wklaaks/azelctrl/docs/AZELCtrl_Product_Guide.md

# AZELCtrl — Complete Product Guide

**Version 1.5.1**  
**Author: ZS6TW**  
**Date: July 2026**

---

## 1. Introduction

### 1.1 What is AZELCtrl?

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

### 1.2 The Problem It Solves

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

### 1.3 Target Audience

This product is designed for amateur radio operators who:

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

---

## 2. Key Features & Benefits

### 2.1 Core Features

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

### 2.2 Benefits Over Traditional Controllers

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

---

## 3. How It Works (High-Level Overview)

### 3.1 System Architecture

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

**Option 1: USB Serial Connection (Simpler, Direct)**
```
                                                            ┌────────────────────────────────┐
                                                            │   PC, Mac, Pi with             │
                                                            │   Satellite Tracking Software  │
                                                            │   (Gpredict, Rotor,etc)        │
                                                            └─────────┬──────────────────────┘
                                                                      │        USB Serial
                                                            USB cable │ (virtual COM port, 5V power)
                                                                      │
                                            ┌─────────────────────────│─────────────────────────────────────────────┐
                                            │ AZELCtrl                │                                             │
                                            │                         ▼                                             │
                                            │                ┌──────────────────┐                                   │
                                            │                │ ESP8266 (NodeMCU)│                                   │
                                            │                └────────┬─────────┘                                   │
                                            │                         │ Power + GPIOs                               │
                                            │                         ▼                                             │
                                            │               ┌──────────────────┐    Motor VCC (12-14V)              │
                                            │               │   Motor Shield   │◄────────────────────────┐          │     
                                            │    ┌──────────┤    (L293DD)      │────────────────────────►│          │ 
                                            │    │          └──┬───────────────┘    L, R, U, D, GND      │          │
                                            │    │             │                                         │          │ 
                                            │    │             │ I2C bus                                 │          │
                                            │    │             │ (SDA/SCL)                               │          │
                                            │    │        ┌────┴────┐                                    │          │  
                                            │    │        │         │                                    │          │  
                                            │    │        ▼         ▼                                    │          │   
                                            │    │   ┌────────┐ ┌────────┐                               │          │
                                            │    │   │ OLED   │ │ ADS1115│       Az, El Voltages         │          │
                                            │    │   │Display │ │ ADC    │◄──────────────────────────────┤          │
                                            │    │   │(128×64)│ │        │                               │          │
                                            │    │   └────────┘ └────────┘                               │          │
                                            │    │       ▲          ▲                                    │          │
                                            │    └───────┴──────────┘                  Yaesu DIN-8 Cable │          │
                                            │       Power (3.3V) & GND                                   │          │
                                            └────────────────────────────────────────────────────────────│──────────┘
                                                                                                         │
                                                                                                         ▼
                                                        ┌─────────────────┐                    ┌───────────────────┐      
                                                        │   Rotator       │                    │ Yaesu Rotator     │
                                                        │  (antenna)      │   ◄──────────►     │ Controller        │      
                                                        │                 │                    │ (G-5600B etc.)    │      
                                                        └─────────────────┘                    └───────────────────┘          
```

**Option 2: WiFi/TCP Connection (Remote, Flexible)**
```
                                            ┌───────────────────────────────┐     WiFi      ┌────────────┐
                                            │   PC, Mac, Pi, Phone with     │ ◄───────────► │            │
                                            │   Satellite Tracking Software │    TCP/IP     │  WiFi AP   │
                                            │   (Gpredict, Rotor)           │               │            │
                                            └───────────────────────────────┘               └────────────┘
                                                                                                  ▲ 
                                                                                                  │ WiFi TCP/IP             
                                                            ┌──────────────────────┐              │
                                                            │   USB Power Supply   │              │
                                                            └─────────┬────────────┘              │
                                                                      │                           │
                                                            USB cable │ (5V power only)           │
                                                                      │                           │
                                            ┌─────────────────────────│───────────────────────────│─────────────────┐
                                            │ AZELCtrl                │                           │                 │
                                            │                         ▼                           │                 │
                                            │                ┌─────────────────────────┐          │                 │
                                            │                │ ESP8266 (NodeMCU)| Wifi │ ◄────────┘                 │
                                            │                └────────┬────────────────┘                            │
                                            │                         │ Power + GPIOs                               │
                                            │                         ▼                                             │
                                            │               ┌──────────────────┐    Motor VCC (12-14V)              │
                                            │               │   Motor Shield   │◄────────────────────────┐          │     
                                            │    ┌──────────┤    (L293DD)      │────────────────────────►│          │ 
                                            │    │          └──┬───────────────┘    L, R, U, D, GND      │          │
                                            │    │             │                                         │          │ 
                                            │    │             │ I2C bus                                 │          │
                                            │    │             │ (SDA/SCL)                               │          │
                                            │    │        ┌────┴────┐                                    │          │  
                                            │    │        │         │                                    │          │  
                                            │    │        ▼         ▼                                    │          │   
                                            │    │   ┌────────┐ ┌────────┐                               │          │
                                            │    │   │ OLED   │ │ ADS1115│       Az, El Voltages         │          │
                                            │    │   │Display │ │ ADC    │◄──────────────────────────────┤          │
                                            │    │   │(128×64)│ │        │                               │          │
                                            │    │   └────────┘ └────────┘                               │          │
                                            │    │       ▲          ▲                                    │          │
                                            │    └───────┴──────────┘                  Yaesu DIN-8 Cable │          │
                                            │       Power (3.3V) & GND                                   │          │
                                            └────────────────────────────────────────────────────────────│──────────┘
                                                                                                         │
                                                                                                         ▼
                                                        ┌─────────────────┐                    ┌───────────────────┐      
                                                        │   Rotator       │                    │ Yaesu Rotator     │
                                                        │  (antenna)      │   ◄──────────►     │ Controller        │      
                                                        │                 │                    │ (G-5600B etc.)    │      
                                                        └─────────────────┘                    └───────────────────┘     

```

**The single Yaesu DIN-8 cable carries all signals:**

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

**Which option should you use?**

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

### 3.2 Data Flow

AZELCtrl supports two communication interfaces:

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

### 3.3 Power Flow

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

---

## 4. Technical Details

### 4.1 Hardware Components

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

### 4.2 Pin Assignments

#### ESP8266 → Motor Shield (Hard-Wired)

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

#### ESP8266 → External Components

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

#### Motor Shield → Yaesu DIN-8

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

#### ADS1115 → Yaesu DIN-8 (Position Feedback)

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

### 4.3 Motor Control Theory

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

### 4.4 I2C Bus Architecture

Both the OLED display and ADS1115 share the I2C bus:

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

### 4.5 Communication Interfaces and Protocol Stack

AZELCtrl supports two communication interfaces:

#### USB Serial Interface

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

#### TCP/IP Network Interface

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

#### GS-232 Command Reference

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

#### rotctl Command Reference

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

### 4.6 Coordinate Transformations

#### Rotator Model Variants

AZELCtrl supports four rotator model configurations:

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

#### Auto-Stop Logic

AZELCtrl implements mechanical offset tracking for extended-range models:

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

#### Preventing Tracking Oscillations

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

### 4.7 EEPROM Layout

Configuration data is persisted in EEPROM across power cycles:

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

### 4.8 Safety Mechanisms

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

---

## 5. Over-the-Top (ELF) Tracking Mode

### 5.1 The Wrap-Around Problem

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

### 5.2 The Geometric Principle

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

This mechanical capability is the key to the over-the-top technique.

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

The transformation is:

```
Real Azimuth   = (Satellite Azimuth + 180°) mod 360°
Real Elevation = 180° − Satellite Elevation
```

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

### 5.3 How AZELCtrl Implements ELF Mode

AZELCtrl implements ELF mode as a transparent coordinate transformation layer. When enabled:

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

### 5.4 When to Use ELF Mode

The over-the-top transformation should be applied when:

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

The over-the-top transformation should **not** be applied when:

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

### 5.5 Practical Considerations

- **Elevation rotator capability**: Verify that your elevation rotator physically supports movement beyond 90°. The Yaesu G-5600B, for example, supports 0–180° of elevation travel.
- **Pre-positioning before AOS**: For over-the-top passes, the antenna must be pre-positioned to the starting position before the satellite rises. This typically means the elevation will be near 180° while waiting for AOS.
- **Polarisation effects**: Flipping the antenna over the top rotates the polarisation plane by 180°. For circular polarisation this is irrelevant. For linear polarisation, you may need to adjust the polarisation rotator or accept a polarisation mismatch.
- **Decision timing**: The decision to use over-the-top mode must be made **before** the pass begins, based on a pre-computed prediction of the complete azimuth track. Switching modes mid-pass would require a large, sudden azimuth slew that would lose the satellite.

---

## 6. Menu System Reference

### 6.1 Button Behavior Summary

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

**Button actions in rotator control mode**:

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

**Button actions in menus**:

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

**Understanding the menu footer**:

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

The separator between actions is a space and a period (` . `) or a pipe (` | `). For example:

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

The footer adapts to the current screen's available actions.

### 6.2 Startup Screens

#### Splash Screen

On power-up, AZELCtrl displays a splash screen for 3 seconds:

```
AZELCtrl

Ver: 1.5.1
Date: Jul 19 2026
By: ZS6TW
```

Shows product name, firmware version, build date, and author.

#### Missing Settings

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

```
Missing
Settings!
```

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

#### Boot Menu

If all mandatory settings are configured, the Boot menu appears:

```
Boot
----
Rotator Ctrl
Setup

· · · · · · · · · · · · · · · ·
1.Nav 1|Sel
```

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

#### WiFi Connecting

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

```
WiFi Connect

SSID: YourWifiSSID
Waiting: 3s
```

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

#### WiFi Connected

On successful connection:

```
Connected!

IP: 192.168.1.42
Signal: -65 dBm
SSID: YourWifiSSID
                    3
```

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

#### WiFi Failed

If the connection times out:

```
WiFi
Failed

SSID: YourWifiSSID

Status: WL_CONNECT_FAILED
```

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

### 6.3 Main Az/El Control Screen

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

**Normal idle state** (no movement, no protocol commands):

```
Az:  125.3d →
El:   45.2d ↑

Sel: LEFT    ELF

· · · · · · · · · · · · · · · ·
1.Cycle 2!Go
```

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

**When moving** (but no protocol commands showing):

```
Az:  125.3d
El:   45.2d

Moving: RIGHT

· · · · · · · · · · · · · · · ·
1.Cycle 2!Go
```

Line 3 shows `Moving: direction` instead of `Sel:` while motors are active.

**When receiving protocol commands** (if Show Commands is enabled):

```
Az:  125.3d
El:   45.2d

· · · · · · · · · · · · · · · ·
RX: C
TX: AZ=125 EL=045
```

Lines 3-4 show the last received command (RX) and response (TX). This overlay is suppressed for 5 seconds after any button press so the menu stays visible during interaction.

**SAFETY PAUSE screen** (shown when reversing direction):

```
SAFETY PAUSE
------------
AZ axis
125.3d El: 45.2d

· · · · · · · · · · · · · · · ·
1.Cycle 2!Go
```

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

**ELF Indicator**: When ELF mode is enabled, "ELF" is displayed right-aligned on the `Sel:` line.

### 6.4 SETUP Menu

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

```
SETUP
-----
Rot Variant (N360)
Rot Calibrate (Y)
Network
PC Interface
Wipe all settings

· · · · · · · · · · · · · · · ·
1.Nav  1|Sel  2.Back
```

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

#### Rotator Variant Selection Screen

Selecting "Rot Variant" opens a dedicated model selection screen:

```
Rotator Variant?
----------------
N360 (-180 to 180)
S360 (0 to 360)
N450 (-225 to 225)
S450 (-45 to 405)

· · · · · · · · · · · · · · · ·
1.Nav  1|Sel  2.Back
```

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

#### Voltage Calibration Menu

Selecting "Rot Calibrate" opens the calibration menu:

```
Voltage Calibration
-------------------
Azimuth
Elevation
Skip (Az=El=3.2V)

· · · · · · · · · · · · · · · ·
1.Nav  1|Sel  2.Back
```

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

See section 6.6 for details on the calibration screens.

#### Network Submenu

Selecting "Network" opens the network settings menu:

```
Network
-------
WiFi Mode(Station)
Hamlib Server (Y)

· · · · · · · · · · · · · · · ·
1.Nav  1|Sel  2.Back
```

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

##### WiFi Mode Submenu

Selecting the WiFi Mode line opens the WiFi Mode submenu:

```
WiFi Mode
---------
Station
Access Point
Disable

· · · · · · · · · · · · · · · ·
1.Nav  1|Sel  2.Back
```

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

##### Station Settings Screen

Selecting "Station" opens the Station Settings screen:

```
Wifi Station Settings
---------------------
Set via HTTP
Connect

SSID: YourNetworkName
Passwd: a*..*z

· · · · · · · · · · · · · · · ·
1.Nav  1|Sel  2.Back
```

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

##### AP Mode Menu

Selecting "Access Point" opens the AP Mode menu:

```
AP Mode
-------
AP Status
Regen AP Password

· · · · · · · · · · · · · · · ·
1.Nav  1|Sel  2.Back
```

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

**Note**: WPA2 requires a minimum of 8 characters for the password.

**AP Status screen** shows:
```
AP Status
---------
AP Mode Active
SSID: AZELCTRL_4D49A1
Pass: yaesu123
IP: 192.168.4.1

· · · · · · · · · · · · · · · ·
1.OK 2.Back
```

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

#### PC Interface Submenu

Selecting "PC Interface" opens the PC interface settings menu:

```
PC Interface
------------
Baud Rate: 115200
Show Commands: Yes
Reverse Delay: 1s
Protocol (GS-232B)

· · · · · · · · · · · · · · · ·
1.Nav  1|Sel  2.Back
```

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

##### Baud Rate Selection

Selecting "Baud Rate" opens:

```
Select Baud Rate
----------------
115200
57600
38400
19200
9600

· · · · · · · · · · · · · · · ·
1.Nav  1|Sel  2.Back
```

Selecting a baud rate applies it immediately and returns to the PC Interface menu.

##### Protocol Selection

Selecting "Protocol" opens:

```
Protocol
--------
GS-232A (Yaesu)
GS-232B (Hamlib)
Easycom

· · · · · · · · · · · · · · · ·
1.Nav  1|Sel  2.Back
```

Selecting a protocol applies it immediately and returns to the PC Interface menu.

#### Wipe All Settings

Selecting "Wipe all settings" shows a confirmation screen:

```
Wipe all settings
-----------------
This will erase ALL
saved settings.

Continue?

· · · · · · · · · · · · · · · ·
1.Wipe  2.Back
```

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

### 6.5 ELF Mode Toggle

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

### 6.6 Calibration Screens

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

#### Calibration Menu

```
Voltage Calibration
-------------------
Azimuth
Elevation
Skip (Az=El=3.2V)

· · · · · · · · · · · · · · · ·
1.Nav  1|Sel  2.Back
```

#### Azimuth/Elevation Calibration Screen

When calibration is running:

```
Cal-AZ: Sweep CCW
Moving CCW...
 AZ:  -180.0 ( 123mV)
 EL:    45.2 (2400mV)
· · · · · · · · · · · · · · · ·
1.Exit 2.Back
```

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

#### Skip Calibration

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

### 6.7 ELF Elevation Prompt

Appears when ELF mode is toggled (enabled or disabled).

```
Elevate To?
-----------
Horizon (0) [5]
45
90
Skip

· · · · · · · · · · · · · · · ·
1.Nav  1|Sel  2.Back
```

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

---

## 7. Construction Guide

### 7.1 Parts List

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

**Notes on optional items**:

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

### 7.2 Tools Required

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

### 7.3 Box Preparation

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

### 7.4 Mounting the OLED

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

### 7.5 Using the Ribbon Jumper Cable

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

**How to use the ribbon jumper cable**:

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

### 7.6 Wiring the Buttons

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

### 7.7 Wiring the I2C Bus

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

Solder the connections to the ADS1115 module for mechanical security rather than using jumper blocks.

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

### 7.8 Wiring the Yaesu DIN-8 Connector

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

**Practical tips**:

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

### 7.9 Power Connections

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

### 7.10 Potentiometer Calibration (Before First Power-Up)

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

Steps:

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

### 7.11 Firmware Installation

1. Install the Arduino IDE or arduino-cli on your computer.
2. Install the ESP8266 board package.
3. Install required libraries: SSD1306 OLED driver, ADS1115 driver, EEPROM library.
4. Open the AZELCtrl firmware sketch.
5. Select board: "NodeMCU 1.0 (ESP-12E Module)" or equivalent.
6. Select port: Your ESP8266's serial port.
7. Upload the firmware.
8. Power up the unit and verify the OLED displays the startup sequence.

**Note**: WiFi credentials are configured via the captive portal setup process (see section 7.12), not in the source code.

### 7.12 Configuring WiFi via Captive Portal

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

---

## 8. Operating the Device

### 8.1 Power-Up Sequence

1. Connect power via USB (or VIN terminal).
2. OLED displays the splash screen for 3 seconds:
   - Product name, firmware version, date, author
3. If mandatory settings are incomplete (rotator variant, calibration, WiFi mode), a "Missing Settings!" notice appears for 3 seconds, then the device goes directly to the SETUP menu.
4. Otherwise, the Boot menu appears:
   - "Rotator Ctrl" with a 3-second countdown (auto-selects if no button pressed)
   - "Setup" option
5. If "Rotator Ctrl" is selected and WiFi is configured:
   - WiFi connecting screen appears with SSID and elapsed time
   - On success: Connected screen with IP address, signal strength, 5-second countdown (press any button to skip)
   - On failure: "WiFi Failed!" screen for 2 seconds
6. OLED switches to the Az/El control screen.

### 8.2 Manual Control via Buttons

From the main Az/El control screen:

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

### 8.3 Remote Control via Web Interface

The web interface provides a touch-friendly control panel for operating the rotator from a phone, tablet, or computer.

**Accessing the web interface:**

- **AP Mode**: Connect to the AZELCTRL_XXXX network (password: yaesu123 or your custom password). The browser automatically opens to the Rotator Control page.
- **Station Mode**: Connect to the same WiFi network as AZELCtrl, then open a browser and navigate to the IP address shown on the OLED.

**Web interface features:**

- **Azimuth and Elevation** — Current position displayed with aligned decimal points
- **Moving status** — Shows current direction (IDLE, LEFT, RIGHT, UP, DOWN)
- **Directional buttons** — UP, LEFT, RIGHT, DOWN, and STOP arranged in a grid layout
- **Press and hold** — Tap and hold a direction button to move; release to stop
- **Real-time updates** — Position and status refresh every 300ms

### 8.4 Connecting Tracking Software

AZELCtrl can be controlled via USB serial or TCP/IP. Choose whichever interface suits your setup.

#### USB Serial Connection

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

#### TCP/IP Network Connection

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

#### Gpredict

Gpredict supports both USB serial and TCP/IP connections.

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

The connection path is: Gpredict → rotctld → AZELCtrl (USB serial).

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

#### Rotor

Rotor supports both USB serial and TCP/IP connections.

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

#### Other Tracking Software

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

### 8.5 Configuring via OLED Menus

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

## 9. Troubleshooting

### 9.1 OLED Shows Nothing

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

### 9.2 Motors Not Moving

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

### 9.3 ADS1115 Not Found

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

### 9.4 WiFi Connectivity Issues

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

### 9.5 Position Readings Incorrect

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

### 9.6 Tracking Software Connection Refused

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

---

## 10. Appendices

### 10.1 Yaesu DIN-8 Pinout Reference

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

### 10.2 ESP8266 Pin Mapping Table

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

### 10.3 Protocol Command Reference

#### GS-232B Commands

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

#### Easycom (EasyComm 2/3) Commands

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

#### rotctl Commands

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

### 10.4 EEPROM Layout

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

---

*End of Document*

*AZELCtrl — Built for amateur satellite operators, by amateur satellite operators.*

*73 ZS6TW*
