wklaaks/azelctrl/ycint/ycint.ino

/*********************************************************************
  Yaesu Rotator Controller - Menu System + WiFi Management
  
  Buttons:
    D8 (Btn1) - active HIGH
    D5 (Btn2) - active LOW
  
  I2C: SDA=D6 (GPIO12), SCL=D7 (GPIO13)
  ADS1115: Ch0 = Azimuth pot, Ch1 = Elevation pot
  
  MENU SYSTEM BUTTON BEHAVIOR:
    Btn1 short-press  = navigate cursor down (wraps to top)
    Btn1 long-press   = select current item
    Btn2              = go back to parent menu (or restart root menu)
    
  ROTATOR CONTROL BUTTON BEHAVIOR (preserved from original):
    Btn1 short-press  = cycle through directions
    Btn2 press        = START movement in selected direction
    Btn2 release      = STOP movement
    
  CALIBRATION BUTTON BEHAVIOR (preserved from original):
    Btn1              = exit calibration
    Btn2 press        = start scan / stop scan
    Btn2 long-press   = reverse direction during scanning
    
  WiFi modes:
    STA = connect to home WiFi (uses saved credentials)
    AP  = broadcast AZELCTRL for direct field access
*********************************************************************/

#include <Wire.h>
#include <Adafruit_SSD1306.h>
#include <Adafruit_ADS1X15.h>
#include <ESP8266WiFi.h>
#include <ESP8266WebServer.h>
#include <DNSServer.h>
#include <EEPROM.h>
#include <ESP8266HTTPClient.h>
#include <FS.h>
#include <cerrno>
#include <time.h>

// ==================== SPIFFS HTML ====================
// The ESP serves the HTML from SPIFFS (filesystem) if available,
// otherwise falls back to the compiled-in copy in PROGMEM.
// To upload: gzip -9 -c index.html > index.html.gz
//            curl -F "file=@index.html.gz" http://<ESP_IP>/upload
// World map coastline data is served separately from SPIFFS (/world_coastline.js)
// so the Map tab can show a warning if it's missing.
const char* spiffsHtmlFile = "/index.html.gz";
const char* spiffsCoastlineFile = "/world_coastline.js.gz";

// Compiled-in HTML fallback (gzip-compressed) — stored in flash via ICACHE_RODATA_ATTR
#include "index_gz.h"
// The xxd-generated array is named index_html_gz; wrap it for PROGMEM access
#define index_gz_size sizeof(index_html_gz)

// ==================== EEPROM LAYOUT ====================
// All settings in one contiguous block. Using 512 bytes = one full flash sector
// so ESP8266's EEPROM library loads everything into RAM on begin(). Every commit
// writes the complete sector atomically — no cross-contamination between saves.
#define EEPROM_SIZE        512

// Sector 0: WiFi credentials (bytes 0-66)
#define EEPROM_SSID_LEN    0
#define EEPROM_SSID_DATA   1
#define EEPROM_PASS_LEN    33
#define EEPROM_PASS_DATA   34
#define EEPROM_MAGIC_BYTE  66
#define EEPROM_MAGIC       0xAA

// Sector 1: Calibration data (bytes 67-83)
#define CAL_EEPROM_AZ_MIN  67
#define CAL_EEPROM_AZ_MAX  71
#define CAL_EEPROM_EL_MIN  75
#define CAL_EEPROM_EL_MAX  79
#define CAL_EEPROM_MAGIC   83
#define CAL_EEPROM_MAGIC_VAL 0xCA

// Sector 2: WiFi mode (bytes 84-85)
#define WIFI_MODE_EEPROM   84
#define WIFI_MODE_MAGIC    85
#define WIFI_MODE_MAGIC_VAL 0x4D

// Sector 3: Network settings (bytes 86-87)
#define EEPROM_NET_HAMLIB  86
#define EEPROM_NET_MAGIC   87
#define EEPROM_NET_MAGIC_VAL 0x4E

// Sector 4: Rotator model (bytes 88-89)
#define ROT_EEPROM_MODEL   88
#define ROT_EEPROM_MAGIC   89
#define ROT_EEPROM_MAGIC_VAL 0x5A

// ==================== FIRMWARE VERSION ====================
#define FIRMWARE_VERSION "1.5.11"
#define FIRMWARE_DATE __DATE__

// ==================== NETWORK PROTOCOL SERVER ====================
const int ROTCTL_PORT = 4533;  // Hamlib default port for rotctld
WiFiServer rotctlServer(ROTCTL_PORT);
WiFiClient rotctlClient;
bool rotctlConnected = false;
bool rotctlServerStarted = false;  // Guard against double init

// ==================== COMPILE-TIME DEBUG FLAGS ====================
// Set to 1 to enable debug output (prefixed with 'DBG:' for easy filtering)
// Set to 0 to disable all debug output (zero overhead)
#define DEBUG_ENABLED 0
#define DEBUG_PROTOCOL 1  // Debug protocol parsing details
#define DEBUG_MOVEMENT 1  // Debug movement commands

// Debug helper macros - output prefixed with 'DBG:' so Python tests can filter
#if DEBUG_ENABLED
  #define DBG_PRINT(msg) Serial.print("DBG:" msg)
  #define DBG_PRINTLN(msg) do { Serial.print("DBG:"); Serial.println(msg); } while(0)
  #define DBG_PRINT_VAL(val) Serial.print("DBG:" #val "="); Serial.print(val); Serial.println("")
#else
  #define DBG_PRINT(msg)
  #define DBG_PRINTLN(msg)
  #define DBG_PRINT_VAL(val)
#endif

// ==================== PROTOCOL CONFIGURATION ====================
// Enable GS-232A/B and Easycom protocol support
#define PROTOCOL_GS232A 1
#define PROTOCOL_GS232B 1
#define PROTOCOL_EASYCOM 1

// Baud rate for protocol serial communication (USB)
#define PROTOCOL_BAUD 115200

// Protocol command buffer size
#define PROTOCOL_BUF_SIZE 64

// ==================== PIN DEFINITIONS ====================
const int AZ_ENABLE  = 4;   // GPIO4
const int AZ_DIR_CW  = 0;   // GPIO0
const int EL_ENABLE  = 5;   // GPIO5
const int EL_DIR_UP  = 2;   // GPIO2

const int SDA_PIN = 12;     // GPIO12

const int SCL_PIN = 13;     // GPIO13

const int BTN1 = 15;         // GPIO15 - active HIGH
const int BTN2 = 14;         // GPIO14 - active LOW
// ==================== BUTTON TIMING ====================
const unsigned long BTN_DEBOUNCE_MS = 200;   // Debounce between presses
const unsigned long BTN_LONG_MS = 800;       // Long press threshold for menu select
const unsigned long BTN2_LONG_MS = 500;      // Btn2 long press for calibration reverse

// ==================== WiFi AP SETTINGS ====================
char apSsid[17];  // "AZELCTRL_" (9) + 4 hex digits + null = 14 max
const char* AP_IP   = "192.168.4.1";
char apPassword[9] = "yaesu123";  // 8 chars minimum for WPA2 + null terminator

// AP Password EEPROM storage (bytes 91-99: 8 chars + magic)
#define AP_PASS_EEPROM_START 91
#define AP_PASS_EEPROM_MAGIC 99
#define AP_PASS_EEPROM_MAGIC_VAL 0x41  // 'A'

void initApSsid() {
  uint8_t mac[6];
  WiFi.macAddress(mac);
  snprintf(apSsid, sizeof(apSsid), "AZELCTRL_%04X", (uint16_t)((mac[4] << 8) | mac[5]));
  Serial.println("AP SSID: " + String(apSsid));
}

// ==================== OBJECTS ====================
Adafruit_SSD1306 display(128, 64, &Wire, -1);
Adafruit_ADS1115 ads;
ESP8266WebServer server(80);
DNSServer dnsServer;

// ==================== STATE ====================
float currentAz = 0.0, currentEl = 0.0;
float azVoltage = 0.0, elVoltage = 0.0;  // Raw voltages from readPositions()
String currentMove = "IDLE";
bool adsPresent = false;
bool moving = false;

// WiFi mode: STA (connect to home), AP (field mode), or DISABLED
enum DeviceWifiMode { MODE_STA, MODE_AP, MODE_DISABLED };
DeviceWifiMode deviceWifiMode = MODE_DISABLED;

// ==================== GS-232A/B & EASYCOM PROTOCOL ====================
// Protocol command buffer
char protocolBuf[PROTOCOL_BUF_SIZE];
int protocolBufIdx = 0;

// Protocol state
bool protocolActive = false;
unsigned long protocolLastCmd = 0;
const unsigned long PROTOCOL_TIMEOUT_MS = 5000;

// Configurable protocol baud rate (stored in EEPROM)
// Supported: 9600, 19200, 38400, 57600, 115200
const long PROTOCOL_BAUD_RATES[] = {9600, 19200, 38400, 57600, 115200};
const int PROTOCOL_BAUD_COUNT = 5;
int protocolBaudIndex = 4;  // Default: 115200 (index 4)

// Show received commands on OLED (default: true)
bool protocolShowCommands = true;
char protocolLastCommand[PROTOCOL_BUF_SIZE];  // Last received command for display
char protocolLastResponse[PROTOCOL_BUF_SIZE];  // Last sent response for display

// Time of last received protocol char — used to detect stalled partial commands
unsigned long protocolLastRxTime = 0;
const unsigned long PROTOCOL_PARTIAL_TIMEOUT_MS = 500;  // Stalled partial command flush

// Transient OLED warning for protocol errors (auto-clears after 5s)
char oledWarnText[21] = "";
unsigned long oledWarnUntil = 0;
void showOledWarning(const char* msg) {
  strncpy(oledWarnText, msg, sizeof(oledWarnText) - 1);
  oledWarnText[sizeof(oledWarnText) - 1] = '\0';
  oledWarnUntil = millis() + 5000;
}

// Suppress RX/TX overlay on OLED for 5s after any button press
// This prevents continuous client polling from hiding the menu
unsigned long oledCmdSuppressUntil = 0;
const unsigned long OLED_CMD_SUPPRESS_MS = 5000;

void resetOledCmdSuppress() {
  oledCmdSuppressUntil = millis() + OLED_CMD_SUPPRESS_MS;
}

// TCP input buffer (Default Protocol over TCP)
char tcpProtocolBuf[PROTOCOL_BUF_SIZE];
int tcpProtocolBufIdx = 0;

// ==================== PROTOCOL DEBUG LOG ====================
// RAM-only ring buffer capturing raw protocol traffic (RX + TX) on both the
// USB serial and TCP interfaces, for diagnosing external tracking software.
// Zero flash wear: nothing is written to the filesystem. Capture is armed
// only while a debug client polls /debug-log (auto-disarms 5 s after the
// last poll) — opening the debug tab starts logging, closing it stops it.
#define DBGLOG_MAX_ENTRIES 96
#define DBGLOG_MSG_MAX     56
struct DbgLogEntry {
  uint32_t t;      // millis() at capture
  uint8_t dir;     // 'R' = received, 'T' = transmitted
  uint8_t src;     // 'S' = USB serial, 'T' = TCP, 'C' = console
  uint8_t len;     // escaped message length
  char msg[DBGLOG_MSG_MAX];
};  // 64 bytes
static DbgLogEntry dbgLogBuf[DBGLOG_MAX_ENTRIES];  // ~6 KB static RAM
static uint32_t dbgLogSeq = 0;        // entries captured this session
static bool dbgLogArmed = false;
static unsigned long dbgLogLastPollMs = 0;
const unsigned long DBGLOG_IDLE_DISARM_MS = 5000;

void dbgLogArm(bool fresh) {
  if (fresh || !dbgLogArmed) {
    dbgLogArmed = true;
    dbgLogSeq = 0;
    memset(dbgLogBuf, 0, sizeof(dbgLogBuf));  // clear stale slots from previous sessions
  }
  dbgLogLastPollMs = millis();
}

// ==================== TIME REFERENCE (wall-clock timestamps) ====================
// The ESP8266 has no RTC. Debug-log entries store millis() since boot; wall-clock
// time is derived at render time:  epoch_ms = refEpoch*1000 + (t - refMillis).
// The reference is set by NTP (STA mode with internet) or by the one-click
// browser sync on the /debug-usb page (works in AP mode too). The display
// offset (user's UTC offset) persists across reboots (EEPROM bytes 106-110).
#define TIME_OFFSET_EEPROM   106   // int32 UTC offset seconds (bytes 106-109)
#define TIME_MAGIC_EEPROM    110   // 0x74 't' when the offset is valid

uint32_t timeRefEpoch = 0;      // epoch seconds captured at timeRefMillis (0 = unset)
uint32_t timeRefMillis = 0;     // millis() when the reference was captured
int32_t  timeOffsetSec = 0;     // display offset (persisted)
char     timeSource[5] = "none";  // "NTP" | "SYNC" | "none"
static uint32_t lastTimeCheckMs = 0;

// ====================== ROTOR POWER PRESENCE (v1.5.11) =====================
// DIN-8 pin 7 carries the Yaesu controller's +12 V supply to the motor-shield
// VM rail. A 1.3 MOhm / 200 kOhm divider brings that down to ~1.6 V on
// ADS1115 A2 at 12 V - and only ~2.7 V even during the Yaesu's poorly
// regulated 20 V spikes, comfortably inside the ADS1115's absolute-max
// input rating. Unplugged or unpowered controller => A2 sits at ~0 V.
// Config flag: EEPROM byte 111 (0x00 = disabled; anything else, including
// blank 0xFF, = enabled). Default is ENABLED.
#define ROTOR_DETECT_EEPROM 111
bool  rotorPowerDetectEnabled = true;  // loaded from EEPROM in setup()
bool  rotorOnline = true;              // live presence state (debounced)
float rotorVmV = 0.0f;                 // latest divided A2 reading (V), for /diag
uint8_t rotorLowCount = 0;             // debounce counters (file scope so the
uint8_t rotorHighCount = 0;            // settings handler can reset them)

bool timeRefValid() { return timeRefEpoch > 1000000000u; }  // after year 2001

void setTimeRef(uint32_t epochSec, const char* src) {
  timeRefEpoch = epochSec;
  timeRefMillis = millis();
  strncpy(timeSource, src, sizeof(timeSource) - 1);
  timeSource[sizeof(timeSource) - 1] = '\0';
}

void loadTimeOffset() {
  if (EEPROM.read(TIME_MAGIC_EEPROM) != 0x74) return;
  uint32_t v = ((uint32_t)EEPROM.read(TIME_OFFSET_EEPROM) << 24) |
               ((uint32_t)EEPROM.read(TIME_OFFSET_EEPROM + 1) << 16) |
               ((uint32_t)EEPROM.read(TIME_OFFSET_EEPROM + 2) << 8) |
               (uint32_t)EEPROM.read(TIME_OFFSET_EEPROM + 3);
  timeOffsetSec = (int32_t)v;
}

void saveTimeOffset() {
  uint32_t v = (uint32_t)timeOffsetSec;
  EEPROM.write(TIME_OFFSET_EEPROM, (v >> 24) & 0xFF);
  EEPROM.write(TIME_OFFSET_EEPROM + 1, (v >> 16) & 0xFF);
  EEPROM.write(TIME_OFFSET_EEPROM + 2, (v >> 8) & 0xFF);
  EEPROM.write(TIME_OFFSET_EEPROM + 3, v & 0xFF);
  EEPROM.write(TIME_MAGIC_EEPROM, 0x74);
  EEPROM.commit();
}

// Start NTP (best effort). In AP mode there is no uplink and this never
// succeeds - the browser sync button on /debug-usb covers that case.
void initTimeNtp() {
  configTime(0, 0, "pool.ntp.org", "time.cloudflare.com");
  Serial.println("TIME: NTP configured");
}

// ====================== ROTOR POWER PRESENCE =====================
// Thresholds with hysteresis at the divided A2 node (k = 200/1500 = 1/7.5):
//   ONLINE  >= 1.0 V  (VM >= ~7.5 V)
//   OFFLINE <  0.6 V  (VM <  ~4.5 V)
// The 0.6-1.0 V deadband holds both counters, so motor-load sags and plug
// transients cannot flap the state, but a sustained low still transitions.
const float ROTOR_ONLINE_V  = 1.0f;
const float ROTOR_OFFLINE_V = 0.6f;
const uint8_t ROTOR_DEBOUNCE = 5;      // 5 x 500 ms = 2.5 s to confirm

void setRotorOnline(bool on) {
  if (on == rotorOnline) return;
  rotorOnline = on;
  const char* msg = on ? "ROTOR: online" : "ROTOR: offline";
  Serial.println(msg);
  dbgLogCapture("TX", "CON", msg);
}

void checkRotorPower() {
  if (!rotorPowerDetectEnabled || !adsPresent) return;
  static unsigned long lastCheck = 0;
  unsigned long now = millis();
  if (now - lastCheck < 500) return;
  lastCheck = now;
  // Same PGA as the position pots (+-4.096 V range): 1 mV per LSB.
  rotorVmV = ads.readADC_SingleEnded(2) / 32768.0 * 4.096F;
  if (rotorVmV < ROTOR_OFFLINE_V) {
    if (rotorLowCount < 250) rotorLowCount++;
    rotorHighCount = 0;
  } else if (rotorVmV >= ROTOR_ONLINE_V) {
    if (rotorHighCount < 250) rotorHighCount++;
    rotorLowCount = 0;
  }
  // Deadband (0.6-1.0 V): neither counter moves.
  if (!rotorOnline && rotorHighCount >= ROTOR_DEBOUNCE) setRotorOnline(true);
  else if (rotorOnline && rotorLowCount >= ROTOR_DEBOUNCE) setRotorOnline(false);
}

void loadRotorDetectSetting() {
  // 0x00 = explicitly disabled; blank (0xFF) or 0xFF = enabled (default ON)
  rotorPowerDetectEnabled = (EEPROM.read(ROTOR_DETECT_EEPROM) != 0x00);
}

void saveRotorDetectSetting() {
  EEPROM.write(ROTOR_DETECT_EEPROM, rotorPowerDetectEnabled ? 0xFF : 0x00);
  EEPROM.commit();
}

// Pick up NTP results once every 30 s while WiFi is connected.
// The reference is re-baselined SILENTLY each cycle so SNTP step
// corrections are absorbed, but only GENUINE transitions are logged:
// first acquisition (none->NTP) or NTP taking over from a manual browser
// sync (SYNC->NTP). Logging every 30 s would fill the ring with duplicate
// "NTP synced" entries and push real protocol traffic out of the buffer.
void checkTimeSync() {
  unsigned long now = millis();
  if (now - lastTimeCheckMs < 30000) return;
  lastTimeCheckMs = now;
  if (WiFi.status() != WL_CONNECTED) return;
  time_t t = time(nullptr);
  if (t <= 1000000000) return;
  bool fresh = !timeRefValid();
  bool upgrade = (strcmp(timeSource, "SYNC") == 0);
  setTimeRef((uint32_t)t, "NTP");
  if (fresh) {
    Serial.print("TIME: NTP synced, epoch=");
    Serial.println(t);
    dbgLogCapture("TX", "CON", "TIME: NTP synced");
  } else if (upgrade) {
    Serial.println("TIME: NTP active (supersedes manual sync)");
    dbgLogCapture("TX", "CON", "TIME: NTP active (supersedes manual sync)");
  }
}

// Howard Hinnant's civil-from-days (proleptic Gregorian, all dates).
static void civilFromDays(int64_t z, int& y, int& m, int& d) {
  z += 719468;
  int64_t era = (z >= 0 ? z : z - 146096) / 146097;
  int32_t doe = (int32_t)(z - era * 146097);                     // [0, 146096]
  int32_t yoe = (doe - doe / 1460 + doe / 36524 - doe / 146096) / 365;  // [0, 399]
  int32_t yy  = (int32_t)era * 400 + yoe;
  int32_t doy = doe - (365 * yoe + yoe / 4 - yoe / 100);         // [0, 365]
  int32_t mp  = (5 * doy + 2) / 153;                             // [0, 11]
  d = doy - (153 * mp + 2) / 5 + 1;                              // [1, 31]
  m = mp + (mp < 10 ? 3 : -9);                                   // [1, 12]
  y = yy + (m <= 2);  // Jan/Feb fall in the previous year (March-based calendar)
}

// Line prefix for a captured entry: "[<boot-ms>] YYYY-MM-DD HH:MM:SS.mmm "
// when a time reference is set, else just "[<boot-ms>] ". out >= 40 bytes.
// Entries captured more than an hour BEFORE the reference (i.e. it landed
// mid-session) fall back to the bare form - their wall time would be bogus.
static void formatLogPrefix(uint32_t tBootMs, char* out, size_t n) {
  if (!timeRefValid()) {
    snprintf(out, n, "[%lu] ", (unsigned long)tBootMs);
    return;
  }
  uint32_t delta = tBootMs - timeRefMillis;  // uint32 wrap = correct ms delta
  if (delta > 3600000u) {
    snprintf(out, n, "[%lu] ", (unsigned long)tBootMs);
    return;
  }
  uint64_t totalMs = (uint64_t)timeRefEpoch * 1000ULL + (uint64_t)delta;
  int64_t localSec = (int64_t)(totalMs / 1000ULL) + timeOffsetSec;
  uint32_t ms = (uint32_t)(totalMs % 1000ULL);
  int64_t days = localSec / 86400;
  int32_t secOfDay = (int32_t)(localSec - days * 86400);
  int y, m, d;
  civilFromDays(days, y, m, d);
  snprintf(out, n, "[%lu] %04d-%02d-%02d %02d:%02d:%02d.%03lu ",
           (unsigned long)tBootMs, y, m, d,
           secOfDay / 3600, (secOfDay / 60) % 60, secOfDay % 60, (unsigned long)ms);
}

// Current device time as "YYYY-MM-DD HH:MM:SS" (JSON status + file header).
// Returns false when no reference is set.
static bool formatDeviceTime(char* out, size_t n) {
  if (!timeRefValid()) return false;
  uint64_t totalMs = (uint64_t)timeRefEpoch * 1000ULL +
                     (uint64_t)(uint32_t)(millis() - timeRefMillis);
  int64_t localSec = (int64_t)(totalMs / 1000ULL) + timeOffsetSec;
  int64_t days = localSec / 86400;
  int32_t secOfDay = (int32_t)(localSec - days * 86400);
  int y, m, d;
  civilFromDays(days, y, m, d);
  snprintf(out, n, "%04d-%02d-%02d %02d:%02d:%02d", y, m, d,
           secOfDay / 3600, (secOfDay / 60) % 60, secOfDay % 60);
  return true;
}

// Escape control chars so the log reads as plain text (\r \n \t \\ \" \xNN).
// The output is also safe to embed in JSON strings.
static void dbgLogEscape(const char* in, int inLen, char* out, int maxOut) {
  static const char hexd[] = "0123456789abcdef";
  int o = 0;
  for (int i = 0; i < inLen && o + 4 < maxOut; i++) {
    char c = in[i];
    if (c == '\r')                        { out[o++] = '\\'; out[o++] = 'r'; }
    else if (c == '\n')                   { out[o++] = '\\'; out[o++] = 'n'; }
    else if (c == '\t')                   { out[o++] = '\\'; out[o++] = 't'; }
    else if (c == '\\' || c == '"')       { out[o++] = '\\'; out[o++] = c; }
    else if (c >= 0x20 && c < 0x7f)       { out[o++] = c; }
    else {
      out[o++] = '\\'; out[o++] = 'x';
      out[o++] = hexd[(c >> 4) & 0xF]; out[o++] = hexd[c & 0xF];
    }
  }
  out[o] = '\0';
}

// Escape backslashes for JSON embedding. The message is already printable-safe
// (control chars rendered as \r \n \xNN two-char sequences); without this, JSON
// parsing would reinterpret those sequences and corrupt the line.
static void dbgLogJsonEscape(const char* in, char* out, int maxOut) {
  int o = 0;
  for (int i = 0; in[i] != '\0' && o + 3 < maxOut; i++) {
    if (in[i] == '\\') out[o++] = '\\';
    out[o++] = in[i];
  }
  out[o] = '\0';
}

// Capture one line while armed. dir: "RX"/"TX", src: "SER"/"TCP"/"CON".
void dbgLogCapture(const char* dir, const char* src, const char* text) {
  if (!dbgLogArmed) return;
  char esc[DBGLOG_MSG_MAX];
  dbgLogEscape(text, (int)strlen(text), esc, DBGLOG_MSG_MAX);
  DbgLogEntry& e = dbgLogBuf[dbgLogSeq % DBGLOG_MAX_ENTRIES];
  e.t = millis();
  e.dir = dir[0];
  e.src = src[0];
  e.len = (uint8_t)strlen(esc);
  memcpy(e.msg, esc, e.len + 1);
  dbgLogSeq++;
}

// Protocol target tracking — auto-stop when target is reached
bool protocolTargetAzSet = false;
bool protocolTargetElSet = false;
float protocolTargetAz = 0.0;
float protocolTargetEl = 0.0;
const float PROTOCOL_STOP_TOLERANCE = 3.0; // Degrees — don't start movement if within this range

// Protocol variant selection (stored in EEPROM)
enum ProtocolVariant {
  PROTO_GS232A,   // Yaesu original format (+nnnn+nnnn)
  PROTO_GS232B,   // Hamlib standard (AZ=nnn   EL=nnn)
  PROTO_EASYCOM   // Easycom protocol
};
ProtocolVariant currentProtocol = PROTO_GS232A;  // Default: GS-232A


// Direction reversal safeguard — configurable delay before reversing direction
int protocolReverseDelay = 1;  // Default: 1 second
bool protocolAzReversing = false;
bool protocolElReversing = false;
unsigned long protocolAzReverseStart = 0;
unsigned long protocolElReverseStart = 0;
String protocolAzPendingDir = "";
String protocolElPendingDir = "";

// ELF (Elevation Flip / Over-the-top) mode
// When enabled, transforms satellite coordinates to physical rotator coordinates
// Real Az = (Sat Az + 180) % 360, Real El = 180 - Sat El
bool elfMode = false;
#define ELF_EEPROM_BYTE 90

// ELF transformation functions (self-inverse)
float elfTransformAz(float satAz) {
  float realAz = fmod(satAz + 180.0f, 360.0f);
  if (realAz < 0) realAz += 360.0f;
  return realAz;
}
float elfTransformEl(float satEl) {
  return 180.0f - satEl;
}

// Conditional wrappers - only transform when elfMode is ON
float elfAz(float az) {
  return elfMode ? elfTransformAz(az) : az;
}
float elfEl(float el) {
  return elfMode ? elfTransformEl(el) : el;
}

// Motor engagement delay — suppress stale position readings while motors ramp up
// Must be short enough that Gpredict sees progress before giving up (~1.5s timeout)
// 200ms allows ADC sliding window (4x100ms) to stabilize without triggering Gpredict abort
const unsigned long MOTOR_ENGAGE_DELAY_MS = 200;
unsigned long azEngageStart = 0;
unsigned long elEngageStart = 0;
float azPositionAtEngage = 0.0;  // Last known good position when motors started
float elPositionAtEngage = 0.0;

long getProtocolBaud() {
  return PROTOCOL_BAUD_RATES[protocolBaudIndex];
}

// Protocol-specific response formatting helpers
void formatPositionResponse(char* buf, size_t bufsize, int azDeg, int elDeg, const char* suffix) {
  switch (currentProtocol) {
    case PROTO_GS232A:
      // Yaesu original format: +nnnn+nnnn [suffix]
      if (suffix && suffix[0]) {
        snprintf(buf, bufsize, "+%04d+%04d %s", azDeg, elDeg, suffix);
      } else {
        snprintf(buf, bufsize, "+%04d+%04d", azDeg, elDeg);
      }
      break;
      
    case PROTO_GS232B:
      // Hamlib standard: AZ=nnn EL=nnn [suffix]
      if (suffix && suffix[0]) {
        snprintf(buf, bufsize, "AZ=%03d EL=%03d %s", azDeg, elDeg, suffix);
      } else {
        snprintf(buf, bufsize, "AZ=%03d EL=%03d", azDeg, elDeg);
      }
      break;
      
    case PROTO_EASYCOM:
      // Easycom: AZnnn.0ELnnn.0 [suffix]
      if (suffix && suffix[0]) {
        snprintf(buf, bufsize, "AZ%d.0EL%d.0 %s", azDeg, elDeg, suffix);
      } else {
        snprintf(buf, bufsize, "AZ%d.0EL%d.0", azDeg, elDeg);
      }
      break;
  }
}

// Interface that delivered the current/most-recent protocol command.
// Replies are always returned over the SAME interface the command arrived on:
// RX_SRC_SER -> USB serial wire, RX_SRC_TCP -> rotctl TCP client. Never cross.
enum ProtocolRxSource { RX_SRC_NONE = 0, RX_SRC_SER, RX_SRC_TCP };
uint8_t protocolRxSource = RX_SRC_NONE;

// Get protocol-specific line ending
// Hamlib source: gs232a.c REPLY_EOM="\n", gs232b.c REPLY_EOM="\r\n"
const char* getProtocolLineEnding() {
  switch (currentProtocol) {
    case PROTO_GS232A:
      return "\n";     // GS-232A: hamlib reads until LF only
    case PROTO_GS232B:
      return "\r\n";   // GS-232B: hamlib reads until CRLF
    case PROTO_EASYCOM:
      return "\n";     // Easycom: hamlib reads until LF only
  }
  return "\r\n";
}

// Process command based on current protocol variant
void processProtocolCommand(const char* cmd, int len) {
  switch (currentProtocol) {
    case PROTO_GS232A:
    case PROTO_GS232B:
      processGs232Command(cmd, len);
      break;
    case PROTO_EASYCOM:
      processEasycomCommand(cmd, len);
      break;
  }
}


// EEPROM storage for protocol settings (bytes 100-104 — must not overlap with calibration at 67-83)
#define EEPROM_PROTO_BAUD_IDX 100
#define EEPROM_PROTO_SHOW_CMDS 101
#define EEPROM_PROTO_REVERSE_DELAY 103
#define EEPROM_PROTO_MAGIC    102
#define EEPROM_PROTO_MAGIC_VAL 0xB7
#define EEPROM_PROTO_VARIANT 104

// Load protocol settings from EEPROM
void loadProtocolSettings() {
  uint8_t magic = EEPROM.read(EEPROM_PROTO_MAGIC);
  if (magic == EEPROM_PROTO_MAGIC_VAL) {
    uint8_t idx = EEPROM.read(EEPROM_PROTO_BAUD_IDX);
    if (idx < PROTOCOL_BAUD_COUNT) {
      protocolBaudIndex = idx;
    }
    uint8_t show = EEPROM.read(EEPROM_PROTO_SHOW_CMDS);
    protocolShowCommands = (show == 1);
    uint8_t revDelay = EEPROM.read(EEPROM_PROTO_REVERSE_DELAY);
    if (revDelay <= 3) {
      protocolReverseDelay = revDelay;
    }
    uint8_t variant = EEPROM.read(EEPROM_PROTO_VARIANT);
    if (variant <= 2) {
      currentProtocol = (ProtocolVariant)variant;
    }
  }
}

// Save protocol settings to EEPROM
void saveProtocolSettings() {
  EEPROM.write(EEPROM_PROTO_BAUD_IDX, (uint8_t)protocolBaudIndex);
  EEPROM.write(EEPROM_PROTO_SHOW_CMDS, (uint8_t)(protocolShowCommands ? 1 : 0));
  EEPROM.write(EEPROM_PROTO_REVERSE_DELAY, (uint8_t)protocolReverseDelay);
  EEPROM.write(EEPROM_PROTO_VARIANT, (uint8_t)currentProtocol);
  EEPROM.write(EEPROM_PROTO_MAGIC, EEPROM_PROTO_MAGIC_VAL);
  EEPROM.commit();
}

// ==================== DISPLAY SETTINGS (EEPROM byte 105) ====================
// 1 = show decimal degrees (one decimal digit) for Az/El; any other value
// (0 or erased 0xFF) = whole degrees. Default OFF.
#define EEPROM_DISP_AZEL_DECIMALS 105
bool azElDisplayDecimals = false;

void loadDisplaySettings() {
  azElDisplayDecimals = (EEPROM.read(EEPROM_DISP_AZEL_DECIMALS) == 1);
}

void saveDisplaySettings() {
  EEPROM.write(EEPROM_DISP_AZEL_DECIMALS, azElDisplayDecimals ? 1 : 0);
  EEPROM.commit();
}

// Restart serial with new baud rate
void applyProtocolBaud() {
  Serial.end();
  delay(100);
  Serial.begin(getProtocolBaud());
  DBG_PRINT("Protocol baud set to: "); DBG_PRINTLN(getProtocolBaud());
}

// Helper: parse integer from buffer starting at index, returns length consumed (0 if none)
int parseNumber(const char* buf, int start, int* num, int* consumed) {
  int i = start;
  int len = strlen(buf);
  bool negative = false;
  int value = 0;
  
  if (i < len && buf[i] == '-') {
    negative = true;
    i++;
  }
  
  while (i < len && buf[i] >= '0' && buf[i] <= '9') {
    value = value * 10 + (buf[i] - '0');
    i++;
  }
  
  if (i == start) {
    *consumed = 0;
    return -1;  // No number found
  }
  
  *num = negative ? -value : value;
  *consumed = i - start;
  return 0;
}



// ==================== MENU SYSTEM ====================
typedef void (*MenuAction)();

struct MenuItem {
  const char* label;
  MenuAction action;
  int timerSeconds;     // 0 = no timer, >0 = countdown
  bool visible;         // Dynamic visibility
  bool (*isSelectable)();  // nullptr = always selectable; returns false = selection blocked
  // When blocked, this returns which item indices (0-based) are the blockers, for footer display
  int (*blockerIndices)(int* indices, int maxCount);  // Returns count of blockers written to indices[]
};

class Menu {
public:
  Menu(const char* title, MenuItem* items, int itemCount, Menu* parent = nullptr)
    : title(title), items(items), itemCount(itemCount), parent(parent),
      cursor(0), scrollOffset(0), timerStart(0), timerActive(false), userInteracted(false), footerText(nullptr) {}

  void setParent(Menu* p) {
    parent = p;
  }

  void init() {
    cursor = 0;
    scrollOffset = 0;
    timerActive = false;
    timerStart = 0;
    userInteracted = false;  // Reset: timer can auto-start again
    moveToFirstVisible();
    // Auto-start timer on the first visible item that has one
    for (int i = 0; i < itemCount; i++) {
      if (items[i].visible && items[i].timerSeconds > 0) {
        cursor = i;
        startTimer();
        return;
      }
    }
  }

  void setFooter(const char* text) {
    footerText = text;
  }

  void navigate() {
    userInteracted = true;  // Cancel auto-timer on any button press
    timerActive = false;
    int next = cursor + 1;
    if (next >= itemCount) next = 0;
    moveToVisibleFrom(next);
    updateScroll();
  }

  // Update scroll offset so the cursor is always visible
  // When cursor moves to row VISIBLE_ROWS, scroll up by 1
  // When wrapping (cursor < scrollOffset), reset scroll
  void updateScroll() {
    // Count visible items to find the actual visible range
    int visibleCount = 0;
    for (int i = scrollOffset; i < itemCount && visibleCount < VISIBLE_ROWS; i++) {
      if (items[i].visible) visibleCount++;
    }
    
    // If cursor is below the visible area, scroll down
    while (cursor >= scrollOffset + visibleCount) {
      scrollOffset++;
    }
    
    // If cursor wrapped to top (above scroll area), reset scroll
    if (cursor < scrollOffset) {
      scrollOffset = 0;
    }
  }

  void select() {
    userInteracted = true;  // Cancel auto-timer on any button press
    timerActive = false;
    if (cursor >= 0 && cursor < itemCount && items[cursor].visible && items[cursor].action) {
      // Check if selection is allowed
      if (items[cursor].isSelectable == nullptr || items[cursor].isSelectable()) {
        items[cursor].action();
      }
    }
  }

  // Check if current item is selectable (for footer display)
  bool isCurrentSelectable() {
    if (cursor < 0 || cursor >= itemCount) return true;
    if (items[cursor].isSelectable == nullptr) return true;
    return items[cursor].isSelectable();
  }

  // Get blocker indices for current item (1-based for display)
  // Returns count of blockers written to indices[] (as 1-based values)
  int getBlockerIndices(int* indices, int maxCount) {
    if (cursor < 0 || cursor >= itemCount) return 0;
    if (items[cursor].blockerIndices == nullptr) return 0;
    int raw[4];
    int count = items[cursor].blockerIndices(raw, 4);
    int out = 0;
    for (int i = 0; i < count && out < maxCount && out < 4; i++) {
      indices[out++] = raw[i] + 1;  // Convert to 1-based
    }
    return out;
  }

  void back() {
    userInteracted = true;
    timerActive = false;
    if (parent) {
      parent->cursor = cursor;
      parent->draw();
      extern Menu* currentMenu;
      currentMenu = parent;
    } else {
      init();
    }
  }
  
  Menu* getParent() {
    return parent;
  }

  void tick() {
    // Don't auto-fire if user has interacted or item is not selectable
    if (timerActive && !userInteracted && cursor >= 0 && cursor < itemCount) {
      int remaining = items[cursor].timerSeconds - (int)((millis() - timerStart) / 1000);
      if (remaining <= 0) {
        timerActive = false;
        if (items[cursor].visible && items[cursor].action) {
          // Check if selection is allowed
          if (items[cursor].isSelectable == nullptr || items[cursor].isSelectable()) {
            items[cursor].action();
          }
        }
      }
    }
  }

  int timerRemaining() {
    if (!timerActive) return 0;
    if (cursor < 0 || cursor >= itemCount) return 0;
    int remaining = items[cursor].timerSeconds - (int)((millis() - timerStart) / 1000);
    return max(0, remaining);
  }

  void startTimer() {
    if (cursor >= 0 && cursor < itemCount && items[cursor].timerSeconds > 0) {
      timerActive = true;
      timerStart = millis();
    }
  }

  void draw() {
    display.clearDisplay();
    display.setTextSize(1);
    
    // Title bar (white on black)
    display.fillRect(0, 0, 128, 8, SSD1306_BLACK);
    display.setTextColor(SSD1306_WHITE, SSD1306_BLACK);
    display.setCursor(0, 0);
    String titleLine = String(title) + " ";
    while (titleLine.length() < 16) titleLine += " ";
    display.print(titleLine);
    
    // Solid white line below title
    display.drawLine(0, 8, 127, 8, SSD1306_WHITE);
    
    // Menu items - start 1 row below separator, with scrolling
    int y = 10;
    int visibleDrawn = 0;
    for (int i = scrollOffset; i < itemCount && visibleDrawn < VISIBLE_ROWS; i++) {
      if (!items[i].visible) continue;
      
      if (i == cursor) {
        // Selected - inverted background
        display.fillRect(0, y, 128, 8, SSD1306_WHITE);
        display.setTextColor(SSD1306_BLACK, SSD1306_WHITE);
      } else {
        display.setTextColor(SSD1306_WHITE);
      }
      
      display.setCursor(2, y);
      String line = String(items[i].label);
      
      // Append timer if active on this item
      if (i == cursor && timerActive && items[i].timerSeconds > 0) {
        line += "[" + String(timerRemaining()) + "]";
      }
      
      display.print(line);
      y += 11;
      visibleDrawn++;
    }
    
    // Dotted separator above footer
    for (int x = 0; x < 128; x += 3) {
      display.drawPixel(x, 53, SSD1306_WHITE);
    }
    
    // Footer
    display.setTextColor(SSD1306_WHITE);
    display.setCursor(0, 56);
    if (!isCurrentSelectable()) {
      // Inhibited footer takes priority — show blocker indices
      int blockers[4];
      int count = getBlockerIndices(blockers, 4);
      char footerBuf[24] = "1.Nav  Sel[";
      int pos = 11;
      for (int i = 0; i < count && pos < 22; i++) {
        if (i > 0) {
          if (pos < 21) footerBuf[pos++] = ',';
        }
        int tens = blockers[i] / 10;
        int ones = blockers[i] % 10;
        if (tens > 0 && pos < 20) footerBuf[pos++] = '0' + tens;
        if (pos < 21) footerBuf[pos++] = '0' + ones;
      }
      if (pos < 23) footerBuf[pos++] = ']';
      footerBuf[pos] = '\0';
      display.println(footerBuf);
    } else if (footerText) {
      display.println(footerText);
    } else {
      display.println("1.Nav 1|Sel 2.Back");
    }
    
    display.display();
  }

  // Static helper for quick 3-line notices (no header/footer, big text)
  // center: true = center align, false = left align (default)
  static void drawQuickNotice(const char* line1, const char* line2, const char* line3, bool center = false) {
    display.clearDisplay();
    display.setTextSize(2);
    display.setTextColor(SSD1306_WHITE);
    
    if (center) {
      int x1 = (int)max((int)0, (int)((128 - strlen(line1) * 12) / 2));
      display.setCursor(x1, 0);
      display.println(line1);
      
      int x2 = (int)max((int)0, (int)((128 - strlen(line2) * 12) / 2));
      display.setCursor(x2, 16);
      display.println(line2);
      
      int x3 = (int)max((int)0, (int)((128 - strlen(line3) * 12) / 2));
      display.setCursor(x3, 32);
      display.println(line3);
    } else {
      display.setCursor(0, 0);
      display.println(line1);
      display.setCursor(0, 16);
      display.println(line2);
      display.setCursor(0, 32);
      display.println(line3);
    }
    
    display.display();
  }
  
  // Static helper for notice screens with consistent styling
  static void drawNotice(const char* title, const char** lines, int lineCount,
                          const char* footer, bool customFooter) {
    display.clearDisplay();
    display.setTextSize(1);
    
    // Title bar (white on black)
    display.fillRect(0, 0, 128, 8, SSD1306_BLACK);
    display.setTextColor(SSD1306_WHITE, SSD1306_BLACK);
    display.setCursor(0, 0);
    String titleLine = String(title) + " ";
    while (titleLine.length() < 16) titleLine += " ";
    display.print(titleLine);
    
    // Solid white line below title
    display.drawLine(0, 8, 127, 8, SSD1306_WHITE);
    
    // Content area
    int y = 10;
    for (int i = 0; i < lineCount && y < 54; i++) {
      display.setTextColor(SSD1306_WHITE);
      display.setCursor(2, y);
      display.print(lines[i]);
      y += 11;
    }
    
    // Dotted separator above footer
    for (int x = 0; x < 128; x += 3) {
      display.drawPixel(x, 53, SSD1306_WHITE);
    }
    
    // Footer
    if (customFooter && strlen(footer) > 0) {
      display.setTextColor(SSD1306_WHITE);
      display.setCursor(0, 56);
      display.println(footer);
    }
    
    display.display();
  }

private:
  const char* title;
  MenuItem* items;
  int itemCount;
  Menu* parent;
  int cursor;
  int scrollOffset;  // Top visible item index (for scrolling menus)
  unsigned long timerStart;
  bool timerActive;
  bool userInteracted;  // True when user presses a button — disables auto-timer
  const char* footerText;  // Custom footer text (nullptr = default "1.Nav 1|Sel 2.Back")
  
  // Number of visible menu rows (4 on 64px OLED: title 10px + 4*11px = 54px, footer at 56px)
  static const int VISIBLE_ROWS = 4;

  void moveToFirstVisible() {
    for (int i = 0; i < itemCount; i++) {
      if (items[i].visible) {
        cursor = i;
        return;
      }
    }
    cursor = 0;
  }

  void moveToVisibleFrom(int start) {
    for (int i = 0; i < itemCount; i++) {
      int idx = (start + i) % itemCount;
      if (items[idx].visible) {
        cursor = idx;
        return;
      }
    }
    cursor = start;
  }
};

// Forward declaration
extern Menu* currentMenu;
extern bool skipBtnProcessing;
extern bool hamlibServerEnabled;
extern char setupWifiLabel[];
extern MenuItem networkItems[];
extern Menu setupMenu;
extern Menu pcInterfaceMenu;
extern Menu baudMenu;
extern Menu networkMenu;

// ==================== WIFI CREDENTIAL MANAGEMENT ====================
// See unified EEPROM layout below for address definitions

String savedSsid = "";
String savedPass = "";

void loadWifiCredentials() {
  uint8_t magic = EEPROM.read(EEPROM_MAGIC_BYTE);
  if (magic != EEPROM_MAGIC) {
    savedSsid = "";
    savedPass = "";
    return;
  }
  uint8_t ssidLen = EEPROM.read(EEPROM_SSID_LEN);
  if (ssidLen > 32) ssidLen = 32;
  char ssidBuf[33];
  for (uint8_t i = 0; i < ssidLen; i++) ssidBuf[i] = EEPROM.read(EEPROM_SSID_DATA + i);
  ssidBuf[ssidLen] = '\0';
  savedSsid = ssidBuf;
  
  uint8_t passLen = EEPROM.read(EEPROM_PASS_LEN);
  if (passLen > 32) passLen = 32;
  char passBuf[33];
  for (uint8_t i = 0; i < passLen; i++) passBuf[i] = EEPROM.read(EEPROM_PASS_DATA + i);
  passBuf[passLen] = '\0';
  savedPass = passBuf;
}

void saveWifiCredentials(const char* ssid, const char* pass) {
  // Zero out only the credential area (bytes 0-66), not the entire EEPROM
  // Bytes 67+ contain calibration data and must not be touched
  for (int i = 0; i <= 66; i++) EEPROM.write(i, 0);
  
  uint8_t ssidLen = (uint8_t)min(strlen(ssid), (size_t)32);
  EEPROM.write(EEPROM_SSID_LEN, ssidLen);
  for (uint8_t i = 0; i < ssidLen; i++) EEPROM.write(EEPROM_SSID_DATA + i, ssid[i]);
  
  uint8_t passLen = (uint8_t)min(strlen(pass), (size_t)32);
  EEPROM.write(EEPROM_PASS_LEN, passLen);
  for (uint8_t i = 0; i < passLen; i++) EEPROM.write(EEPROM_PASS_DATA + i, pass[i]);
  
  EEPROM.write(EEPROM_MAGIC_BYTE, EEPROM_MAGIC);
  EEPROM.commit();
  savedSsid = ssid;
  savedPass = pass;
  Serial.println("WiFi credentials saved to EEPROM");
}

bool hasWifiCredentials() {
  return savedSsid.length() > 0;
}

String maskPassword(const String& pass) {
  if (pass.length() == 0) return "";
  if (pass.length() == 1) return "*";
  String masked = String(pass[0]);
  for (size_t i = 1; i < pass.length() - 1; i++) {
    masked += "*";
  }
  if (pass.length() > 1) {
    masked += String(pass[pass.length() - 1]);
  }
  return masked;
}

// ==================== WIFI CONNECTION STATE ====================
enum WifiState {
  WIFI_IDLE,
  WIFI_CONNECTING,
  WIFI_CONNECTED,
  WIFI_FAILED,
  WIFI_AP_MODE
};
WifiState wifiState = WIFI_IDLE;
unsigned long wifiStart = 0;
const unsigned long WIFI_TIMEOUT = 15000;

void connectWifiSta() {
  deviceWifiMode = MODE_STA;
  wifiState = WIFI_CONNECTING;
  wifiStart = millis();
  
  WiFi.mode(WIFI_STA);
  WiFi.disconnect();
  delay(100);
  WiFi.begin(savedSsid.c_str(), savedPass.c_str());
  
  Serial.print("Connecting to ");
  Serial.println(savedSsid);
}

void startApMode() {
  // Stop captive portal if running (it uses open AP)
  stopCaptivePortal();
  
  deviceWifiMode = MODE_AP;
  wifiState = WIFI_AP_MODE;
  
  WiFi.disconnect();
  delay(100);
  WiFi.mode(WIFI_AP);
  delay(100);  // Allow WiFi mode to settle
  
  IPAddress apIP(192, 168, 4, 1);
  WiFi.softAPConfig(apIP, apIP, IPAddress(255, 255, 255, 0));
  
  bool ok = WiFi.softAP(apSsid, apPassword);
  if (!ok) {
    Serial.println("AP: softAP failed, retrying...");
    delay(200);
    ok = WiFi.softAP(apSsid, apPassword);
  }
  if (!ok) {
    Serial.println("AP: softAP STILL failed!");
  }
  
  // Start DNS server for captive portal effect (opens browser automatically)
  dnsServer.start(53, "*", apIP);
  
  setupWebServer();
  startRotctlServer();  // Always listen on port 4533 — protocol depends on Hamlib Server setting
  
  Serial.println("AP Mode: " + String(apSsid));
  Serial.println("IP: " + String(AP_IP));
}

void stopApMode() {
  dnsServer.stop();
  WiFi.mode(WIFI_OFF);
  wifiState = WIFI_IDLE;
}

void tickWifi() {
  if (wifiState == WIFI_CONNECTING) {
    if (WiFi.status() == WL_CONNECTED) {
      wifiState = WIFI_CONNECTED;
      Serial.println("WiFi Connected!");
      Serial.print("IP: ");
      Serial.println(WiFi.localIP().toString());
      Serial.print("RSSI: ");
      Serial.print(WiFi.RSSI());
      Serial.println(" dBm");
      setupWebServer();
      startRotctlServer();  // Always listen on port 4533 — protocol depends on Hamlib Server setting
      initTimeNtp();        // Best-effort wall-clock sync (no-op without internet)
    } else if (millis() - wifiStart > WIFI_TIMEOUT) {
      wifiState = WIFI_FAILED;
      Serial.println("WiFi connection timed out");
    }
  }
}

// ==================== REUSABLE WIFI CONNECTION DISPLAY ====================
// Returns: 0=cancelled, 1=connected, 2=failed
int waitForWifiConnection(bool allowCancel) {
  Serial.println("Waiting for WiFi connection...");

  connectWifiSta();

  int dotCount = 0;
  while (wifiState == WIFI_CONNECTING) {
    tickWifi();
    ESP.wdtFeed();

    dotCount++;
    if (dotCount % 4 == 0) {
      String netLine = "Network: " + savedSsid;
      String waitLine = "Waiting: " + String(dotCount / 4) + "s";
      const char* lines[] = { netLine.c_str(), "", waitLine.c_str() };
      Menu::drawNotice("WiFi Connecting", lines, 3, "2:Cancel", true);
    }

    if (allowCancel && !digitalRead(BTN2)) {
      delay(300);
      WiFi.disconnect();
      wifiState = WIFI_IDLE;
      return 0;  // Cancelled
    }

    delay(250);
  }

  if (wifiState == WIFI_CONNECTED) {
    // Show connected screen with IP, signal strength, and countdown
    int rssi = WiFi.RSSI();
    String quality;
    if (rssi >= -50) quality = "Excellent";
    else if (rssi >= -60) quality = "Good";
    else if (rssi >= -70) quality = "Fair";
    else quality = "Poor";

    String ipStr = WiFi.localIP().toString();

    display.clearDisplay();
    display.setTextSize(2);
    display.setTextColor(SSD1306_WHITE);
    display.setCursor(0, 0);
    display.println("Connected!");
    display.setTextSize(1);
    display.setCursor(0, 24);
    display.print("IP: "); display.println(ipStr);
    display.setCursor(0, 36);
    display.print("Signal: "); display.print(rssi); display.println(" dBm");
    display.setCursor(0, 48);
    display.print("Quality: "); display.println(quality);

    // Countdown from 5 seconds — just a timer in bottom-right corner
    for (int sec = 5; sec > 0; sec--) {
      ESP.wdtFeed();
      display.fillRect(118, 56, 10, 8, SSD1306_BLACK);
      display.setCursor(120, 56);
      display.print(sec);
      display.display();

      // Check for button press to skip ahead
      for (int i = 0; i < 20; i++) {
        if (digitalRead(BTN1) || !digitalRead(BTN2)) {
          delay(300);
          return 1;  // Connected
        }
        delay(50);
      }
    }

    return 1;  // Connected
  }

  return 2;  // Failed
}


// ==================== CAPTIVE PORTAL ====================
bool captivePortalActive = false;

void startCaptivePortal() {
  captivePortalActive = true;
  deviceWifiMode = MODE_AP;
  
  WiFi.mode(WIFI_AP);
  WiFi.softAP(apSsid);  // Open for captive portal setup
  IPAddress apIP(192, 168, 4, 1);
  WiFi.softAPConfig(apIP, apIP, IPAddress(255, 255, 255, 0));
  
  dnsServer.start(53, "*", apIP);
  
  // Idempotent: registers all routes + begins the HTTP server exactly once
  // (covers first-boot AP flows where STA never connected yet). The portal
  // itself needs NO route changes - onNotFound dispatches on
  // captivePortalActive, and /save is always registered.
  setupWebServer();
  
  Serial.println("Captive portal started on " + String(apSsid));
}

void stopCaptivePortal() {
  captivePortalActive = false;
  dnsServer.stop();
  // No server.stop()/re-registration: the HTTP server keeps listening across
  // mode switches (keepAlive(false) means no clients linger), and re-running
  // setupWebServer() would leak duplicate handler nodes (it can't un-register).
}

// ==================== ROTCTL TCP SERVER ====================
// Hamlib rotctld-compatible TCP server on port 4533
// Accepts one client at a time; when disconnected, reverts to serial-only

void startRotctlServer() {
  if (rotctlServerStarted) return;  // Already running
  rotctlServerStarted = true;
  rotctlServer.begin();
  rotctlServer.setNoDelay(true);
  Serial.println("ROTCTL: TCP server started on port " + String(ROTCTL_PORT));
}

void stopRotctlServer() {
  rotctlServerStarted = false;
  if (rotctlConnected) {
    rotctlClient.stop();
    rotctlConnected = false;
  }
  rotctlServer.close();
  Serial.println("ROTCTL: TCP server stopped");
}

// Throttled console print for rotctl connect/disconnect events. A pathological
// accept/disconnect churn (zombie TCP connections) must never drown the USB
// serial wire - in Oct 2026 an unthrottled loop produced ~11k msgs/s and
// eroded heap until only the static-string prints survived.
static unsigned long lastRotctlConsoleMs = 0;
void rotctlConsole(const char* m) {
  unsigned long now = millis();
  if (now - lastRotctlConsoleMs < 1000) return;
  lastRotctlConsoleMs = now;
  Serial.println(m);
  dbgLogCapture("TX", "CON", m);
}

void checkRotctlClient() {
  // Accept new connection
  if (!rotctlConnected && rotctlServer.hasClient()) {
    if (rotctlClient) rotctlClient.stop();  // Close any lingering client
    WiFiClient nc = rotctlServer.available();
    if (!nc.connected()) {
      // Zombie/half-dead connection (e.g. peer vanished without a clean
      // close). Discard it instead of committing: re-accepting dead clients
      // in a tight loop is what caused the disconnect-spam incident.
      nc.stop();
      return;
    }
    rotctlClient = nc;
    rotctlConnected = true;
    tcpProtocolBufIdx = 0;  // Reset TCP buffer
    {
      String m = "ROTCTL: Client connected from " + nc.remoteIP().toString();
      rotctlConsole(m.c_str());
    }
    return;
  }

  // Check for disconnection
  if (rotctlConnected && !rotctlClient.connected()) {
    rotctlClient.stop();
    rotctlConnected = false;
    tcpProtocolBufIdx = 0;
    rotctlConsole("ROTCTL: Client disconnected");
    return;
  }
  
  // Read data from TCP client and route through Default Protocol handler
  if (rotctlConnected && rotctlClient.available()) {
    while (rotctlClient.available()) {
      char ch = rotctlClient.read();
      
      if (ch == '\n' || ch == '\r') {
        if (tcpProtocolBufIdx > 0) {
          tcpProtocolBuf[tcpProtocolBufIdx] = '\0';
          DBG_PRINTLN(tcpProtocolBuf);
          {
            // Debug log: exact line as received on TCP, terminator included
            char rawLine[PROTOCOL_BUF_SIZE + 1];
            memcpy(rawLine, tcpProtocolBuf, tcpProtocolBufIdx);
            rawLine[tcpProtocolBufIdx] = ch;
            rawLine[tcpProtocolBufIdx + 1] = '\0';
            dbgLogCapture("RX", "TCP", rawLine);
          }
          // This command arrived over TCP — replies must go back over TCP
          protocolRxSource = RX_SRC_TCP;
          // Track last command for the OLED RX/TX overlay
          strncpy(protocolLastCommand, tcpProtocolBuf, PROTOCOL_BUF_SIZE - 1);
          protocolLastCommand[PROTOCOL_BUF_SIZE - 1] = '\0';
          processDefaultProtocolCommand(tcpProtocolBuf, tcpProtocolBufIdx);
          tcpProtocolBufIdx = 0;
        }
      } else {
        if (tcpProtocolBufIdx < PROTOCOL_BUF_SIZE - 1) {
          tcpProtocolBuf[tcpProtocolBufIdx++] = ch;
        } else {
          // Buffer overflow — discard oversized command and recover so the
          // parser state can't wedge on a malformed stream.
          {
            char ov[PROTOCOL_BUF_SIZE + 16];
            snprintf(ov, sizeof(ov), "[OVERFLOW] %.*s", PROTOCOL_BUF_SIZE - 1, tcpProtocolBuf);
            dbgLogCapture("RX", "TCP", ov);
          }
          tcpProtocolBufIdx = 0;
          tcpProtocolBuf[0] = '\0';
          showOledWarning("ERR: OVERFLOW");
        }
      }
    }
  }
}

// Send a protocol reply back over the SAME interface the command arrived on.
// A command received on USB serial is answered on the serial wire; a command
// received over TCP is answered over TCP. Replies never cross interfaces —
// this keeps each stream clean for its own client (the old unconditional
// serial echo broke GS-232A/B clients; see commit d4614b5).
void protocolSend(const String& response) {
  const char* lineEnding = getProtocolLineEnding();
  String fullResponse = response + lineEnding;

  // Route the reply to the interface that delivered the command
  bool delivered = false;
  if (protocolRxSource == RX_SRC_SER) {
    Serial.print(fullResponse);
    delivered = true;
  } else if (rotctlConnected && rotctlClient.connected()) {
    rotctlClient.print(fullResponse);
    delivered = true;
  }

  // Debug log: record where the response went. "DROP" = generated but no
  // delivery target on the command's own interface.
  dbgLogCapture("TX", delivered ? (protocolRxSource == RX_SRC_SER ? "SER" : "TCP") : "DROP", fullResponse.c_str());

  strncpy(protocolLastResponse, response.c_str(), PROTOCOL_BUF_SIZE - 1);
  protocolLastResponse[PROTOCOL_BUF_SIZE - 1] = '\0';
}

// Feed a single character into the protocol parser (used by both Serial and TCP)
void processProtocolChar(char ch) {
  protocolLastRxTime = millis();
  if (ch == '\n' || ch == '\r') {
    if (protocolBufIdx > 0) {
      protocolBuf[protocolBufIdx] = '\0';
      strncpy(protocolLastCommand, protocolBuf, PROTOCOL_BUF_SIZE - 1);
      protocolLastCommand[PROTOCOL_BUF_SIZE - 1] = '\0';
      DBG_PRINT("PROTOCOL:RX:"); DBG_PRINTLN(protocolBuf);
      {
        // Debug log: exact line as received on USB serial, terminator included
        char rawLine[PROTOCOL_BUF_SIZE + 1];
        memcpy(rawLine, protocolBuf, protocolBufIdx);
        rawLine[protocolBufIdx] = ch;
        rawLine[protocolBufIdx + 1] = '\0';
        dbgLogCapture("RX", "SER", rawLine);
        }

        // This command arrived over USB serial — replies must go back over serial
        protocolRxSource = RX_SRC_SER;

        // Special command: MODE:ROTATOR (exact match — a prefix match would
      // trigger on any longer line merely starting with "MODE:ROTATOR")
      if (protocolBufIdx == 12 && strncmp(protocolBuf, "MODE:ROTATOR", 12) == 0) {
        stopAll();
        exitCalibrationMode();
        currentMenu = nullptr;
        protocolSend("MODE:ROTATOR");
        protocolBufIdx = 0;
        protocolLastCmd = millis();
        return;
      }
      
      // Route based on selected protocol variant
      switch (currentProtocol) {
        case PROTO_GS232A:
        case PROTO_GS232B:
          processGs232Command(protocolBuf, protocolBufIdx);
          break;
        case PROTO_EASYCOM:
          processEasycomCommand(protocolBuf, protocolBufIdx);
          break;
      }
      
      protocolBufIdx = 0;
      protocolLastCmd = millis();
    }
  } else {
    if (protocolBufIdx < PROTOCOL_BUF_SIZE - 1) {
      protocolBuf[protocolBufIdx++] = ch;
    } else {
      // Buffer overflow — discard the oversized command and recover.
      // Without this, every subsequent char is dropped silently until the
      // next newline, wedging the protocol state machine.
      {
        char ov[PROTOCOL_BUF_SIZE + 16];
        snprintf(ov, sizeof(ov), "[OVERFLOW] %.*s", PROTOCOL_BUF_SIZE - 1, protocolBuf);
        dbgLogCapture("RX", "SER", ov);
      }
      protocolBufIdx = 0;
      protocolBuf[0] = '\0';
      showOledWarning("ERR: OVERFLOW");
    }
  }
}

// Detect a stalled partial command in the protocol buffer (chars received
// but no terminator within PROTOCOL_PARTIAL_TIMEOUT_MS). Flush it so the
// parser state can't wedge on an unterminated or malformed command stream.
// Called from loop() — never blocks.
void checkProtocolStall() {
  if (protocolBufIdx == 0) return;
  if (millis() - protocolLastRxTime < PROTOCOL_PARTIAL_TIMEOUT_MS) return;
  DBG_PRINTLN("PROTOCOL:STALL: flushing partial command");
  {
    char st[PROTOCOL_BUF_SIZE + 32];
    snprintf(st, sizeof(st), "[STALL: no terminator within 500ms] %.*s", PROTOCOL_BUF_SIZE - 1, protocolBuf);
    dbgLogCapture("RX", "SER", st);
  }
  protocolBufIdx = 0;
  protocolBuf[0] = '\0';
  showOledWarning("ERR: NO EOL");
}

// ==================== PROGMEM HTML PAGES ====================
// All HTML lives in flash, zero RAM overhead at runtime

const char html_portal[] PROGMEM = R"RAWHTML(
<!DOCTYPE html><html><head>
<meta name='viewport' content='width=device-width,initial-scale=1'>
<style>
body{font-family:Arial,sans-serif;background:#1a1a2e;color:#eee;text-align:center;padding:40px 20px}
h1{color:#00d4ff}
form{background:#16213e;padding:20px;border-radius:8px;max-width:300px;margin:20px auto}
label{display:block;text-align:left;margin:10px 0 5px;color:#00d4ff}
input{width:100%;padding:10px;border:none;border-radius:4px;background:#0f3460;color:#fff;font-size:16px;box-sizing:border-box}
button{margin-top:20px;padding:12px 30px;background:#00d4ff;color:#1a1a2e;border:none;border-radius:4px;font-size:16px;font-weight:bold;cursor:pointer}
</style></head><body>
<h1>AZELCTRL Setup</h1>
<p>Enter your home WiFi credentials</p>
<form method='POST' action='/save'>
<label>WiFi Name (SSID)</label>
<input name='ssid' required placeholder='Your WiFi name'>
<label>Password</label>
<input name='pass' type='password' placeholder='Your WiFi password'>
<button type='submit'>Save & Connect</button>
</form></body></html>
)RAWHTML";

const char html_portal_saved[] PROGMEM = R"RAWHTML(
<!DOCTYPE html><html><head>
<meta name='viewport' content='width=device-width,initial-scale=1'>
<style>
body{font-family:Arial,sans-serif;background:#1a1a2e;color:#eee;text-align:center;padding:60px 20px}
h1{color:#00d4ff}
p{font-size:18px}
</style></head><body>
<h1>Saved!</h1>
<p>WiFi credentials saved to device.</p>
<p>You can now disconnect and use the Connect option on the device.</p>
</body></html>
)RAWHTML";

// Protocol debug log viewer — served at /debug-usb (opens in its own tab).
// Polls /debug-log while open; firmware capture stops ~5 s after close.
const char html_debug_usb[] PROGMEM = R"RAWHTML(
<!DOCTYPE html><html><head>
<meta name='viewport' content='width=device-width,initial-scale=1'>
<title>AZELCtrl Debug USB</title>
<style>
body{font-family:Consolas,Menlo,monospace;background:#1a1a2e;color:#eee;margin:0;padding:14px}
h1{color:#00d4ff;font-size:15px;margin:0 0 3px}
.sub{color:#888;font-size:11px;margin-bottom:8px;line-height:1.4}
.bar{margin-bottom:8px}
button{padding:6px 14px;background:#00d4ff;color:#1a1a2e;border:none;border-radius:4px;font-weight:bold;cursor:pointer;font-size:12px}
#status{font-size:11px;color:#aaa;margin-left:10px}
pre{background:#0f0f1e;border:1px solid #333;border-radius:6px;padding:10px;height:calc(100vh - 140px);overflow-y:auto;white-space:pre-wrap;word-break:break-all;font-size:12px;line-height:1.5;margin:0}
.rx{color:#7ec8ff}.tx{color:#7dff9e}.ev{color:#ffb347}
</style></head><body>
<h1>AZELCtrl - Protocol Debug Log</h1>
<div class='sub'>USB serial + TCP protocol traffic, exactly as seen by the device.<br>
Logging is active while this tab is open and stops when you close it. Nothing is written to the device's flash.</div>
<div class='bar'><button id='dl'>Download log</button><button id='sync'>Sync time</button><span id='status'>connecting...</span></div>
<pre id='log'></pre>
<script>
// NB: must not be named 'status' - top-level `var status` cannot shadow the
// legacy-unforgeable window.status property, so the element ref was silently
// discarded and the page stuck on "connecting..." forever.
var seq=-1,pre=document.getElementById('log'),statusEl=document.getElementById('status'),syncBtnEl=document.getElementById('sync');
function cls(l){return l.indexOf('] RX')>-1?'rx':(l.indexOf('] TX')>-1?'tx':'ev');}
function poll(){
  fetch('/debug-log?since='+seq).then(function(r){return r.json();}).then(function(j){
    // j.seq is the session TOTAL (next slot index), not the last delivered
    // entry's seq: the handler's scan covers slots start..j.seq-1. Track the
    // highest slot actually scanned so the next poll picks up exactly where
    // this one left off - no skips, no duplicates.
    seq = j.seq > 0 ? j.seq - 1 : -1;
    var atBottom=pre.scrollTop+pre.clientHeight>=pre.scrollHeight-30;
    for(var i=0;i<j.lines.length;i++){
      var d=document.createElement('span');d.className=cls(j.lines[i]);d.textContent=j.lines[i]+'\n';pre.appendChild(d);
    }
    while(pre.childNodes.length>2000)pre.removeChild(pre.firstChild);
    if(atBottom)pre.scrollTop=pre.scrollHeight;
    statusEl.textContent='armed - '+j.seq+' entries captured'+(j.time?' - '+j.time:' (no time - click Sync)');
    statusEl.style.color='#7dff9e';
  }).catch(function(){
    statusEl.textContent='connection lost - retrying';statusEl.style.color='#ff6b6b';
  });
}
document.getElementById('dl').onclick=function(){window.location='/debug-log-download';};
// One-click wall-clock sync: sends this browser's epoch time + UTC offset so
// the device can stamp log lines with real local time (works in AP mode too).
syncBtnEl.onclick=function(){
  syncBtnEl.textContent='syncing...';
  fetch('/set-time?ts='+Date.now()+'&off='+(-new Date().getTimezoneOffset()*60))
    .then(function(r){return r.json();})
    .then(function(j){syncBtnEl.textContent=j.ok?'time synced':'sync failed';})
    .catch(function(){syncBtnEl.textContent='sync failed';});
};
poll();setInterval(poll,600);
</script></body></html>
)RAWHTML";

// Satellite tracker HTML — served from SPIFFS (index.html.gz) with PROGMEM fallback

// Helper: send PROGMEM content via web server
void sendProgmemHTML(const char* pgmHtml) {
  server.setContentLength(strlen_P(pgmHtml));
  server.send(200, "text/html; charset=utf-8");
  server.sendContent(pgmHtml);
}

// Serve gzip-compressed HTML from SPIFFS, fallback to PROGMEM
void sendHtml() {
  server.sendHeader("Access-Control-Allow-Origin", "*");
  server.keepAlive(false);
  if (SPIFFS.begin() && SPIFFS.exists(spiffsHtmlFile)) {
    File f = SPIFFS.open(spiffsHtmlFile, "r");
    if (f.size() > 0) {
      server.setContentLength(f.size());
      server.sendHeader("Content-Encoding", "gzip");
      server.send(200, "text/html");
      const size_t chunkSize = 1024;
      uint8_t buf[chunkSize];
      while (f.available()) {
        size_t toRead = f.available() < chunkSize ? f.available() : chunkSize;
        f.read(buf, toRead);
        server.sendContent((const char*)buf, toRead);
        yield();
        ESP.wdtFeed();
      }
      f.close();
      return;
    }
    f.close();
  }
  // Fallback: serve from PROGMEM
  server.setContentLength(sizeof(index_html_gz));
  server.sendHeader("Content-Encoding", "gzip");
  server.send(200, "text/html");
  // Send in chunks, reading from PROGMEM properly with memcpy_P
  // Abort early if client disconnects
  const size_t progmemChunk = 256;
  uint8_t sendBuf[progmemChunk];
  size_t sent = 0;
  while (sent < sizeof(index_html_gz)) {
    if (!server.client().connected()) break;
    size_t toSend = min(progmemChunk, sizeof(index_html_gz) - sent);
    memcpy_P(sendBuf, index_html_gz + sent, toSend);
    server.sendContent((const char*)sendBuf, toSend);
    sent += toSend;
    yield();
    ESP.wdtFeed();
  }
}

// Serve world coastline data from SPIFFS (gzip-compressed, returns 404 if not found)
void sendCoastlineData() {
  server.sendHeader("Access-Control-Allow-Origin", "*");
  server.keepAlive(false);
  if (SPIFFS.exists(spiffsCoastlineFile)) {
    File f = SPIFFS.open(spiffsCoastlineFile, "r");
    if (f.size() > 0) {
      server.setContentLength(f.size());
      server.sendHeader("Content-Encoding", "gzip");
      server.send(200, "application/javascript");
      const size_t chunkSize = 1024;
      uint8_t buf[chunkSize];
      while (f.available()) {
        size_t toRead = f.available() < chunkSize ? f.available() : chunkSize;
        f.read(buf, toRead);
        server.sendContent((const char*)buf, toRead);
        yield();
        ESP.wdtFeed();
      }
      f.close();
      return;
    }
    f.close();
  }
  server.send(404, "text/plain", "world_coastline.js.gz not found. Upload via Manage tab.");
}

// Upload a file to SPIFFS
void handleUpload() {
  HTTPUpload& upload = server.upload();
  static File spiffsFile;
  static String uploadPath;
  static bool uploadWriteError = false;
  static size_t uploadBytesWritten = 0;

  if (upload.status == UPLOAD_FILE_START) {
    // Sanitize filename — strip path, allow alphanumeric + ._-
    String filename = upload.filename;
    int lastSlash = filename.lastIndexOf('/');
    if (lastSlash >= 0) filename = filename.substring(lastSlash + 1);
    uploadPath = "/" + filename;

    // Remove old file if exists
    if (SPIFFS.exists(uploadPath)) {
      SPIFFS.remove(uploadPath);
    }
    spiffsFile = SPIFFS.open(uploadPath, "w");
    uploadWriteError = !spiffsFile;
    uploadBytesWritten = 0;
    Serial.print("Upload: start ");
    Serial.println(uploadPath);
  } else if (upload.status == UPLOAD_FILE_WRITE) {
    if (spiffsFile) {
      // Verify the write — SPIFFS can fail mid-file under RAM pressure;
      // without this a truncated file would be served silently.
      size_t n = spiffsFile.write(upload.buf, upload.currentSize);
      if (n != upload.currentSize) {
        uploadWriteError = true;
      } else {
        uploadBytesWritten += n;
      }
    } else {
      uploadWriteError = true;
    }
  } else if (upload.status == UPLOAD_FILE_END) {
    if (spiffsFile) {
      spiffsFile.close();
    }
    if (uploadWriteError || (size_t)upload.totalSize != uploadBytesWritten) {
      // Incomplete write — remove the partial file so the portal falls back
      // to the built-in copy instead of serving a corrupted page.
      if (SPIFFS.exists(uploadPath)) {
        SPIFFS.remove(uploadPath);
      }
      Serial.println("Upload: FAILED (write error or size mismatch) — partial file removed, retry the upload");
      server.send(500, "text/plain", "Upload failed: incomplete write. Please retry.");
    } else {
      Serial.print("Upload: done ");
      Serial.print(uploadPath);
      Serial.print(" (");
      Serial.print(upload.totalSize);
      Serial.println(" bytes)");
      server.send(200, "text/plain", "Upload complete");
    }
  } else if (upload.status == UPLOAD_FILE_ABORTED) {
    if (spiffsFile) {
      spiffsFile.close();
    }
    if (SPIFFS.exists(uploadPath)) {
      SPIFFS.remove(uploadPath);
    }
    server.send(500, "text/plain", "Upload failed");
  }
}

// Get Content-Type based on file extension
const char* getContentType(const String& path) {
  if (path.endsWith(".html")) return "text/html";
  if (path.endsWith(".css"))  return "text/css";
  if (path.endsWith(".js"))   return "application/javascript";
  if (path.endsWith(".json")) return "application/json";
  if (path.endsWith(".svg"))  return "image/svg+xml";
  if (path.endsWith(".png"))  return "image/png";
  if (path.endsWith(".jpg") || path.endsWith(".jpeg")) return "image/jpeg";
  if (path.endsWith(".gif"))  return "image/gif";
  if (path.endsWith(".ico"))  return "image/x-icon";
  if (path.endsWith(".webp")) return "image/webp";
  if (path.endsWith(".gz"))   return "application/gzip";
  return "application/octet-stream";
}

// List all files in SPIFFS as JSON
void listSpiffsFiles() {
  Dir dir = SPIFFS.openDir("/");
  String json = "[";
  bool first = true;
  while (dir.next()) {
    if (!first) json += ",";
    first = false;
    json += "{";
    json += "\"name\":\"" + dir.fileName() + "\",";
    json += "\"size\":" + String(dir.fileSize());
    json += "}";
  }
  json += "]";
  // Include filesystem capacity so clients can diagnose partial uploads
  FSInfo fsInfo;
  if (SPIFFS.info(fsInfo)) {
    String out = "{\"files\":" + json + ",";
    out += "\"total\":" + String(fsInfo.totalBytes) + ",";
    out += "\"free\":" + String((uint32_t)(fsInfo.totalBytes - fsInfo.usedBytes)) + "}";
    server.send(200, "application/json", out);
  } else {
    server.send(200, "application/json", json);
  }
}

// Delete a file from SPIFFS
void deleteSpiffsFile() {
  String path = server.arg("path");
  if (path.isEmpty() || !SPIFFS.exists(path)) {
    server.send(404, "text/plain", "File not found");
    return;
  }
  if (SPIFFS.remove(path)) {
    server.send(200, "text/plain", "Deleted: " + path);
  } else {
    server.send(500, "text/plain", "Delete failed");
  }
}

// Serve files from SPIFFS via /files/ path
void serveSpiffsFile(const String& path) {
  server.sendHeader("Access-Control-Allow-Origin", "*");
  server.keepAlive(false);
  // Remove leading /files/ prefix
  String spiffsPath = path;
  if (spiffsPath.startsWith("/files/")) {
    spiffsPath = spiffsPath.substring(7);  // Remove "/files/"
  }
  if (!spiffsPath.startsWith("/")) {
    spiffsPath = "/" + spiffsPath;
  }

  if (!SPIFFS.exists(spiffsPath)) {
    server.send(404, "text/plain", "File not found");
    return;
  }

  File f = SPIFFS.open(spiffsPath, "r");
  if (!f || f.size() == 0) {
    server.send(404, "text/plain", "File not found");
    f.close();
    return;
  }

  const char* contentType = getContentType(spiffsPath);
  bool isGzipped = spiffsPath.endsWith(".gz");

  server.setContentLength(f.size());
  if (isGzipped) {
    server.sendHeader("Content-Encoding", "gzip");
  }
  // Use send() with empty body - setContentLength() must be called BEFORE send()
  server.send(200, contentType, "");
  // Now stream the file content
  const size_t chunkSize = 512;
  uint8_t buf[chunkSize];
  size_t remaining = f.size();
  while (remaining > 0) {
    size_t toRead = remaining < chunkSize ? remaining : chunkSize;
    size_t bytesRead = f.read(buf, toRead);
    if (bytesRead > 0) {
      server.sendContent(reinterpret_cast<char*>(buf), bytesRead);
      remaining -= bytesRead;
    } else {
      break;
    }
  }
  f.close();
}

void handlePortal() {
  sendProgmemHTML(html_portal);
}

void handleSaveWifi() {
  String ssid = server.arg("ssid");
  String pass = server.arg("pass");
  
  if (ssid.length() > 0) {
    Serial.print("Saving WiFi: SSID=");
    Serial.println(ssid);
    saveWifiCredentials(ssid.c_str(), pass.c_str());
    
    sendProgmemHTML(html_portal_saved);
    
    delay(2000);  // Let the response reach the phone
    Serial.println("Stopping captive portal after WiFi save...");
    stopCaptivePortal();
    // Does NOT reboot - returns control to Station Settings screen
  } else {
    // Empty submission (e.g., captive portal detection) - redirect to portal
    Serial.println("handleSaveWifi: empty SSID, returning portal");
    sendProgmemHTML(html_portal);
  }
}

void tickCaptivePortal() {
  if (captivePortalActive) {
    dnsServer.processNextRequest();
    server.handleClient();
  }
}

// ==================== SAFETY: DIRECTION REVERSE PAUSE ====================
const unsigned long REVERSE_PAUSE_MS = 600;

enum AxisDirection {
  DIR_STOPPED,
  DIR_CW,
  DIR_CCW,
  DIR_UP,
  DIR_DOWN
};

AxisDirection azDirection = DIR_STOPPED;
AxisDirection elDirection = DIR_STOPPED;
// Track mechanical offset from center for direction calculation
// Positive = CW from center, Negative = CCW from center
// N360/S360: range -180° to +180°
// N450/S450: range -225° to +225°
float mechanicalAzOffset = 0.0;  // Current mechanical offset from center
float mechanicalElOffset = 0.0;  // Current mechanical offset from center
float lastAzReading = 0.0;       // Previous azimuth reading for delta calculation

bool isPausing = false;
unsigned long pauseStartTime = 0;
String pendingDir = "";
bool pauseAz = false;
bool pauseEl = false;

void checkPauseComplete() {
  if (!isPausing) return;
  
  unsigned long elapsed = millis() - pauseStartTime;
  if (elapsed >= REVERSE_PAUSE_MS) {
    if (pauseAz) pauseAz = false;
    if (pauseEl) pauseEl = false;
    
    if (!pauseAz && !pauseEl) {
      isPausing = false;
      executeMove(pendingDir);
      pendingDir = "";
    } else {
      if (!pauseAz) executeAzimuthMove(pendingDir);
      else if (!pauseEl) executeElevationMove(pendingDir);
    }
  }
}

// ==================== CALIBRATION CONSTANTS ====================
const unsigned long CAL_SWEEP_TIMEOUT = 120000;  // 2 minutes per sweep
const unsigned long CAL_DETECT_TIME = 6000;      // 6 seconds to detect cable connection (3s each direction)
const float CAL_MAX_SAFE_V = 3.250F;             // Hard voltage safety limit
const float CAL_STABILITY_THRESHOLD = 15.0F;     // mV - voltage change over stability window
const float CAL_MIN_RANGE = 0.5F;                // Minimum valid range (maxV - minV)
const float CAL_DETECT_MIN_CHANGE = 70.0F;       // mV - minimum voltage change to confirm cable
const float CAL_ASSUMED_PRE_CAL_MAX = 3.200F;    // Assumed max voltage before calibration
const unsigned long CAL_HEADING_PAUSE = 5000;    // Pause 5s at each cardinal heading during return sweep
#define CAL_V_SAMPLES 20

// Rotator model - single enum for all 4 options
enum RotModel { ROT_N360, ROT_S360, ROT_N450, ROT_S450 };
RotModel rotModel = ROT_N360;

// Calibrated voltage ranges (loaded from EEPROM)
float calAzMinV = 0.0F, calAzMaxV = 3.2F;
float calElMinV = 0.0F, calElMaxV = 3.2F;
bool calAzValid = false, calElValid = false;

// ====================== MOVEMENT CONTROL ======================
void stopAzimuth() {
  digitalWrite(AZ_ENABLE, LOW);
  digitalWrite(AZ_DIR_CW, HIGH);
  azDirection = DIR_STOPPED;
  azEngageStart = 0;  // Clear engagement timer
  // Don't clear protocolTargetAzSet here — it's cleared by auto-stop or explicit stop commands
  protocolAzReversing = false;
  // Clear movement indicator if azimuth was moving
  if (currentMove == "LEFT" || currentMove == "RIGHT" || currentMove == "AZ POT") {
    currentMove = "IDLE";
  }
}

void stopElevation() {
  digitalWrite(EL_ENABLE, LOW);
  digitalWrite(EL_DIR_UP, HIGH);
  elDirection = DIR_STOPPED;
  elEngageStart = 0;  // Clear engagement timer
  protocolTargetElSet = false;  // Clear so tolerance check works on next target
  protocolElReversing = false;
  // Clear movement indicator if elevation was moving
  if (currentMove == "UP" || currentMove == "DOWN" || currentMove == "EL POT") {
    currentMove = "IDLE";
  }
}

void stopAll() {
  stopAzimuth();
  stopElevation();
  moving = false;
  currentMove = "IDLE";
  // Clear protocol targets so auto-stop logic doesn't restart movement
  protocolTargetAzSet = false;
  protocolTargetElSet = false;
  protocolAzReversing = false;
  protocolElReversing = false;
}

void executeAzimuthMove(String dir) {
  // Only stop if actually moving in a DIFFERENT direction — skip if idle or same direction
  bool needStop = (azDirection != DIR_STOPPED && azDirection != DIR_CCW && dir == "LEFT") ||
                  (azDirection != DIR_STOPPED && azDirection != DIR_CW  && dir == "RIGHT");
  if (needStop) {
    stopAzimuth();
  } else if (azDirection == DIR_STOPPED) {
    // Already stopped — just ensure pins are clean (no-op, but explicit)
    digitalWrite(AZ_ENABLE, LOW);
    digitalWrite(AZ_DIR_CW, HIGH);
  }
  
  // Check voltage safety before moving
  if (adsPresent && calAzValid) {
    float azVoltage = (float)ads.readADC_SingleEnded(0) / 32767.0 * 4.096F;
    if (dir == "RIGHT" && azVoltage >= CAL_MAX_SAFE_V) {
      // Safety limit — cannot move RIGHT (AZ)
      return;
    }
  }
  
  if (currentMove == "IDLE" || currentMove == "UP" || currentMove == "DOWN") {
    currentMove = dir;
  }
  moving = true;
  
  // Mark engagement start — use current Az as the last known good position
  azPositionAtEngage = displayAzimuth(currentAz);
  azEngageStart = millis();
  
  if (dir == "LEFT") {
    azDirection = DIR_CCW;
    digitalWrite(AZ_DIR_CW, HIGH);
    digitalWrite(AZ_ENABLE, HIGH);
  }
  if (dir == "RIGHT") {
    azDirection = DIR_CW;
    digitalWrite(AZ_DIR_CW, LOW);
    digitalWrite(AZ_ENABLE, HIGH);
  }
}

void executeElevationMove(String dir) {
  // Only stop if actually moving in a DIFFERENT direction — skip if idle or same direction
  bool needStop = (elDirection != DIR_STOPPED && elDirection != DIR_DOWN && dir == "UP") ||
                  (elDirection != DIR_STOPPED && elDirection != DIR_UP  && dir == "DOWN");
  if (needStop) {
    stopElevation();
  } else if (elDirection == DIR_STOPPED) {
    // Already stopped — just ensure pins are clean (no-op, but explicit)
    digitalWrite(EL_ENABLE, LOW);
    digitalWrite(EL_DIR_UP, HIGH);
  }
  
  // Check voltage safety before moving
  if (adsPresent && calElValid) {
    float elVoltage = (float)ads.readADC_SingleEnded(1) / 32767.0 * 4.096F;
    if (dir == "UP" && elVoltage >= CAL_MAX_SAFE_V) {
      // Safety limit — cannot move UP (EL)
      return;
    }
  }
  
  if (currentMove == "IDLE" || currentMove == "LEFT" || currentMove == "RIGHT") {
    currentMove = dir;
  }
  moving = true;
  
  // Mark engagement start — use current El as the last known good position
  elPositionAtEngage = currentEl;
  elEngageStart = millis();
  
  if (dir == "UP") {
    elDirection = DIR_UP;
    digitalWrite(EL_DIR_UP, LOW);
    digitalWrite(EL_ENABLE, HIGH);
  }
  if (dir == "DOWN") {
    elDirection = DIR_DOWN;
    digitalWrite(EL_DIR_UP, HIGH);
    digitalWrite(EL_ENABLE, HIGH);
  }
}

void executeMove(String dir) {
  if (dir == "LEFT" || dir == "RIGHT") {
    executeAzimuthMove(dir);
  } else if (dir == "UP" || dir == "DOWN") {
    executeElevationMove(dir);
  }
}

void startMove(String dir) {
  bool azNeedsPause = false;
  bool elNeedsPause = false;
  
  if (dir == "LEFT" || dir == "RIGHT") {
    if (azDirection != DIR_STOPPED) {
      azNeedsPause = (dir == "LEFT" && azDirection == DIR_CW) ||
                     (dir == "RIGHT" && azDirection == DIR_CCW);
    }
  }
  
  if (dir == "UP" || dir == "DOWN") {
    if (elDirection != DIR_STOPPED) {
      elNeedsPause = (dir == "UP" && elDirection == DIR_DOWN) ||
                     (dir == "DOWN" && elDirection == DIR_UP);
    }
  }
  
  if (!azNeedsPause && !elNeedsPause) {
    executeMove(dir);
    return;
  }
  
  if (azNeedsPause) {
    stopAzimuth();
    pauseAz = true;
  }
  if (elNeedsPause) {
    stopElevation();
    pauseEl = true;
  }
  
  if (!isPausing) {
    isPausing = true;
    pauseStartTime = millis();
    pendingDir = dir;
  }
}

// ====================== CALIBRATION (VOLTAGE-BASED) ======================
// Calibration finds min/max voltages by sweeping to hard limits.
// AZ: CCW→min (~0V at -180°), CW→max (~3.2V at +180°)
// EL: DOWN→min (~0V at 0°), UP→max (~3.2V at 90°)
// Safety: never exceed CAL_MAX_SAFE_V (3.250V)
// Results saved to EEPROM so calibration persists across reboots.

enum CalState {
  CAL_IDLE,
  CAL_SWEEP_MIN,        // Move CCW/DOWN until voltage stabilizes (also detects cable)
  CAL_SWEEP_MAX,        // Move CW/UP until voltage stabilizes or hits safety limit
  CAL_ADJUST_MAX,       // Prompt user to manually adjust to exact heading (180° AZ / 90° EL)
  CAL_RETURN_MIN,       // Return sweep CCW/DOWN to minimum, pausing at cardinal headings
  CAL_COMPLETE,         // Calibration complete, saved to EEPROM
  CAL_ERROR             // Error state with message
};

CalState calState = CAL_IDLE;
int calCurrentAxis = -1;  // 0=AZ, 1=EL, -1=none
int calDirection = 0;     // 1=CW/UP, -1=CCW/DOWN
unsigned long calPhaseStart = 0;

float calMinVoltage = 0;
float calMaxVoltage = 0;
float calStabilityMax = 0;
float calStabilityMin = 0;
unsigned long calStabilityStart = 0;
String calErrorMessage = "";

// Return sweep tracking (CAL_RETURN_MIN)
String calCurrentHeading = "";
unsigned long calHeadingPauseStart = 0;
int calLastHeadingIndex = -1;  // Track which cardinal heading we last paused at

// Voltage samples for stability detection
float calVoltageSamples[CAL_V_SAMPLES];
int calVSampleIdx = 0;
float calInitialVoltage = 0;  // Voltage at start of CAL_SWEEP_MIN (for cable detection)

// Estimate heading from voltage during calibration (before calAzValid/calElValid is set)
// Uses rotator model offset/span + assumed or actual voltage range
float calEstimatedHeading(float voltage, int axis) {
  if (axis == 0) {
    // AZ: use rotator model offset/span
    float minV = calMinVoltage;
    float maxV = calMaxVoltage;
    float range = maxV - minV;
    if (range < 0.01F) {
      // No calibration data yet — assume ~3.2V range from 0V
      range = CAL_ASSUMED_PRE_CAL_MAX;
      minV = 0;
      maxV = CAL_ASSUMED_PRE_CAL_MAX;
    }
    float fraction = (voltage - minV) / range;
    fraction = constrain(fraction, 0, 1);
    return azOffset() + (fraction * azSpan());
  } else {
    // EL: 0 to 180
    float minV = calMinVoltage;
    float maxV = calMaxVoltage;
    float range = maxV - minV;
    if (range < 0.01F) {
      range = CAL_ASSUMED_PRE_CAL_MAX;
      minV = 0;
      maxV = CAL_ASSUMED_PRE_CAL_MAX;
    }
    float fraction = (voltage - minV) / range;
    fraction = constrain(fraction, 0, 1);
    return fraction * 180.0F;
  }
}

// Cardinal headings for the return sweep (ordered max→min for CCW sweep)
// Uses raw mechanical headings from calEstimatedHeading() (no compass conversion needed)
// Full range covers all variants:
// Index 0: +270° = W (N450/S450 start only)
// Index 1: +225° = SW (N450/S450 only)
// Index 2: +180° = S (all variants start here or later)
// Index 3: +135° = SE
// Index 4: +90° = E
// Index 5: +45° = NE
// Index 6: 0° = N
// Index 7: -45° = NW
// Index 8: -90° = W
// Index 9: -135° = SW
// Index 10: -180° = S (end for all variants)
const char* calCardinalNames[] = {"W", "SW", "S", "SE", "E", "NE", "N", "NW", "W", "SW", "S"};
const float calCardinalAngles[] = {270, 225, 180, 135, 90, 45, 0, -45, -90, -135, -180};
const int calCardinalCount = 11;

// Get the next cardinal heading index we should pause at during return sweep
// Returns -1 when no more headings to pause at
int calNextCardinalHeading(float currentHeading) {
  // Calculate the last heading index for this variant
  // N360/S360: start at index 2 (S=+180), end at index 10 (S=-180)
  // N450/S450: start at index 0 (W=+270), end at index 10 (S=-180)
  int startIndex = (rotModel == ROT_N450 || rotModel == ROT_S450) ? 0 : 2;
  int lastIndex = 10;
  
  // Clamp calLastHeadingIndex to valid range
  if (calLastHeadingIndex < startIndex) calLastHeadingIndex = startIndex;
  
  // We're sweeping CCW from max toward min, so mechanical headings decrease
  for (int i = calLastHeadingIndex + 1; i <= lastIndex; i++) {
    float tolerance = (i == lastIndex) ? 0.0F : 1.0F;
    if (currentHeading <= calCardinalAngles[i] + tolerance) {
      Serial.print("CAL: Heading ");
      Serial.print(currentHeading, 1);
      Serial.print("° reached cardinal ");
      Serial.println(calCardinalNames[i]);
      return i;
    }
  }
  return -1;
}

// Calibrated voltage ranges (loaded from EEPROM) — declared with constants above
// float calAzMinV, calAzMaxV, calElMinV, calElMaxV, calAzValid, calElValid

void loadCalibration() {
  if (EEPROM.read(CAL_EEPROM_MAGIC) != CAL_EEPROM_MAGIC_VAL) {
    return;
  }
  uint8_t* bytes = (uint8_t*)&calAzMinV;
  for (int i = 0; i < 4; i++) bytes[i] = EEPROM.read(CAL_EEPROM_AZ_MIN + i);
  bytes = (uint8_t*)&calAzMaxV;
  for (int i = 0; i < 4; i++) bytes[i] = EEPROM.read(CAL_EEPROM_AZ_MAX + i);
  bytes = (uint8_t*)&calElMinV;
  for (int i = 0; i < 4; i++) bytes[i] = EEPROM.read(CAL_EEPROM_EL_MIN + i);
  bytes = (uint8_t*)&calElMaxV;
  for (int i = 0; i < 4; i++) bytes[i] = EEPROM.read(CAL_EEPROM_EL_MAX + i);
  
  calAzValid = (calAzMaxV - calAzMinV > CAL_MIN_RANGE);
  calElValid = (calElMaxV - calElMinV > CAL_MIN_RANGE);
}

void saveCalibration() {
  uint8_t* bytes;
  if (calCurrentAxis == 0) {
    bytes = (uint8_t*)&calAzMinV;
    for (int i = 0; i < 4; i++) EEPROM.write(CAL_EEPROM_AZ_MIN + i, bytes[i]);
    bytes = (uint8_t*)&calAzMaxV;
    for (int i = 0; i < 4; i++) EEPROM.write(CAL_EEPROM_AZ_MAX + i, bytes[i]);
    calAzValid = true;
  } else {
    bytes = (uint8_t*)&calElMinV;
    for (int i = 0; i < 4; i++) EEPROM.write(CAL_EEPROM_EL_MIN + i, bytes[i]);
    bytes = (uint8_t*)&calElMaxV;
    for (int i = 0; i < 4; i++) EEPROM.write(CAL_EEPROM_EL_MAX + i, bytes[i]);
    calElValid = true;
  }
  EEPROM.write(CAL_EEPROM_MAGIC, CAL_EEPROM_MAGIC_VAL);
  EEPROM.commit();
  Serial.println("CAL: Calibration saved to EEPROM");
}

void loadWifiMode() {
  if (EEPROM.read(WIFI_MODE_MAGIC) != WIFI_MODE_MAGIC_VAL) {
    Serial.println("WIFI: No WiFi mode in EEPROM - defaulting to DISABLED");
    deviceWifiMode = MODE_DISABLED;
    return;
  }
  deviceWifiMode = (DeviceWifiMode)EEPROM.read(WIFI_MODE_EEPROM);
  Serial.print("WIFI: Loaded mode = ");
  if (deviceWifiMode == MODE_STA) Serial.println("STA");
  else if (deviceWifiMode == MODE_AP) Serial.println("AP");
  else Serial.println("DISABLED");
}

void saveWifiMode() {
  EEPROM.write(WIFI_MODE_EEPROM, (uint8_t)deviceWifiMode);
  EEPROM.write(WIFI_MODE_MAGIC, WIFI_MODE_MAGIC_VAL);
  EEPROM.commit();
  Serial.println("WIFI: WiFi mode saved to EEPROM");
}

void loadApPassword() {
  uint8_t magic = EEPROM.read(AP_PASS_EEPROM_MAGIC);
  if (magic == AP_PASS_EEPROM_MAGIC_VAL) {
    for (int i = 0; i < 8; i++) {
      apPassword[i] = EEPROM.read(AP_PASS_EEPROM_START + i);
    }
    apPassword[8] = '\0';
    Serial.print("AP: Loaded password = ");
    Serial.println(apPassword);
  } else {
    // Default password
    strcpy(apPassword, "yaesu123");
    Serial.println("AP: Using default password");
  }
}

void saveApPassword() {
  for (int i = 0; i < 8; i++) {
    EEPROM.write(AP_PASS_EEPROM_START + i, apPassword[i]);
  }
  EEPROM.write(AP_PASS_EEPROM_MAGIC, AP_PASS_EEPROM_MAGIC_VAL);
  EEPROM.commit();
  Serial.print("AP: Password saved = ");
  Serial.println(apPassword);
}

bool hasRotatorModel() {
  return EEPROM.read(ROT_EEPROM_MAGIC) == ROT_EEPROM_MAGIC_VAL;
}

bool hasAnySettings() {
  return hasRotatorModel() && EEPROM.read(WIFI_MODE_MAGIC) == WIFI_MODE_MAGIC_VAL;
}

void loadRotatorModel() {
  if (EEPROM.read(ROT_EEPROM_MAGIC) != ROT_EEPROM_MAGIC_VAL) {
    Serial.println("ROT: No rotator model in EEPROM - will prompt at boot");
    return;
  }
  rotModel = (RotModel)EEPROM.read(ROT_EEPROM_MODEL);
  Serial.print("ROT: Loaded model = ");
  Serial.println(rotModel);
}

// ELF mode persistence
void loadElfMode() {
  elfMode = (EEPROM.read(ELF_EEPROM_BYTE) == 1);
  Serial.print("ELF: Mode = ");
  Serial.println(elfMode ? "ON" : "OFF");
}

void saveElfMode() {
  EEPROM.write(ELF_EEPROM_BYTE, elfMode ? 1 : 0);
  EEPROM.commit();
}

void saveRotatorModel(bool clearCal = false) {
  EEPROM.write(ROT_EEPROM_MODEL, (uint8_t)rotModel);
  EEPROM.write(ROT_EEPROM_MAGIC, ROT_EEPROM_MAGIC_VAL);
  EEPROM.commit();
  Serial.println("ROT: Rotator model saved to EEPROM");
  
  if (clearCal) {
    // Clear calibration when model changes — azimuth range may have changed
    clearCalibration();
  }
}

void clearCalibration() {
  // Invalidate calibration magic byte
  EEPROM.write(CAL_EEPROM_MAGIC, 0);
  EEPROM.commit();
  calAzValid = false;
  calElValid = false;
  calAzMinV = calAzMaxV = calElMinV = calElMaxV = 0;
  Serial.println("CAL: Calibration cleared — recalibrate required");
}

String azRangeLabel() {
  switch (rotModel) {
    case ROT_N360: return "-180 to +180";
    case ROT_S360: return "0 to 360";
    case ROT_N450: return "-180 to +270";
    case ROT_S450: return "0 to 450";
  }
  return "";
}

float azSpan() {
  if (rotModel == ROT_N450 || rotModel == ROT_S450) return 450.0F;
  return 360.0F;
}

float azOffset() {
  if (rotModel == ROT_S360 || rotModel == ROT_S450) return 0.0F;
  return -180.0F;
}

// Convert azimuth to display format (always positive, matching controller display)
// N360: -180→180, -90→270, 0→0, +90→90, +180→180
// S360: no change (already 0-360)
// N450: -180→180, -90→270, 0→0, +90→90, +180→180, +270→270
// S450: no change (already 0-450)
float displayAzimuth(float az) {
  if (az < 0) az += 360.0F;
  return az;
}

void setupRotatorModel() {
  Serial.println("ROT: Starting rotator model setup");

  const char* modelLabels[4] = {"N360 (-180 to 180)", "S360 (0 to 360)", "N450 (-225 to 225)", "S450 (-45 to 405)"};
  int choice = rotModel;  // Default to current
  bool firstDraw = true;
  bool btn1WasPressed = false;
  bool btn2WasPressed = false;

  while (true) {
    // Check for MODE:ROTATOR command to escape blocking menu
    if (checkModeCommand()) return;

    bool btn1 = digitalRead(BTN1);      // HIGH = pressed
    bool btn2 = !digitalRead(BTN2);     // LOW = pressed

    display.clearDisplay();
    display.setTextSize(1);

    display.fillRect(0, 0, 128, 8, SSD1306_BLACK);
    display.setTextColor(SSD1306_WHITE, SSD1306_BLACK);
    display.setCursor(0, 0);
    display.print("Rotator Variant?             ");

    display.drawLine(0, 8, 127, 8, SSD1306_WHITE);

    int y = 12;
    for (int i = 0; i < 4; i++) {
      if (i == choice) {
        display.fillRect(0, y, 128, 8, SSD1306_WHITE);
        display.setTextColor(SSD1306_BLACK, SSD1306_WHITE);
      } else {
        display.setTextColor(SSD1306_WHITE);
      }

      display.setCursor(2, y);
      display.print(modelLabels[i]);
      y += 11;
    }

    for (int x = 0; x < 128; x += 3) {
      display.drawPixel(x, 53, SSD1306_WHITE);
    }

    display.setTextColor(SSD1306_WHITE);
    display.setCursor(0, 56);
    display.println("1.Nav  1|Sel  2.Back");

    display.display();

    // Wait for buttons released on first draw to prevent carryover from long-press
    if (firstDraw) {
      firstDraw = false;
      while (digitalRead(BTN1) || !digitalRead(BTN2)) delay(50);
      delay(100);
      btn1WasPressed = false;
      btn2WasPressed = false;
      continue;
    }

    unsigned long now = millis();

    // Btn1: short-press = cycle, long-press = select
    if (btn1 && !btn1WasPressed) {
      resetOledCmdSuppress();
      unsigned long pressStart = now;
      while (digitalRead(BTN1) && (millis() - pressStart < 800)) {
        delay(20);
      }
      if (millis() - pressStart >= 800) {
        // Long press - select and save
        Serial.print("ROT: Selected model ");
        Serial.println(choice);
        rotModel = (RotModel)choice;
        saveRotatorModel(true);  // Clear calibration when model changes
        // Return immediately — do NOT wait for button release here.
        // The caller (actionSetupRotator) will wait for release on firstDraw.
        return;
      }
      // Short press - cycle choice
      choice = (choice + 1) % 4;
    }

    // Btn2: edge-detect press = back (short or long)
    if (btn2 && !btn2WasPressed) {
      resetOledCmdSuppress();
      // Debounce delay
      delay(BTN_DEBOUNCE_MS);
      Serial.println("ROT: Back from rotator setup");
      // Wait for button release before returning to prevent carryover
      while (!digitalRead(BTN2)) delay(50);
      delay(50);
      return;
    }

    btn1WasPressed = btn1;
    btn2WasPressed = btn2;

    delay(50);
  }
}

void enterCalibrationMode(int axis) {
  calState = CAL_SWEEP_MIN;
  calCurrentAxis = axis;
  calDirection = 0;
  calPhaseStart = millis();
  calMinVoltage = 0;
  calMaxVoltage = 0;
  calStabilityMax = 0;
  calStabilityMin = 32767;
  calStabilityStart = millis();
  calInitialVoltage = 0;
  calVSampleIdx = 0;
  calErrorMessage = "";
  calCurrentHeading = "";
  calHeadingPauseStart = 0;
  calLastHeadingIndex = -1;
  stopAll();
  currentMenu = nullptr;
  
  String axisName = (axis == 0) ? "AZ" : "EL";
  Serial.print("CAL: Entering ");
  Serial.print(axisName);
  Serial.println(" pot calibration mode");
}

void exitCalibrationMode() {
  calState = CAL_IDLE;
  calCurrentAxis = -1;
  calDirection = 0;
  stopAll();
  Serial.println("CAL: Exiting calibration");
}

// Protocol movement helpers — used by both GS-232 and Easycom handlers
void executeProtocolAzMove(float targetAz) {
  // Convert -180..+180 to 0..360 for internal logic
  // This lets all existing direction-finding, mechanical-stop, and ELF logic work unchanged
  if (targetAz < 0.0) targetAz += 360.0;
  if (targetAz > 360.0) targetAz -= 360.0;
  
  // When ELF is on, incoming targets are in satellite space — transform to physical
  float physTarget = elfAz(targetAz);
  
  // Direction calculation: compare in the same coordinate space
  float curForDiff;
  float tgtForDiff;
  if (elfMode) {
    curForDiff = elfAz(currentAz);
    tgtForDiff = targetAz;
  } else {
    curForDiff = displayAzimuth(currentAz);
    tgtForDiff = targetAz;
  }
  float diff = tgtForDiff - curForDiff;
  if (diff > 180.0) diff -= 360.0;
  if (diff < -180.0) diff += 360.0;
  
  // Don't start movement if target is within auto-stop tolerance and we're stopped
  // This prevents relay clicking when new targets arrive within the zone where
  // auto-stop would immediately kill movement anyway
  if (azDirection == DIR_STOPPED && !protocolTargetAzSet && abs(diff) <= PROTOCOL_STOP_TOLERANCE) {
#if DEBUG_ENABLED
    Serial.printf("DBG:PROT_AZ:TOLERANCE:diff=%.1f within %d tolerance, not starting\n", diff, (int)PROTOCOL_STOP_TOLERANCE);
#endif
    protocolTargetAz = physTarget;
    return;
  }
  
  protocolTargetAz = physTarget;
  protocolTargetAzSet = true;
#if DEBUG_ENABLED
  Serial.print("DBG:PROT_AZ:RECEIVED:target="); Serial.print(targetAz);
  Serial.print(" curRaw="); Serial.print(currentAz);
  Serial.print(" curDisp="); Serial.println(displayAzimuth(currentAz));
#endif
#if DEBUG_ENABLED
  Serial.printf("DBG:PROT_AZ:DIFF:rawDiff=%.1f normDiff=%.1f\n", diff, diff);
#endif
  float physicalStop;
  switch (rotModel) {
    case ROT_N360: physicalStop = 180.0; break;
    case ROT_S360: physicalStop = 0.0; break;
    case ROT_N450: physicalStop = 135.0; break;
    case ROT_S450: physicalStop = 315.0; break;
    default: physicalStop = 180.0; break;
  }
#if DEBUG_ENABLED
  Serial.printf("DBG:PROT_AZ:PHYSSTOP:physicalStop=%.1f rotModel=%d\n", physicalStop, rotModel);
#endif
  bool mustRotateCW = false;
  bool mustRotateCCW = false;
  if (elfMode) {
    float satStop = elfAz(physicalStop);
    if (curForDiff >= satStop && tgtForDiff < satStop) {
      mustRotateCW = true;
    } else if (curForDiff < satStop && tgtForDiff >= satStop) {
      mustRotateCCW = true;
    }
  } else {
    if (curForDiff >= physicalStop && tgtForDiff < physicalStop) {
      mustRotateCW = true;
    } else if (curForDiff < physicalStop && tgtForDiff >= physicalStop) {
      mustRotateCCW = true;
    }
  }
  if (rotModel == ROT_N450 || rotModel == ROT_S450) {
    float centerHeading = (rotModel == ROT_N450) ? 0.0 : 180.0;
    float targetOffset = physTarget - centerHeading;
    if (targetOffset > 180.0) targetOffset -= 360.0;
    if (targetOffset < -180.0) targetOffset += 360.0;
    float cwDist = targetOffset - mechanicalAzOffset;
    float ccwDist = mechanicalAzOffset - targetOffset;
    float maxTravel = 225.0;
    bool cwValid = (mechanicalAzOffset + cwDist) <= maxTravel;
    bool ccwValid = (mechanicalAzOffset - ccwDist) >= -maxTravel;
#if DEBUG_ENABLED
    Serial.printf("DBG:PROT_AZ:N450S450:center=%.1f tgtOff=%.1f cwDist=%.1f ccwDist=%.1f cwVal=%d ccwVal=%d\n", 
      centerHeading, targetOffset, cwDist, ccwDist, cwValid, ccwValid);
#endif
    if (cwValid && ccwValid) {
      if (abs(cwDist) < abs(ccwDist)) mustRotateCW = true; else mustRotateCCW = true;
    } else if (cwValid) { mustRotateCW = true; } else if (ccwValid) { mustRotateCCW = true; }
  }
#if DEBUG_ENABLED
  Serial.printf("DBG:PROT_AZ:FLAGS:mustCW=%d mustCCW=%d diff=%.1f\n", mustRotateCW, mustRotateCCW, diff);
#endif
  if (mustRotateCW || (diff > 1.0 && !mustRotateCCW)) {
    // Need to move CW (RIGHT)
#if DEBUG_ENABLED
    Serial.printf("DBG:PROT_AZ:ACTION:NEED_CW:azDir=%d\n", azDirection);
#endif
    if (azDirection == DIR_CCW) {
      // Direction reversal — stop, delay, then resume
#if DEBUG_ENABLED
      Serial.println("DBG:PROT_AZ:ACTION:REVERSAL_CW");
#endif
      stopAzimuth(); protocolAzReversing = true; protocolAzReverseStart = millis(); protocolAzPendingDir = "RIGHT";
    } else if (azDirection != DIR_CW) {
      // Not currently moving — start CW movement
#if DEBUG_ENABLED
      Serial.println("DBG:PROT_AZ:ACTION:START_CW");
#endif
      executeAzimuthMove("RIGHT");
    } else {
#if DEBUG_ENABLED
      Serial.println("DBG:PROT_AZ:ACTION:CONTINUE_CW");
#endif
    }
    // If already DIR_CW: do nothing, movement continues toward new target
  } else if (mustRotateCCW || diff < -1.0) {
    // Need to move CCW (LEFT)
#if DEBUG_ENABLED
    Serial.printf("DBG:PROT_AZ:ACTION:NEED_CCW:azDir=%d\n", azDirection);
#endif
    if (azDirection == DIR_CW) {
      // Direction reversal — stop, delay, then resume
#if DEBUG_ENABLED
      Serial.println("DBG:PROT_AZ:ACTION:REVERSAL_CCW");
#endif
      stopAzimuth(); protocolAzReversing = true; protocolAzReverseStart = millis(); protocolAzPendingDir = "LEFT";
    } else if (azDirection != DIR_CCW) {
      // Not currently moving — start CCW movement
#if DEBUG_ENABLED
      Serial.println("DBG:PROT_AZ:ACTION:START_CCW");
#endif
      executeAzimuthMove("LEFT");
    } else {
#if DEBUG_ENABLED
      Serial.println("DBG:PROT_AZ:ACTION:CONTINUE_CCW");
#endif
    }
    // If already DIR_CCW: do nothing, movement continues toward new target
  } else {
#if DEBUG_ENABLED
    Serial.println("DBG:PROT_AZ:ACTION:STOPPED (at target)");
#endif
    stopAzimuth(); protocolTargetAzSet = false;
  }
}

void executeProtocolElMove(float targetEl) {
  if (targetEl < 0.0) targetEl = 0.0;
  if (targetEl > 180.0) targetEl = 180.0;
  
  // When ELF is on, incoming targets are in satellite space — transform to physical
  float physTarget = elfEl(targetEl);
  
  // Direction calculation: compare in the same coordinate space
  // When ELF is on, both in satellite space; when off, use raw physical coords
  float curForDiff = elfEl(currentEl);
  float diff = targetEl - curForDiff;
  
  // Don't start movement if target is within auto-stop tolerance and we're stopped
  // This prevents relay clicking when new targets arrive within the zone where
  // auto-stop would immediately kill movement anyway
  if (elDirection == DIR_STOPPED && !protocolTargetElSet && abs(diff) <= PROTOCOL_STOP_TOLERANCE) {
#if DEBUG_ENABLED
    Serial.printf("DBG:PROT_EL:TOLERANCE:diff=%.1f within %d tolerance, not starting\n", diff, (int)PROTOCOL_STOP_TOLERANCE);
#endif
    protocolTargetEl = physTarget;
    return;
  }
  
  protocolTargetEl = physTarget;
  protocolTargetElSet = true;
  
  // Convert satellite-space direction to physical direction
  // In ELF mode: satellite UP = physical DOWN (Real El = 180 - Sat El)
  String moveDir;
  if (diff > 1.0) {
    moveDir = elfMode ? "DOWN" : "UP";
  } else if (diff < -1.0) {
    moveDir = elfMode ? "UP" : "DOWN";
  } else {
    stopElevation(); protocolTargetElSet = false;
    return;
  }
  
  if (moveDir == "UP") {
    if (elDirection == DIR_DOWN) {
      stopElevation(); protocolElReversing = true; protocolElReverseStart = millis(); protocolElPendingDir = "UP";
    } else { executeElevationMove("UP"); }
  } else {
    if (elDirection == DIR_UP) {
      stopElevation(); protocolElReversing = true; protocolElReverseStart = millis(); protocolElPendingDir = "DOWN";
    } else { executeElevationMove("DOWN"); }
  }
}

// ==================== DEFAULT PROTOCOL HANDLER ====================
// Hamlib's universal protocol - used over TCP by clients like Gpredict/rotctl
// Command format: single char + optional args, separated by spaces
// Response format: "RPRT 0\n" for success, "value\n" for queries, "RPRT -N\n" for errors

// Send a Default Protocol response back over the SAME interface the command
// arrived on (TCP clients are answered over TCP; serial over serial).
void dpSend(const String& response) {
  String full = response + "\n";

  // Route the reply to the interface that delivered the command
  bool delivered = false;
  if (protocolRxSource == RX_SRC_SER) {
    Serial.print(full);
    delivered = true;
  } else if (rotctlConnected && rotctlClient.connected()) {
    rotctlClient.print(full);
    delivered = true;
  }

  // Debug log: record where the response went ("DROP" = no delivery target)
  dbgLogCapture("TX", delivered ? (protocolRxSource == RX_SRC_SER ? "SER" : "TCP") : "DROP", full.c_str());

  strncpy(protocolLastResponse, response.c_str(), PROTOCOL_BUF_SIZE - 1);
  protocolLastResponse[PROTOCOL_BUF_SIZE - 1] = '\0';
}

// Send RPRT response
void dpRprt(int code) {
  dpSend("RPRT " + String(code));
}

// Parse space-separated arguments from a command line
// Returns number of args found (max 4)
int dpParseArgs(char* line, char* args[4]) {
  int count = 0;
  char* p = strtok(line, " ");
  while (p && count < 4) {
    args[count++] = p;
    p = strtok(NULL, " ");
  }
  return count;
}

// Process TCP commands on port 4533
// When Hamlib Server = Y: speak rotctl text protocol (Gpredict)
// When Hamlib Server = N: speak configured serial protocol (GS-232A/B/Easycom)
void processDefaultProtocolCommand(const char* cmd, int len) {
  if (len == 0) return;

  // Route based on Hamlib Server setting
  if (!hamlibServerEnabled) {
    // Speak the configured serial protocol over TCP
    processProtocolCommand(cmd, len);
    return;
  }

  // Hamlib Server enabled — speak rotctl text protocol
  // Make a mutable copy for strtok
  char buf[PROTOCOL_BUF_SIZE];
  strncpy(buf, cmd, PROTOCOL_BUF_SIZE - 1);
  buf[PROTOCOL_BUF_SIZE - 1] = '\0';

  char* args[4];
  int argc = dpParseArgs(buf, args);
  if (argc == 0) return;

  // Replace commas with periods in all args (Gpredict locale handling)
  for (int i = 0; i < argc; i++) {
    char* p = args[i];
    while (*p) {
      if (*p == ',') *p = '.';
      p++;
    }
  }

  char cmdChar = args[0][0];
  
  switch (cmdChar) {
    case 'p': {
      // Get position → returns azimuth\nelevation\nRPRT 0\n
      float az = displayAzimuth(currentAz);
      float el = currentEl;
      
      // During motor engagement, report last known good position to avoid
      // stale ADC readings that show backward drift (mechanical backlash)
      unsigned long now = millis();
      if (azEngageStart > 0 && (now - azEngageStart < MOTOR_ENGAGE_DELAY_MS)) {
        az = azPositionAtEngage;
      }
      if (elEngageStart > 0 && (now - elEngageStart < MOTOR_ENGAGE_DELAY_MS)) {
        el = elPositionAtEngage;
      }
      
      // When ELF mode is on, report effective satellite coords
      az = elfAz(az);
      el = elfEl(el);
      
      // Convert to -180..+180 range for Gpredict compatibility
      // Gpredict's AzType=1 config expects negative azimuths
      if (az > 180.0) az -= 360.0;
      
      #if DEBUG_ENABLED
      Serial.print("DBG:DP_P:az="); Serial.print(az, 2);
      Serial.print(" el="); Serial.print(el, 2);
      Serial.print(" rawAz="); Serial.print(currentAz, 2);
      Serial.print(" rawEl="); Serial.println(currentEl, 2);
      #endif
      // Send all 3 lines in ONE TCP packet - Gpredict does a single recv()
      // and expects azimuth\nelevation\nRPRT N\n all at once
      dpSend(String(az, 2) + "\n" + String(el, 2) + "\nRPRT 0");
      break;
    }
    
    case 'P': {
      // Set position: P azimuth elevation
      if (argc >= 3) {
        float targetAz = atof(args[1]);
        float targetEl = atof(args[2]);
        
        // Clamp values
        if (targetAz < 0) targetAz += 360;
        if (targetAz >= 360) targetAz -= 360;
        if (targetEl < 0) targetEl = 0;
        if (targetEl > 180) targetEl = 180;
        
        // Calculate direction in satellite space BEFORE transforming to physical
        // Transform current physical position to satellite space for comparison
        float satCurAz = elfAz(currentAz);
        float satCurEl = elfEl(currentEl);
        float diffAz = targetAz - satCurAz;
        if (diffAz > 180) diffAz -= 360;
        if (diffAz < -180) diffAz += 360;
        
        String wantAzDir = "STOP";
        if (abs(diffAz) > 1.0) {
          wantAzDir = (diffAz > 0) ? "RIGHT" : "LEFT";
        }
        
        float diffEl = targetEl - satCurEl;
        String wantElDir = "STOP";
        if (abs(diffEl) > 1.0) {
          wantElDir = (diffEl > 0) ? "UP" : "DOWN";
        }
        
        // Now transform satellite coords to physical rotator coords for actual movement
        float physTargetAz = elfAz(targetAz);
        float physTargetEl = elfEl(targetEl);
        
        // Always update protocol targets for auto-stop (physical coords)
        protocolTargetAz = physTargetAz;
        protocolTargetAzSet = true;
        protocolTargetEl = physTargetEl;
        protocolTargetElSet = true;
        
        // Only change motors if direction actually changed — don't restart same-direction movement
        if (wantAzDir == "STOP") {
          stopAzimuth();
        } else if (azDirection == DIR_STOPPED ||
                   (wantAzDir == "RIGHT" && azDirection != DIR_CW) ||
                   (wantAzDir == "LEFT" && azDirection != DIR_CCW)) {
          executeAzimuthMove(wantAzDir);
        }
        // else: already moving CW/CCW, same direction — just keep going
        
        if (wantElDir == "STOP") {
          stopElevation();
        } else if (elDirection == DIR_STOPPED ||
                   (wantElDir == "UP" && elDirection != DIR_UP) ||
                   (wantElDir == "DOWN" && elDirection != DIR_DOWN)) {
          executeElevationMove(wantElDir);
        }
        // else: already moving UP/DOWN, same direction — just keep going
      }
      dpRprt(0);
      break;
    }
    
    case 'S': {
      // Stop rotation
      stopAll();
      dpRprt(0);
      break;
    }
    
    case 's': {
      // Get status: returns status flags as integer + RPRT 0
      int status = 0;
      if (azDirection != DIR_STOPPED || elDirection != DIR_STOPPED) {
        status |= 4;  // Moving
      }
      dpSend(String(status));
      dpRprt(0);
      break;
    }
    
    case 'M': {
      // Move: M direction [speed]
      // Direction: LEFT, RIGHT, UP, DOWN, or numeric
      if (argc >= 2) {
        String dir = args[1];
        dir.toUpperCase();
        if (dir == "LEFT" || dir == "CCW") executeAzimuthMove("LEFT");
        else if (dir == "RIGHT" || dir == "CW") executeAzimuthMove("RIGHT");
        else if (dir == "UP") executeElevationMove("UP");
        else if (dir == "DOWN") executeElevationMove("DOWN");
        else {
          // Numeric direction
          int d = atoi(args[1]);
          if (d == 1 || d == -1) executeAzimuthMove(d > 0 ? "RIGHT" : "LEFT");
          else if (d == 2 || d == -2) executeElevationMove(d > 0 ? "UP" : "DOWN");
        }
      }
      dpRprt(0);
      break;
    }
    
    case '_': {
      // Get info/version
      dpSend("AZELCtrl v" + String(FIRMWARE_VERSION));
      dpRprt(0);
      break;
    }
    
    case 'K': {
      // Park (not implemented, treat as stop)
      stopAll();
      dpRprt(0);
      break;
    }
    
    case 'R': {
      // Reset: R reset_type
      // reset_type: 0 = soft, 1 = hard, 2 = park
      stopAll();
      dpRprt(0);
      break;
    }
    
    case 'v': {
      // Get level: v level_name
      // ROT_LEVEL_ROT_SPEED = rotation speed (not implemented, return default)
      if (argc >= 2 && strcmp(args[1], "ROT_LEVEL_ROT_SPEED") == 0) {
        dpSend("1");  // Default speed
      } else {
        dpRprt(-2);  // EINVAL
        return;
      }
      dpRprt(0);
      break;
    }
    
    case 'V': {
      // Set level: V level_name value
      if (argc >= 3 && strcmp(args[1], "ROT_LEVEL_ROT_SPEED") == 0) {
        // Speed setting not yet implemented, accept silently
        dpRprt(0);
      } else {
        dpRprt(-2);  // EINVAL
      }
      break;
    }
    
    case 'q': {
      // Quit connection
      dpRprt(0);
      break;
    }
    
    default: {
      dpRprt(-2);  // EINVAL - unknown command
      break;
    }
  }
}
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
void loop() {
  // Handle protocol commands
  processProtocolInput();
  
  // Flush a stalled partial command (unterminated/malformed input) so the
  // parser state can't wedge
  checkProtocolStall();
  
  // Check for TCP client connections
  checkRotctlClient();
  
  // Pick up NTP time (debug-log wall-clock timestamps)
  checkTimeSync();
  
  // Rotor power presence check (every 500ms, debounced)
  checkRotorPower();
  
  // Handle web server
  if (!captivePortalActive) {
    server.handleClient();
  } else {
    tickCaptivePortal();
  }
  
  // Process DNS for captive portal effect (both captive portal and AP mode)
  if (captivePortalActive || wifiState == WIFI_AP_MODE) {
    dnsServer.processNextRequest();
  }
  
  // Tick WiFi connection
  tickWifi();
  
  // Check pause state
  checkPauseComplete();
  
  // Handle buttons
  handleButtons();
  
  // Calibration mode
  if (calState != CAL_IDLE) {
    readPositions();  // Keep ADC readings fresh during calibration
    updateCalibrationState();
    displayCalibrationScreen();
    return;
  }
  
  // Update positions regularly regardless of mode (OLED + TCP both need fresh data)
  static unsigned long lastPositionUpdate = 0;
  if (millis() - lastPositionUpdate >= 200) {
    readPositions();
    lastPositionUpdate = millis();
  }
  
  // Menu mode
  if (currentMenu) {
    currentMenu->tick();
    // tick() may have changed currentMenu (e.g., timer auto-fired actionRotatorControl)
    if (currentMenu) {
      currentMenu->draw();
    }
  } else {
    // Rotator control mode
    static unsigned long lastUpdate = 0;
    const unsigned long UPDATE_INTERVAL = 200;
    
    if (millis() - lastUpdate >= UPDATE_INTERVAL) {
      readPositions();
      // Update mechanical offset for N450/S450 variants based on position change
      if ((rotModel == ROT_N450 || rotModel == ROT_S450) && azDirection != DIR_STOPPED) {
        // Calculate position change from previous reading
        float azDelta = currentAz - lastAzReading;
        // Handle wrap-around
        if (azDelta > 180.0) azDelta -= 360.0;
        if (azDelta < -180.0) azDelta += 360.0;
        // Update mechanical offset based on direction
        if (azDirection == DIR_CW) {
          mechanicalAzOffset += azDelta;  // CW increases offset
        } else if (azDirection == DIR_CCW) {
          mechanicalAzOffset += azDelta;  // CCW decreases offset (delta is negative)
        }
        // Clamp to mechanical limits
        if (mechanicalAzOffset > 225.0) mechanicalAzOffset = 225.0;
        if (mechanicalAzOffset < -225.0) mechanicalAzOffset = -225.0;
        lastAzReading = currentAz;
      }
      // Handle direction reversal delay
      if (protocolAzReversing) {
        if (millis() - protocolAzReverseStart >= (unsigned long)(protocolReverseDelay * 1000)) {
          protocolAzReversing = false;
          executeAzimuthMove(protocolAzPendingDir);
        }
      }
      if (protocolElReversing) {
        if (millis() - protocolElReverseStart >= (unsigned long)(protocolReverseDelay * 1000)) {
          protocolElReversing = false;
          executeElevationMove(protocolElPendingDir);
        }
      }
      // Auto-stop protocol targets when reached (after position is updated)
      if (protocolTargetAzSet && !protocolAzReversing) {
        float currentAzDisplay = displayAzimuth(currentAz);
        float diff = protocolTargetAz - currentAzDisplay;
        if (diff > 180.0) diff -= 360.0;
        if (diff < -180.0) diff += 360.0;
        if (abs(diff) <= 1.0) {
          stopAzimuth();
          protocolTargetAzSet = false;
        }
      }
      if (protocolTargetElSet && !protocolElReversing) {
        float diff = protocolTargetEl - currentEl;
        if (abs(diff) <= 1.0) {
          stopElevation();
          protocolTargetElSet = false;
        }
      }
      updateRotatorDisplay();
      lastUpdate = millis();
    }
  }
  // Auto-stop protocol targets when reached (always run, even in menu mode)
  // Use direction-based cross-target detection
  // Read cached currentAz/currentEl updated by readPositions() every 200ms
  static unsigned long lastDebugPrint = 0;
  if (millis() - lastDebugPrint >= 500) {
    lastDebugPrint = millis();
    #if DEBUG_ENABLED
    Serial.print("DBG:AUTO_CHECK:azSet="); Serial.print(protocolTargetAzSet);
    Serial.print(" elSet="); Serial.print(protocolTargetElSet);
    Serial.print(" azRev="); Serial.print(protocolAzReversing);
    Serial.print(" ads="); Serial.println(adsPresent);
    #endif
  }
  if (protocolTargetAzSet || protocolTargetElSet) {
    // Rate-limit auto-stop checks to match position update rate (100ms)
    static unsigned long lastAutoStopCheck = 0;
    if (millis() - lastAutoStopCheck >= 100) {
      lastAutoStopCheck = millis();
      
      if (protocolTargetAzSet && !protocolAzReversing) {
        float curAzDisplay = displayAzimuth(currentAz);
        float targetAz = protocolTargetAz;
        float diff = targetAz - curAzDisplay;
        if (diff > 180.0) diff -= 360.0;
        if (diff < -180.0) diff += 360.0;
        #if DEBUG_ENABLED
        Serial.print("DBG:AUTO_AZ:cur="); Serial.print(curAzDisplay);
        Serial.print(" tgt="); Serial.print(protocolTargetAz);
        Serial.print(" diff="); Serial.print(diff);
        Serial.print(" dir="); Serial.println(azDirection);
        #endif
        bool crossed = false;
        static bool inCWWrap = false;
        static bool inCCWWrap = false;
        
        if (!inCWWrap && !inCCWWrap) {
          if (azDirection == DIR_CW && curAzDisplay > 180.0 && protocolTargetAz < 180.0) {
            inCWWrap = true;
          } else if (azDirection == DIR_CCW && curAzDisplay < 180.0 && protocolTargetAz > 180.0) {
            inCCWWrap = true;
          }
        }
        
        if (inCWWrap) {
          float unwrappedTarget = protocolTargetAz + 360.0;
          float compareCurrent = curAzDisplay;
          if (compareCurrent < 180.0) compareCurrent += 360.0;
          if (compareCurrent >= unwrappedTarget) crossed = true;
          if (crossed || !protocolTargetAzSet) inCWWrap = false;
        }
        else if (inCCWWrap) {
          float unwrappedTarget = protocolTargetAz - 360.0;
          float compareCurrent = curAzDisplay;
          if (compareCurrent > 180.0) compareCurrent -= 360.0;
          if (compareCurrent <= unwrappedTarget) crossed = true;
          if (crossed || !protocolTargetAzSet) inCCWWrap = false;
        }
        
        float normDiff = diff;
        if (normDiff > 180.0) normDiff -= 360.0;
        if (normDiff < -180.0) normDiff += 360.0;
        // Tolerance accounts for mechanical overshoot: motor keeps moving after power cut.
        // 3.0° stops early enough to avoid ±3-5° oscillation observed in tracking.
        if (abs(normDiff) <= 3.0) crossed = true;
        
        if (crossed) {
          #if DEBUG_ENABLED
          Serial.println("DBG:AUTO_AZ:STOP!");
          #endif
          stopAzimuth();
          protocolTargetAzSet = false;
        }
      }
      
      if (protocolTargetElSet && !protocolElReversing) {
        float diff = protocolTargetEl - currentEl;
        #if DEBUG_ENABLED
        Serial.print("DBG:AUTO_EL:cur="); Serial.print(currentEl);
        Serial.print(" tgt="); Serial.print(protocolTargetEl);
        Serial.print(" diff="); Serial.print(diff);
        Serial.print(" dir="); Serial.println(elDirection);
        #endif
        bool crossed = false;
        if (elDirection == DIR_UP && diff < 0.0) crossed = true;
        if (elDirection == DIR_DOWN && diff > 0.0) crossed = true;
        // Same tolerance logic as azimuth - account for mechanical overshoot
        if (crossed || abs(diff) <= 3.0) {
          #if DEBUG_ENABLED
          Serial.println("DBG:AUTO_EL:STOP!");
          #endif
          stopElevation();
          protocolTargetElSet = false;
        }
      }
    }
  }
  
  // Elevation limit protection — always run when elevation is moving,
  // regardless of whether movement came from protocol or buttons
  // Use cached currentEl updated by readPositions() every 200ms
  if (elDirection != DIR_STOPPED) {
    static float lastElReading = -1;
    static unsigned long lastElCheck = 0;
    static int stallCount = 0;
    
    if (millis() - lastElCheck >= 500) {
      lastElCheck = millis();
      bool shouldStop = false;
      
      // Hard limit: DOWN at bottom (< 0.5°) or UP at top (> 179.5°)
      if (elDirection == DIR_DOWN && currentEl < 0.5F) {
        shouldStop = true;
      }
      if (elDirection == DIR_UP && currentEl > 179.5F) {
        shouldStop = true;
      }
      
      // Stall detection: elevation hasn't changed by 0.5° in the timeout period
      unsigned long stallTimeout = (elDirection == DIR_UP && currentEl < 1.0F) ? 3000 : 500;
      if (!shouldStop && millis() - lastElCheck >= stallTimeout) {
        if (lastElReading >= 0) {
          float elChange = abs(currentEl - lastElReading);
          if (elChange < 0.5F) {
            stallCount++;
            if (stallCount >= 3) {
              shouldStop = true;
            }
          } else {
            stallCount = 0;
          }
        }
        lastElReading = currentEl;
      }
      
      if (shouldStop) {
        #if DEBUG_ENABLED
        Serial.print("DBG:EL_LIMIT:STOP:el="); Serial.print(currentEl);
        Serial.print(" dir="); Serial.println(elDirection == DIR_UP ? "UP" : "DOWN");
        #endif
        stopElevation();
        protocolTargetElSet = false;
        lastElReading = -1;
      }
    }
  }
  
  delay(10);
}
