wklaaks/azelctrl/(commit log)

2026-07-03 Initial commit: Yaesu rotator controller with menu system, WiFi management, and calibration
2026-07-03 Recover lost development work from logs:
    - Add drawQuickNotice() for 3-line big-text notices (center/left align)
    - Add ESP.wdtFeed() in blocking WiFi loops to prevent watchdog resets
    - Fix null pointer crash: check currentMenu after tick() before draw()
    - Add stopAll() in actionRotatorControl() before switching modes
    - Update rotator display: large Az/El values, decimal-aligned, movement indicators (+/-)
    - Update WiFi Connecting screen: title, Network: label, remove redundant 2:Cancel
    - Add Connected! screen with signal strength (RSSI + quality rating)
    - Fix String lifetime bugs in actionReviewWifi, actionConnectWifi, actionApStatus
    - Update wifiStatusMenu: title 'Ctrl or Calibration?', item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
    [ycint.ino]
2026-07-03 Add restart feature: hold Btn2 + long-press Btn1 when IDLE selected triggers ESP.restart()
    - Shows 'Restarting...' notice before reboot
    - Footer updated to show shortcut: 1.Cycle 2!Go 2+1|RST
    - Btn1 long-press tracking added for rotator control mode
    - Short press still cycles directions normally
    [ycint.ino]
2026-07-03 Fix pin configuration: AZ_ENABLE=D2, EL_ENABLE=D1 (swapped to match correct hardware wiring)
    [ycint.ino]
2026-07-03 Fix Btn2 Back not working in CAL_ERROR/CAL_COMPLETE states
    Btn2 now exits calibration when in terminal states (CAL_ERROR, CAL_COMPLETE), returning to the Calibrate Pots menu.
    [ycint.ino]
2026-07-03 Fix AZ/EL values not updating in calibration screen
    readPositions() was only called in rotator control mode, not calibration mode. Added it to the calibration branch so ADC values are live during calibration.
    [ycint.ino]
2026-07-03 Complete calibration redesign:
    - Voltage-based calibration by sweeping to hard limits
    - CAL_CHECK_STABILITY: 1s voltage stability check to detect unplugged cable
    - CAL_SWEEP_MIN: Move CCW/DOWN until voltage stabilizes (hit limit)
    - CAL_SWEEP_MAX: Move CW/UP until voltage stabilizes or hits 3.250V safety limit
    - Timeout after 2min per sweep → prompt user: Btn1 proceed, Btn2 cancel
    - Voltage safety: refuse RIGHT/UP movement if voltage >= 3.250V
    - Position calculation uses calibrated min/max: AZ -180..+180, EL 0..90
    - Calibration saved to EEPROM (bytes 67-83) and loaded on boot
    - Raw voltage display on rotator screen (AzV/ElV)
    - Display live voltage during calibration phases
    - EEPROM.begin()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
    [ycint.ino]
2026-07-03 Add raw voltage display to calibration screen
    Each calibration screen now shows:
    AZ: <degrees> (<voltage>V)
    EL: <degrees> (<voltage>V)
    Also fixed scope issue — moved calibration variables before movement functions.
    [ycint.ino]
2026-07-03 Clean up calibration screen display:
    - Axis-specific sweep text: 'CCW/CW' for AZ, 'DOWN/UP' for EL
    - Remove redundant 'Voltage:' lines (voltages shown at bottom)
    - Fix EL line overlapping separator/footer by moving readings to single line at y=32
    - Compact format: AZ:123.4(1.234V) EL:45.6(2.345V)
    [ycint.ino]
2026-07-03 Fix calibration screen layout:
    - 'CALIBRATION COMPLETE' → 'CALIBRATED' (saves a line)
    - Min/Max on same line in CAL_COMPLETE
    - AZ and EL readings on separate lines (y=32, y=43) to prevent overflow
    - Separator at y=51, footer at y=53
    [ycint.ino]
2026-07-03 Show calibration min/max in mV to save screen space
    'Min:45mV Max:3187mV' fits on one line without wrapping.
2026-07-03 Show AZ/EL voltages in mV on calibration screen
    AZ:123(1234mV) EL:45(2345mV) - more compact than V format.
2026-07-03 Cache ADC voltages in readPositions() instead of re-reading in display
    Added azVoltage/elVoltage globals updated by readPositions(). Display functions now reuse the cached values instead of calling ads.readADC_SingleEnded() again.
2026-07-03 Fix unplugged cable detection in calibration
    - Lowered unplugged threshold from 100mV to 30mV (CAL_UNPLUGGED_THRESHOLD)
    - Extended stability check from 1s to 2s for more reliable detection
    - Your unplugged cable fluctuates ~43mV, now caught by 30mV threshold
    [ycint.ino]
2026-07-03 Redesign cable detection: move motor and check for voltage change
    Instead of checking voltage fluctuation (unreliable), now moves motor CCW/DOWN for 3 seconds and checks if voltage changed by at least 50mV. If no change detected, cable is unplugged or pot disconnected.
    [ycint.ino]
2026-07-03 Cable check moves both directions to handle parked rotators
    Now moves CCW for 1.5s, then CW for 1.5s. If voltage doesn't change in either direction, cable is unplugged. Fixes false positive when rotator is already at a limit.
    [ycint.ino]
2026-07-03 Extend cable check to 3s per direction (6s total)
2026-07-03 Fix CAL_ERROR screen text overlap
    Moved AZ/EL readings from y=32/43 to y=40/51 so they don't overlap with the error message and button prompts.
    [ycint.ino]
2026-07-03 Redesign calibration screen layout:
    - Removed inline button prompts from content area
    - Moved all button hints to context-sensitive footer:
    CAL_COMPLETE: 1.Done 2.Back
    CAL_ERROR: 1.Retry 2.Back
    TIMEOUT: 1.Proceed 2.Cancel
    DEFAULT: 1.Exit 2.Back
    - AZ/EL readings at y=32/43, separator at y=53, footer at y=56
    - No more text overlap
    [ycint.ino]
2026-07-03 Show movement direction during cable check
    Displays 'Trying CCW...', 'Trying CW...', 'Trying DOWN...', or 'Trying UP...' during calibration cable stability check.
    [ycint.ino]
2026-07-03 Fix retry not showing movement indicators on CAL_ERROR
    Reset calDirection and stability tracking on retry so cable check starts fresh with 'Trying CCW...' indicator.
    [ycint.ino]
2026-07-03 Show 'Stopped' during cable check initial state
    When calDirection is (before movement starts), display 'Stopped' instead of blank line.
2026-07-03 Fix cable check motor not starting on retry
    calVSampleIdx was incremented before the ==0 check, so motor never started. Changed to <=1 to account for the pre-increment.
    [ycint.ino]
2026-07-03 Raise cable detection threshold to 70mV
    Unplugged cable noise was ~43mV, occasionally passing the 50mV threshold. 70mV provides margin for noise while still detecting real cable movement.
    [ycint.ino]
2026-07-03 Restructure calibration screen layout:
    - Title bar now shows dynamic status: 'Cal-AZ:Check Cable...' or 'Cal-EL:ERROR!'
    - Status text moved from content area into title bar
    - Content area starts at y=10 with 'Trying CCW...' or error message
    - Freed up space by removing redundant status lines
    [ycint.ino]
2026-07-03 Fix title bar text positioning
    Use sequential print instead of setCursor(43) to avoid SSD1306 cursor tracking issues. Title now flows naturally: 'Cal-AZ: Check Cable'
    [ycint.ino]
2026-07-03 Add missing setCursor calls in calibration content area
    All content cases now properly set cursor position before printing, preventing text from appending to the title bar.
    [ycint.ino]
2026-07-03 Align voltage values in calibration screen
    - Space before '(': '-180.0 ( 123mV)'
    - Voltage padded to 4 digits for alignment (1mV to 3300mV)
2026-07-03 Show voltage delta in cable error message
    'dV (43mV) too small' instead of 'No voltage change' — gives user actual measured delta.
    [ycint.ino]
2026-07-03 Add 'Check cables & pwr' hint on calibration error screen
    [ycint.ino]
2026-07-03 Move 'Check cables & pwr' up 1 pixel on error screen
    [ycint.ino]
2026-07-03 Remove voltage display from AZ/EL menu screen
    Voltage readout was wrapping and overwriting the AZ label. Raw voltages are shown on calibration screens instead.
2026-07-03 Fix AZ/EL decimal alignment on large font screen
    Pad values to 6 chars (max '-180.0') instead of 5, so negative AZ values align with EL.
    [ycint.ino]
2026-07-03 Replace +/- with arrow indicators on AZ/EL screen
    - Azimuth: ◄ for LEFT, ► for RIGHT
    - Elevation: ▼ for DOWN, ▲ for UP
    - Arrows drawn with drawPixel, vertically centered in text height
    [ycint.ino]
2026-07-03 Fix arrow position: use getCursorX() to place arrows after last digit
    Arrows now appear right after the value instead of at a fixed x position.
    [ycint.ino]
2026-07-03 Replace pixel-drawn arrows with font characters
    - Azimuth: '<' for LEFT, '>' for RIGHT
    - Elevation: '^' for UP, 'v' for DOWN
    - Much simpler, properly positioned, no alignment issues
    [ycint.ino]
2026-07-03 Fix arrow position: use print instead of println
    Removed println that was pushing arrows to next line. Arrows now appear inline with values.
    [ycint.ino]
2026-07-03 Fix arrow positioning: use calculated x instead of cursor tracking
    SSD1306 library doesn't track cursor after String print. Use char count × 6px + 2px spacing for arrow x position.
    [ycint.ino]
2026-07-03 Add horizontal shaft to left/right arrows
    Right arrow: → (shaft + arrowhead, 9px wide)
    Left arrow: ← (arrowhead + shaft, 9px wide)
    All arrows now consistent at 9px width, positioned at x=114
2026-07-03 Extend arrow shafts to meet diagonal lines
    Right arrow: shaft x=0..6, arrowhead x=7..8
    Left arrow: arrowhead x=0..1, shaft x=2..8
    No visible gap between shaft and arrowhead tip.
2026-07-03 Redesign left/right arrows with proper triangular arrowhead
    Arrowhead now converges gradually from y=1/10 to y=5/6 over 5 columns, giving ~45° angle instead of T-shape.
    [ycint.ino]
2026-07-03 Redesign up/down arrows with shaft + triangular arrowhead
    Up: ↑ triangular arrowhead at top, vertical shaft below
    Down: ↓ vertical shaft at top, triangular arrowhead at bottom
    All four arrows now consistent: shaft + triangular head style
    [ycint.ino]
2026-07-04 Add rotator model selection (North/South facing, extended range)
    - Boot setup screen asks:
    1. Azimuth facing: NORTH (-180 to +180) or SOUTH (0 to 360)
    2. Extended range? (only if South): NO (0-360) or YES (0-450)
    - Saved to EEPROM (bytes 84-86, magic 0x5A), skipped on reboot
    - 'Rotator Model' menu item in WiFi Connect menu to reconfigure
    - Degree calculation updated: azOffset() + fraction * azSpan()
    - North: -180 + fraction * 360
    - South: 0 + fraction * 360
    - South Extended: 0 + fraction * 450
    [ycint.ino]
2026-07-04 Fix ROTATOR SETUP screen formatting to match standard convention
    - Title bar: white text on black with solid separator at row 8
    - Options: inverted highlight (white bg, black text) for selected item
    - Footer: dotted separator at row 53, notation at row 56
    - Button notation: 1.Cycle 2.Next / 1.Cycle 2.Done / 1.OK 2.Retry
    - Shortened labels: N/S instead of NORTH/SOUTH, keep degree ranges
    - Default selection: North
    [ycint.ino]
2026-07-04 Fix inverted highlight height: 11px → 8px to match text bounds
    [ycint.ino]
2026-07-04 Fix rotator setup: label, footer text, and Btn2 debounce
    - 'Azimuth facing:' → 'Az Orientation ?'
    - Footer: '2.Next' → '2.Select'
    - Add wait-for-release on all Btn2 handlers to prevent
    rapid re-trigger when returning between screens
    [ycint.ino]
2026-07-04 Add boot menu system with setup flow
    - Boot menu: 'Skip' (3s auto-select) / 'Setup'
    - First boot: 'No Settings...' notice (3s) → direct to Setup
    - Setup menu: 'Rotator' (5s auto-timer if not configured) / 'WiFi'
    - WiFi mode selection: Station / Access Point / Disable
    - Saved to EEPROM (bytes 84-85, magic 0x4D)
    - Station: connects to saved SSID → WiFi Status menu
    - AP: starts AP → AP menu
    - Disable: disconnects WiFi entirely
    - Rotator menu option in Setup links to existing rotator setup
    - User cannot Skip if rotator model not yet configured
    - EEPROM layout updated: WiFi mode (84-85), Rotator model (86-88)
    [ycint.ino]
2026-07-04 Fix rotator setup: No Settings display, Retry nav, button debounce
    - 'No Settings...' split to two center-justified lines: 'No' / 'Settings...'
    - Restructure setupRotatorModel() as state machine (Q1→Q2→Confirm)
    - '2.Retry' on confirmation screen goes back to Q1 (Az Orientation)
    instead of clearing EEPROM and re-entering from setup()
    - Add wait-for-button-release before drawing each new screen to prevent
    rapid cycling when button still held after transition
    - actionSetupRotator() waits for button release before entering setup
    [ycint.ino]
2026-07-04 Fix WiFi Mode menu: parent set to Setup so Back works
    [ycint.ino]
2026-07-04 Refactor rotator setup: single screen with 4 model options
    - Replace RotFacing+RotExtended with single RotModel enum:
    ROT_N360 (-180 to 180), ROT_S360 (0 to 360),
    ROT_N450 (-180 to 270), ROT_S450 (0 to 450)
    - Single setup screen with 4 options, no multi-step flow
    - Footer: 1.Cycle 1!Select 2.Back
    - Short press Btn1 cycles, long press selects & saves
    - EEPROM simplified: single byte for model (addr 86), magic (addr 87)
    - Updated azOffset(), azSpan(), azRangeLabel() for new enum
    - Updated actionRotatorModel() to show new model names
    [ycint.ino]
2026-07-04 Add Station Settings screen replacing WiFi Connect menu
    - 'Station Settings' screen with 2 options:
    'Set via HTTP' (starts captive portal)
    'Connect' (connects using saved credentials)
    - Below dotted separator shows:
    SSID:<value> or SSID: None
    Passwd: r*..*0 format (first char, *..*, last char)
    - Long press Btn2 to select an option
    - Replaces old WiFi Connect menu flow when entering
    Station mode from Setup > WiFi > Station
    [ycint.ino]
2026-07-05 Refactor Station Settings: Connect/Disconnect flow, reusable waitForWifiConnection(), wipe settings, button carryover fixes
    - Dynamic Connect/Disconnect option based on WiFi status
    - Extract waitForWifiConnection() for reusable connect display
    - Show 'Dis-/Connected' confirmation on Disconnect and Disable
    - Setup menu WiFi label shows current mode (Station/AP/None)
    - Default WiFi mode changed to DISABLED for unconfigured units
    - Add 'Wipe all settings' with confirmation screen
    - Timer countdown format: '[N]' (removed space and 's')
    - Fix button carryover for Btn1 long-press and Btn2 Back
    - setupRotatorModel() draw-first-then-wait pattern
    [ycint.ino]
2026-07-05 Major calibration and UI overhaul
    - Elevation range expanded from 0-90 to 0-180 degrees
    - Manual max heading adjustment (CAL_ADJUST_MAX) for both AZ and EL
    - AZ return sweep with cardinal heading pauses (S, SW, W, NW, N, NE, E, SE, S)
    - EL return sweep with elevation interval pauses (135, 90, 45, 0)
    - Streamlined calibration flow (eliminated redundant CCW->CW->CCW->CW)
    - Cable detection during CW/UP sweep (3-second voltage increase check)
    - Positive azimuth display (0-360) matching controller box
    - Voltage sample buffer cleared between sweep phases (prevents false stability)
    - Stability guard in CAL_SWEEP_MAX (requires 100mV increase before checking)
    - Boot menu: 'Skip' renamed to 'Rotator C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
    [ycint.ino]
2026-07-08 Add GS-232A/B and Easycom protocol support
    - Implement GS-232A/B commands: H, V, C, L, R, U, D, S, X, T, P, N, F
    - Implement Easycom commands: AZ, EL, AZEL, CW, CCW, UP, DOWN, STOP, TIMEOUT, SPEED, PARK, HELP, \?
    - Serial at 115200 baud, CRLF line endings
    - Debug output with DBG: prefix for easy filtering
    - MODE:ROTATOR escape command for blocking menus
    - Python test suite: 31/31 tests passing
2026-07-08 Add scrollable menu and PC Interface settings
    - Menu system now supports scrolling for >4 items (VISIBLE_ROWS=4)
    - New PC Interface submenu in SETUP for protocol configuration
    - Configurable serial baud rate: 9600, 19200, 38400, 57600, 115200
    - Baud rate persisted in EEPROM with magic value 0xB7
    - Baud rate applied immediately when changed
    - Test script: improved boot message filtering and flush timing
    - All 31/31 protocol tests still passing
2026-07-08 Fix PC Interface baud rate selection submenu
    - 'Select Baud Rate' submenu with 5 options (115200→9600, fastest to slowest)
    - Each selection saves to EEPROM, applies immediately, updates label, returns
    - PC Interface shows 'Baud Rate (115200)' with current value in brackets
    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
    [ycint.ino]
2026-07-08 Add 'Show Commands' toggle to PC Interface menu
    - New 'Show Commands (Y/N)' menu item in PC Interface submenu
    - Toggles between Y (show) and N (hide) via short-press select
    - Custom footer: '1|Yes' when N, '1|No' when Y (toggle hint)
    - When enabled: displays 'Cmd: XXXX' on rotator control screen
    - When disabled: shows normal 'Selected: XXXX' direction
    - Setting persisted to EEPROM (byte 68), default: Y (enabled)
    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
    [test_protocol.py, ycint.ino]
2026-07-08 Redesign command display: RX/TX lines on rotator screen
    - When Show Commands enabled and a command has been received:
    - Dotted divider moves up (y=32) above Az/El values
    - 'RX: <command>' line shows last received command
    - 'TX: <response>' line shows last sent response
    - Footer shows 'PC Interface Active'
    - When moving: normal 'Moving: XXXX' display unchanged
    - When idle, no commands: normal 'Selected: XXXX' display
    - Both RX and TX visible simultaneously for troubleshooting
    [ycint.ino]
2026-07-08 Add slow movement demo to test_protocol.py
    - --demo flag: slow-paced movement test (watchable on OLED)
    - Reads start position, moves one axis at a time (5° away, back)
    - Then combined movement (both axes), waits 5s, returns to start
    - 1.5s pauses between commands for OLED visibility
    - Final position verification with tolerance check
    [test_protocol.py]
2026-07-08 Redesign rotator display for RX/TX command tracking
    - Dotted divider moves up to row 32 (above Az/El values)
    - Two lines below divider show RX: <command> and TX: <response>
    - Footer changes to 'PC Interface Active'
    - Normal idle/moving modes unchanged (Selected/Moving at row 40)
    - Fix parser to handle AZEL response format (AZEL355.0.20.2.0)
    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
    [test_protocol.py, ycint.ino]
2026-07-08 Implement actual movement for AZnnn/ELnnn protocol commands
    - AZnnn: Calculate direction (shortest path with wrap-around), execute azimuth move
    - ELnnn: Calculate direction, execute elevation move
    - 1° tolerance: if within 1° of target, stop instead of moving
    - AZ wrap-around: handles crossing 0°/360° boundary correctly
    - EL clamped to 0-180°, AZ clamped to 0-360°
    [ycint.ino]
2026-07-08 Add protocol target tracking with auto-stop
    - AZnnn/ELnnn commands set protocol target flags
    - Main loop checks if target is reached (1° tolerance) and stops
    - AZ wrap-around handled in auto-stop check
    - Clear target flags when movement completes
    - Fix RX/TX display font size (small instead of large)
    [ycint.ino]
2026-07-08 Improve RX/TX command display layout
    - Remove 'PC Interface Active' footer - always show button actions
    - Move dotted separator down to y=38 (breathing room below El text)
    - Move RX line to y=40, TX line to y=51
    - Any button press clears protocol display and returns to button mode
2026-07-08 Fix Selected/Moving text font size on rotator screen
    - Added display.setTextSize(1) before 'Moving:' and 'Selected:' text
    - Prevents inheriting large font (size 2) from Az/El values above
    [ycint.ino]
2026-07-08 Fix protocol auto-stop timing and font size
    - Move auto-stop check after readPositions() so it uses fresh position data
    - Add display.setTextSize(1) before 'Moving:' and 'Selected:' text to prevent inheriting large font from Az/El values
    - Auto-stop now works correctly within 1° tolerance
    [ycint.ino]
2026-07-08 Hide button footer when in PC interface RX/TX mode
    - Button actions footer (1.Cycle 2!Go) only shown when NOT displaying RX/TX
    - Footer reappears when user presses any button (clears protocol display)
    - Provides cleaner display during serial interface control
2026-07-08 Add direction reversal safeguard and fix wrap-around rotation
    - Add configurable reverse delay (0-3s, default 1s) under PC Interface menu
    - Prevent instant direction reversal: stop → delay → start new direction
    - Fix AZ wrap-around: from 180-360° to <180° must rotate CW through 360/0
    - Fix AZ wrap-around: from 0-179° to ≥180° must rotate CCW through 0
    - Reduce UPDATE_INTERVAL from 400ms to 200ms for faster auto-stop
    - Update test_heading.py with active polling during movement
    - Auto-stop only fires when NOT in reversal delay state
    [test_heading.py, ycint.ino]
2026-07-08 Fix button response when clearing protocol display
    - Force immediate display update when Btn1 clears RX/TX protocol display
    - User now sees button mode footer appear instantly
    - Conditional clearing only when protocol display is active
    - Prevents first button press from appearing unresponsive
    [ycint.ino]
2026-07-08 Add quick button test script (test_btn.py)
    - Reads current position, moves Azimuth +5°
    - Waits for movement to complete
    - Minimal script for quick button functionality testing
2026-07-08 Fix protocol display clear to reset movement state
    - When Btn1 clears protocol display, also reset currentMove to IDLE
    - Ensures display shows 'Selected: IDLE' instead of stale 'Moving: RIGHT'
    - Only resets if motors are actually stopped (safety check)
    [ycint.ino]
2026-07-08 Fix direction constraint to override shortest-path calculation
    - Physical constraint (cannot rotate CCW past 180°) now takes
    precedence over shortest-path diff calculation
    - From 0-179° to ≥180°: always rotates CCW through 0°
    - From 180-360° to <180°: always rotates CW through 360/0°
    - Verified: 178°→183° now correctly goes CCW through 0°
    [ycint.ino]
2026-07-08 Add direction reversal safeguard test
    - test_reversal.py: sends movement command, then reversal after 3s
    - Verifies motor stops, waits delay, then starts new direction
    - Confirms 1s default delay is honored before reversal
    [test_btn.py, test_reversal.py]
2026-07-08 Add rotator variant-aware direction constraints for protocol movement
    - Physical stop angle now varies by variant:
    - N360: 180° (cannot rotate CCW past 180°)
    - S360: 0° (cannot rotate CCW past 0°/360°)
    - N450: 270° (cannot rotate CCW past 270°)
    - S450: 0° (cannot rotate CCW past 0°/450°)
    - Switch statement selects physical stop based on rotModel
    - Constraint logic uses physical stop instead of hardcoded 180°
2026-07-08 Fix N450/S450 physical stop angles
    - N450: Center=0°, ±225° travel → CCW stop at 135° (-225° from North)
    - S450: Center=180°, ±225° travel → CCW stop at 315° (180°-225°=-45°=315°)
    - Updated comments to clarify center position and travel range
    [ycint.ino]
2026-07-08 Track last direction of travel for N450/S450 overlap zone logic
    - Added lastAzDirection/lastElDirection to remember direction when
    motor stops (preserved in stopAzimuth/stopElevation)
    - For N450/S450: if target is reachable via both CW and CCW (within
    225° travel), use last direction to determine valid path
    - Corrected physical stop angles: N450=135°, S450=315°
    - Prevents hitting mechanical limit when taking shortest path in
    overlap zone
    [ycint.ino]
2026-07-08 Track mechanical offset from center for N450/S450 direction calculation
    - Added mechanicalAzOffset variable to track signed offset from center
    - CW movement increases offset, CCW decreases offset
    - Updated direction constraint logic to use mechanical offset for overlap zone
    - Handles compass heading wrap-around correctly
    - Clamps offset to mechanical limits (-225° to +225° for N450/S450)
    [ycint.ino]
2026-07-08 Add N360 180° edge case test
    - test_180_edge.py: tests long-path rotation around 180° physical stop
    - Verifies rotator takes correct path when short path is blocked
    - Tests both CW and CCW long-path scenarios
    - All 5 test steps passed with <1.5° accuracy
    [test_180_edge.py]
2026-07-11 Add GS-232B C2/C3 command support
    - C2: Current position with status (azimuth, elevation, rate, status)
    - C3: Current position with full status (azimuth, elevation, rate, status, error)
    - Fixes satellite tracking software receiving ERR for C2 commands
    - Maintains backward compatibility with bare C command
    - Compiled and uploaded successfully
    [ycint.ino]
2026-07-11 Fix C2/C3 command routing — route C/H/V multi-letter commands to GS-232 handler
    - C2 was going to Easycom handler which returned ERR
    - Added C, H, V to GS-232 multi-letter command routing
    - All C command family now works: C, C1, C2, C3 (case-insensitive)
    [test_c2.py, ycint.ino]
2026-07-11 Fix C2 response format and line ending for GS-232B compatibility
    - C2 now returns: C<az>.<el>.<rate>.<status> (was extra .0)
    - Changed Serial.println() to Serial.print()+CR (GS-232B expects CR only)
    - Removes spurious LF byte that satellite software was seeing
    [ycint.ino]
2026-07-11 Fix C command response format with zero-padded values
    - Changed to %04.1f for azimuth (nnn.n format)
    - Changed to %03.1f for elevation (nn.n format)
    - Uses snprintf instead of String concatenation
    - Response: C000.6.018.2.0.0 (was C0.6.18.2.0.0)
    [test_c2_raw.py, ycint.ino]
2026-07-11 Fix GS-232B C2 response format to match Hamlib standard
    - C2 now returns 'AZ=aaa EL=eee' (Hamlib parse format)
    - C1 returns 'AZ=aaa EL=eee RATE=00.0'
    - C3 returns 'AZ=aaa EL=eee STATUS=0'
    - Bare C returns 'Caaa.ee' (GS-232A format)
    - Verified working with MacDoppler satellite tracking software
    [ycint.ino]
2026-07-11 Add axis-specific stop commands E and Z
    - E: Stop elevation only
    - Z: Stop azimuth only
    - A: Stop all (both axes)
    - S: Stop all (both axes)
    - stopAll() also clears protocol target flags to prevent auto-restart
    [ycint.ino]
2026-07-11 Clear protocol flags in stopAzimuth/stopElevation
    - E and Z commands now also prevent auto-stop restart
    - All stop commands (A, S, E, Z) are consistent
    [ycint.ino]
2026-07-11 Add Mnnn and Wnnn nnn GS-232B positioning commands
    - Mnnn: Move azimuth to heading (000-359)
    - Wnnn nnn: Move to azimuth/elevation position
    - Hnnn: Also supports setting heading (not just querying)
    - Extracted shared executeProtocolAzMove/ElMove helpers
    - All commands reuse direction reversal safeguards and variant constraints
    [ycint.ino]
2026-07-11 Fix GS-232B line ending and M command routing
    - Changed line ending from CR to CRLF for compatibility
    - Added M and W commands to GS-232 routing list
    - Auto-stop logic should now work correctly with M command
    [ycint.ino]
2026-07-11 Add auto-stop logic that runs even in menu mode
    - Moved auto-stop check outside menu/rotator mode branches
    - Now stops at target regardless of current UI state
    - Fixes overshooting issue with M and W commands
    [ycint.ino]
2026-07-11 Fix GS-232B protocol issues for Rotor software
    - Revert line ending to CR only (\r) instead of CRLF
    Rotor software reads buffer twice with CRLF, causing parse failure
    - Add readPositions() call in auto-stop loop
    Ensures currentAz/currentEl are updated even in menu mode
    Fixes overshooting issue with M and W commands
    [ycint.ino]
2026-07-11 Fix auto-stop: stopAzimuth() was clearing protocolTargetAzSet
    Root cause: executeProtocolAzMove() sets protocolTargetAzSet=true,
    then calls executeAzimuthMove() which calls stopAzimuth().
    stopAzimuth() was clearing protocolTargetAzSet=false immediately,
    so the auto-stop loop never saw the flag set.
    Fix:
    - Remove protocolTargetAzSet/El clearing from stopAzimuth()/stopElevation()
    - These flags are now only cleared by auto-stop loop and explicit stop commands
    - Add cross-target detection: stop when direction + diff indicates target passed
    - CW: stop when diff <= 0 (current >= target)
    - CCW: stop when diff >= 0 (current <= target)
    - Also stop when within 1.0° tolerance
    Result: M060 from 30°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
    [test_auto_stop.py, ycint.ino]
2026-07-12 Fix auto-stop: stopAzimuth() was clearing protocolTargetAzSet flag
    Root cause: executeProtocolAzMove() set protocolTargetAzSet=true, then
    called executeAzimuthMove() which called stopAzimuth(). That function
    was immediately clearing protocolTargetAzSet=false, so the auto-stop
    loop never saw the flag set.
    - Removed protocolTargetAzSet/El clearing from stopAzimuth()/stopElevation()
    These flags are now only cleared by the auto-stop loop itself and
    explicit stop commands (A, E, S).
    - Implemented cross-target detection: when moving CW, stop when current >= target;
    when moving CCW, stop when current <= target. This catches overshoot cases
    where the ADC sampling interval skips over th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
    [ycint.ino]
2026-07-12 Add protocol variant selection menu with EEPROM persistence
    Feature: Users can now select their PC interface protocol variant
    via the PC Interface menu screen.
    Changes:
    1. Added ProtocolVariant enum (GS-232A, GS-232B, Easycom) with
    EEPROM storage at byte 71 for persistence across power cycles
    2. Created Protocol submenu under PC Interface with 3 selectable
    options, defaulting to GS-232A (Yaesu format)
    3. Added setParent() method to Menu class for proper submenu
    navigation back to parent menu
    4. Refactored C1/C2/C3 response formatting to use protocol-specific
    formatPositionResponse() function:
    - GS-232A: +nnnn+nnnn [suffix]
    - GS-232B: AZ=nnn EL=nnn [suffix]
    - Easycom: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
2026-07-12 Disable debug output for production build
    - Set DEBUG_ENABLED to 0 (no serial debug prints)
    - Keep DEBUG_PROTOCOL and DEBUG_MOVEMENT flags for future use
    - Updated debug trace labels in executeProtocolAzMove
2026-07-12 GS-232B protocol support and EEPROM init fix
    - Use protocol-specific line endings: LF for GS-232A, CRLF for GS-232B
    (matching hamlib REPLY_EOM definitions)
    - protocolSend() now uses getProtocolLineEnding() dynamically
    - GS-232B position format: AZ=nnn EL=nnn (single space, matches Rotor client)
    - Fix EEPROM.begin() called before loadProtocolSettings() so saved
    protocol variant persists across reboots
    [ycint.ino]
2026-07-12 Elevation limit protection with hysteresis
    - Require 3 consecutive stalled readings before auto-stop (was 1)
    to give rotator time to accelerate after command
    - Move protection outside protocolTargetElSet gate so bare D/U
    commands are also protected
    - Reset stall count on any movement > 0.5°
    [ycint.ino]
2026-07-12 Full Easycom protocol support (hamlib-compatible)
    - Rewrote processEasycomCommand for hamlib Easycomm standard:
    AZ/EL query and set, ML/MR/MU/MD directional moves,
    SA/SE axis stops, S all stop, VE version, GS status
    - Added EasyComm 3 velocity commands (VL/VR/VU/VD)
    - Acknowledge radio control commands (UP/DN/DM/UM/DR/UR)
    - Line ending: LF only (\n) matching hamlib REPLY_EOM
    - Fixed token parsing: single-char commands now supported (S)
    - Added parseFloat helper for float position values
    - Include test_easycom.py test suite
    [test_easycom.py, ycint.ino]
2026-07-12 Clear movement arrows on OLED when axis stops
    - stopAzimuth(): clear currentMove if AZ was moving
    - stopElevation(): clear currentMove if EL was moving
    - Arrows now disappear immediately when movement stops via any path
2026-07-12 Add TCP server on port 4533 for network protocol access
    - WiFiServer on port 4533 (hamlib rotctld default)
    - Accepts one client at a time; auto-reverts to Serial on disconnect
    - Responses sent to both Serial and TCP simultaneously
    - MDNS advertised as azelctrl.local for discovery
    - 2x2 filled pixel indicator in top-right OLED when TCP connected
    - Refactored protocol parsing into processProtocolChar() for reuse
    - TCP server starts on WiFi connect (STA/AP), stops on disable
    [ycint.ino]
2026-07-12 Fix WiFi connection display and crash loop
    - Show IP address on all WiFi connection paths (boot, menu, station settings)
    - Replace drawQuickNotice with full-screen display showing IP, signal, quality
    - 5-second countdown with button-skip on connected screen
    - Boot auto-connect: show progress and IP before proceeding to rotator control
    - Skip reconnection if already connected (fixes duplicate connect on boot skip)
    - Add 'Show IP' menu item to WiFi Connect submenu
    - Remove MDNS (was causing crash/reboot loop)
    - Add guard flag to prevent double TCP server init
    [ycint.ino]
2026-07-12 Improve AzEl screen navigation and WiFi connection display
    AzEl screen:
    - Rename IDLE to SETUP as first menu item
    - Remove AZ POT/EL POT entries (calibration accessed from Setup menu)
    - Long-press Btn2 on SETUP → go to Setup menu
    - Hold Btn1 + long-press Btn2 on SETUP → reboot device
    - Footer shows appropriate actions per selection (2!Go, 1+2!|RST)
    - Back from Setup returns directly to AzEl (not boot menu)
    WiFi connection screens:
    - Show IP address on all connection paths (boot, menu, station settings)
    - Countdown is now just a digit in bottom-right corner
    - Station Settings shows IP when connected, masked password when not
    [ycint.ino]
2026-07-14 Add Default Protocol support over TCP port 4533
    TCP connections now speak Hamlib Default Protocol instead of raw GS-232:
    - p → Get position (returns az\nel\n)
    - P az el → Set position
    - S → Stop rotation
    - s → Get status
    - M dir [speed] → Move (LEFT/RIGHT/UP/DOWN/CW/CCW)
    - _ → Get version/info
    - K → Park (maps to stop)
    - R n → Reset
    - v/V ROT_LEVEL_ROT_SPEED → Get/set velocity
    - Responses: RPRT 0 for success, RPRT -N for errors
    Serial interface unchanged (GS-232A/B/Easycom via menu)
    Matches hamlib rotctld architecture exactly
    [ycint.ino]
2026-07-14 Fix Default Protocol P command auto-stop
    Set protocol targets (protocolTargetAz/El, protocolTargetAz/ElSet)
    so the main loop auto-stop logic stops the rotator at the target
    position instead of running past it to hardware limits.
    [ycint.ino]
2026-07-14 Move TCP connected indicator below movement arrows
    Relocate the 2x2 TCP connection dot from top-right (y=0) to
    above the footer dotted line (y=49). This prevents it from
    overlapping with the azimuth movement arrow at y=5-6.
    [ycint.ino]
2026-07-14 Fix movement arrows when both axes move simultaneously
    Draw azimuth/elevation arrows based on azDirection/elDirection
    instead of the single currentMove string, which can only hold
    one direction at a time.
    [ycint.ino]
2026-07-14 Fix cardinal heading names during calibration return sweep
    E/W (and NE/NW, SE/SW) were swapped. Now correctly maps:
    +90°=E, -90°=W, +45°=NE, -45°=NW, +135°=SE, -135°=SW
    [ycint.ino]
2026-07-14 Extend cardinal headings for N450/S450 calibration return sweep
    Added +270°(W) and +225°(SW) headings to cover full N450/S450 range.
    Now correctly shows all cardinal points during CCW return sweep.
    [ycint.ino]
2026-07-14 Fix calibration cardinal headings for all rotator variants
    - Convert mechanical offset to compass heading (0-360°) before lookup
    - Handle wrap-around at N(0°) during CCW return sweep
    - N360/S360: S→SE→E→NE→N→NW→W→SW→S
    - N450/S450: SW→S→SE→E→NE→N→NW→W→SW→S→SE
    [ycint.ino]
2026-07-14 Fix AzEl button handling: only SETUP responds to Btn2 long-press
    Long-press Btn2 was incorrectly triggering for all menu selections,
    causing motors to stop after 1s and navigating to Setup. Now only
    SETUP selection triggers long-press actions. Direction selections
    use momentary Btn2 (press=start, release=stop) as before.
    [ycint.ino]
2026-07-14 Fix EEPROM backward compatibility after adding network settings
    Rotator model moved from bytes 86-87 to 88-89 to make room for
    network settings. Load/save now handles migration from old location
    to new on first boot, preserving existing calibration and WiFi data.
    [ycint.ino]
2026-07-14 Fix Setup menu: show 'Network' instead of 'Wifi(Station)'
    updateSetupLabels() was overwriting the static 'Network' label with
    WiFi status string on every draw. WiFi mode detail is now only shown
    inside the Network submenu where it belongs.
    [ycint.ino]
2026-07-15 Fix EEPROM persistence: use full 512-byte flash sector
    Root cause: EEPROM_SIZE was defined as 67 (WiFi credentials only)
    before the calibration data at bytes 67+. ESP8266's EEPROM library
    only loads the requested size into RAM on begin(), so when WiFi
    credentials were saved via commit(), the entire flash sector was
    rewritten but calibration data was never in the buffer — it got
    erased.
    Fix: Use EEPROM.begin(512) to load the complete flash sector into
    RAM. All independent save operations now work against the same
    buffer, and every commit writes all data atomically.
    - Unified EEPROM layout at top of file (bytes 0-89 used)
    - Removed duplicate/redundant definitions
    - Removed backward-compat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
    [test_m164_from_270.py, watch_boot.py, ycint.ino]
2026-07-15 Add Skip calibration option and fix EEPROM persistence
    - Add 'Skip (Az=El=3.2V)' to Voltage Calibration menu for users
    who have pre-trimmed pots to 3.2V max — sets calAzMinV=0,
    calAzMaxV=3.2, calElMinV=0, calElMaxV=3.2 and saves directly
    to EEPROM, returning to Setup screen
    - Fix EEPROM persistence: use EEPROM.begin(512) to load full flash
    sector into RAM buffer, preventing WiFi credential saves from
    corrupting adjacent calibration data
    - Remove duplicate/redundant EEPROM definitions
    - Remove backward-compat migration code
    [ycint.ino]
2026-07-15 Fix motor control for Gpredict compatibility
    - Conditional motor stop: only disengage motors when changing direction,
    not when idle or already moving in same direction. Prevents unnecessary
    stop/restart cycle that caused mechanical backlash and backward drift
    in position readings.
    - Motor engagement delay (200ms): during motor ramp-up, position queries
    return last known good position instead of potentially stale ADC values.
    Prevents clients from seeing backward drift during engagement.
    - Engagement timers cleared on motor stop via stopAzimuth()/stopElevation().
    - Comma-to-period replacement in TCP protocol args for locale handling.
    - Minor debug log cleanup (removed redundant D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
    [ycint.ino]
2026-07-15 Add GS-232 command detection for TCP protocol
    Auto-detect GS-232 vs rotctl commands on TCP connections. Clients like
    Rotor send raw GS-232 commands (C, Wnnn nnn, H, etc.) over TCP instead
    of rotctl text protocol (p, P az el). The isGs232Command() heuristic
    routes GS-232 commands to processGs232Command() and falls through to
    the rotctl handler for lowercase/rotctl-specific commands.
2026-07-15 Route TCP protocol by Hamlib Server setting instead of guessing
    - Always listen on port 4533 regardless of Hamlib Server setting
    - When Hamlib Server = Y: speak rotctl text protocol (Gpredict)
    - When Hamlib Server = N: speak configured serial protocol over TCP
    (GS-232A/B/Easycom from PC Interface > Protocol selection)
    - Removed isGs232Command() heuristic — protocol is now explicitly chosen
    - actionToggleHamlibServer no longer stops TCP server, just switches protocol
    [ycint.ino]
2026-07-15 TCP always speaks rotctl text protocol
    Clients like Rotor connect via TCP expecting rotctld-style protocol (p/P/S).
    The Hamlib Server setting no longer affects TCP — it always speaks rotctl.
    GS-232A/B/Easycom selection under PC Interface only applies to serial.
    [ycint.ino]
2026-07-15 Revert TCP response experiments, restore standard protocol routing
    After testing raw numeric, AZ=value, and C2 format responses for C
    command over TCP, none worked for Rotor heading display. Revert to
    standard serial protocol responses (Caaa.ee) which do correctly report
    changing azimuth values.
    [ycint.ino]
2026-07-18 Add ELF (Elevation Flip / Over-the-top) mode
    Implements the over-the-top satellite tracking technique from
    satellite_over_the_top.docx. When enabled, transforms incoming
    satellite coordinates to physical rotator coordinates:
    Real Az = (Sat Az + 180) % 360
    Real El = 180 - Sat El
    User controls:
    - Cycle Btn1 to 'ELF' on AzEl screen, long-press Btn2 to toggle
    - Footer shows '2!On' (off->on) or '2!Off' (on->off)
    - OLED shows 'ELF' indicator right-aligned when active
    - Mode persists in EEPROM byte 90
    Transforms applied to:
    - rotctl position query (p) and set position (P)
    - GS-232 C and H commands
    - OLED Az/El display values
    [ycint.ino]
2026-07-18 Fix ELF direction bugs in protocol 'P' command and manual buttons
    Bug fix for rotctl 'P' (set position):
    - Calculate direction BEFORE transforming target coords to physical space
    - Transform currentAz/currentEl to satellite space for comparison
    - This ensures shortest-path direction is correct when ELF is on
    Bug fix for manual UP/DOWN buttons:
    - When ELF is on, physical UP decreases satellite El (Real El = 180 - Sat El)
    - Swap UP/DOWN button actions when elfMode is active
    [ycint.ino]
2026-07-18 Fix button suppress timer indentation and improve implementation
    - Fixed broken indentation from resetOledCmdSuppress() insertions
    - Added 5-second OLED RX/TX overlay suppression after button presses
    - Client polling continues normally, only display is suppressed
    [ycint.ino]
2026-07-18 Fix ELF azimuth direction in executeProtocolAzMove/ElMove
    Root cause: executeProtocolAzMove compared satellite-space targets
    against displayAzimuth(currentAz) which applies model offset, mixing
    two different coordinate spaces and producing wrong direction.
    When ELF is on:
    - Transform target to physical coords for protocolTargetAz tracking
    - Calculate direction by comparing both current and target in
    satellite space (elfAz(currentAz) vs targetAz)
    - Transform physical stop boundary to satellite space for crossing check
    - Use physTarget for N450/S450 mechanical offset logic
    Same fix applied to executeProtocolElMove.
    [ycint.ino]
2026-07-18 Fix Btn1 cycling blocked by protocol command clear logic
    When protocolLastCommand has data (from continuous polling), Btn1
    pressed once just cleared the buffer and returned without cycling.
    The suppress timer prevents the overlay from showing but did not
    prevent the clear-PC-mode path from consuming the button press.
    Now checks the suppress timer: only clear PC mode if overlay would
    actually be shown. During suppression, Btn1 cycles normally.
    [ycint.ino]
2026-07-18 Fix ELF elevation direction in executeProtocolElMove
    When ELF is on, satellite-space UP means physical DOWN (Real El = 180 - Sat El).
    executeProtocolElMove calculated direction correctly in satellite space but
    then passed the satellite direction directly to executeElevationMove which
    expects physical direction — causing the motor to move backwards.
    Now converts satellite-space direction to physical direction:
    - diff > 0 (satellite UP) → physical DOWN when ELF on
    - diff < 0 (satellite DOWN) → physical UP when ELF on
    [ycint.ino]
2026-07-18 Fix U/D commands in ELF mode
    GS-232 U/D commands always moved physical UP/DOWN regardless of ELF mode.
    When ELF is on, satellite UP = physical DOWN (Real El = 180 - Sat El),
    so U/D are swapped to match effective satellite direction.
    [ycint.ino]
2026-07-18 Add 'Elevate To?' prompt when ELF mode is toggled
    When user enables or disables ELF mode via long-press Btn2 on the
    ELF menu item, a modal overlay appears with options:
    - Horizon (0) — default, auto-selected after 5s timeout
    - 45 degrees
    - 90 degrees
    - Skip — leave elevation unchanged
    Btn1 cycles through options (resets timeout), Btn2 selects.
    Selected elevation is passed to executeProtocolElMove as an
    effective satellite-space target, consistent with all other ELF
    movement commands.
    Also removes duplicate ELF toggle block that existed in the code.
    [ycint.ino]
2026-07-18 Skip updateRotatorDisplay when ELF elevation prompt is active
    The periodic display refresh was redrawing the normal menu every 200ms,
    then drawElfElevPrompt overwrote it — causing rapid flicker. Now the
    normal display is skipped entirely while the prompt overlay is shown.
    [ycint.ino]
2026-07-18 Replace ELF elevation prompt with blocking overlay matching Rotator Variant style
    The previous non-blocking prompt flickered because updateRotatorDisplay()
    redrew every 200ms while drawElfElevPrompt() overwrote it each cycle.
    Now uses a blocking while(true) loop identical to selectRotatorVariant:
    - Title bar: 'Elevate To?' (white on black, same header style)
    - Options: Horizon (0), 45, 90, Skip (inverted selection highlight)
    - Btn1 short = cycle, Btn1 long = select, Btn2 = back/skip
    - Auto-selects Horizon (0) after 5 seconds if no interaction
    - Footer: '1.Nav 1|Sel 2.Back' (same as rotator variant screen)
    Removed unused elfElevPromptActive globals and display overlay guard.
    [ycint.ino]
2026-07-18 Fix ELF elevation prompt: auto-select only on timeout, add countdown
    - Auto-select Horizon(0) only fires if user has NOT pressed Btn1 at all.
    Cycling through options sets userInteracted=true, preventing auto-select.
    Timeout resets on each Btn1 press.
    - Added [x] countdown indicator in footer (5→0) showing remaining seconds
    before auto-selection.
    [ycint.ino]
2026-07-18 Move ELF elevation countdown next to first menu item
    Countdown [x] was overlapping '2.Back' in the footer. Now displayed
    inline with the first option: 'Horizon (0) [5]' counting down to [0].
    Disappears immediately when user presses any button (userInteracted flag).
2026-07-18 Reset text color before footer in ELF elevation prompt
    When 'Skip' (last item) was selected, the BLACK-on-WHITE inverted color
    carried over to the footer text. Now resets to WHITE before drawing
    the footer.
    [ycint.ino]
2026-07-18 Fix Gpredict integration: protocol framing, azimuth range, and negative azimuth handling
    - Batch position response into single TCP packet (azimuth\nelevation\nRPRT 0\n)
    to match Gpredict's single recv() expectation — fixes 'bad response' errors
    and connection disengagement.
    - Respond with -180..+180° azimuth when Hamlib Server enabled to match
    Gpredict's AzType=1 configuration.
    - Convert negative incoming azimuths to 0..360° internally instead of
    clamping to 0, preserving existing direction-finding, mechanical-stop,
    and ELF logic. Fixes wrong-direction rotation when targets cross the
    -180/+180 boundary.
    [ycint.ino]
2026-07-18 Increase auto-stop tolerance to 3.0° to prevent azimuth oscillation
    Mechanical inertia causes motor to overshoot target after power cut.
    Previous 1.0° tolerance was too tight given 100ms position update rate,
    resulting in ±3-5° oscillation during Gpredict tracking.
    New 3.0° tolerance stops motor early enough to avoid oscillation while
    maintaining acceptable tracking accuracy.
    [ycint.ino]
2026-07-18 Update parts list with Communica SKUs and pricing
    Replaced generic parts list with specific Communica parts and ZAR pricing:
    - Required parts subtotal: R376
    - Optional items (spacers, cable): ~R24
    - Estimated total: ~R400
2026-07-18 Add ribbon jumper cable to parts list
    Added item 8: BMT Ribbon Jumper 40W F/F 15cm (R23)
    Updated subtotal to R399 and estimated total to ~R425
2026-07-18 Add ribbon cable connection section and update part numbering
    Added section 7.5 explaining how to connect the 40-way ribbon jumper
    cable between ESP8266 and motor shield with pin mapping table.
    Renumbered subsequent sections:
    - Wiring the Buttons: 7.5 → 7.6
    - Wiring the I2C Bus: 7.6 → 7.7
    - Wiring the Yaesu DIN-8: 7.7 → 7.8
2026-07-18 Clarify ribbon jumper cable usage: strip apart, solder where practical
    Rewrote section 7.5 to explain that the ribbon cable is NOT used as a
    single ribbon, but stripped apart for individual connections:
    - Use connector end for motor shield GPIO headers
    - Cut and solder other end for ADS1115 (don't solder headers to board)
    - Make I2C Y-splitter cables from ribbon wires
    - Soldering preferred over connectors for vibration resistance
2026-07-18 Balance USB serial and TCP/IP coverage throughout product guide
    Major updates to better represent both communication interfaces:
    - Section 3.1: Added two architecture diagrams (USB serial and TCP/IP)
    with guidance on when to use each
    - Section 3.2: Rewrote data flow to cover both USB serial and TCP/IP
    - Section 4.5: Expanded to "Communication Interfaces and Protocol Stack"
    with dedicated USB Serial section (COM port, baud rate, use cases)
    - Section 8.4: Added USB Serial Connection subsection with OS-specific
    port detection, updated Gpredict and Rotor sections to show both
    USB and TCP/IP setup steps, added "Other Tracking Software" subsection
    - Section 2.2: Updated benefits to mentio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
2026-07-18 Fix architecture diagrams: USB cable arrows now point to AZELCtrl
    Corrected both Option 1 and Option 2 diagrams so the USB cable label
    and arrow point to the AZELCtrl device, not the tracking software box.
2026-07-18 Fix menu documentation to match actual SETUP menu structure
    Replaced incorrect 'Rotator Settings Screen' section with accurate
    description of the SETUP menu hierarchy:
    - SETUP menu: Rot Variant, Rot Calibrate, Network, PC Interface, Wipe all
    - Network submenu: Wifi config, Hamlib Server toggle
    - PC Interface submenu: Baud Rate, Show Commands, Reverse Delay, Protocol
    - ELF mode: toggled from main screen (cycle to ELF + long-press Btn2),
    not from a settings menu
    Updated section 8.5 navigation paths to match actual menu structure.
2026-07-18 Comprehensive screen documentation update to match current firmware
    Verified all screen descriptions against actual firmware code and fixed:
    Section 6.1: Updated button behavior tables for rotator control and menu modes
    Section 6.2: Replaced old WiFi-only startup screens with actual flow:
    - Splash screen (AZELCtrl, version, date, author)
    - Missing Settings notice (when mandatory items incomplete)
    - Boot menu (Rotator Ctrl with 3s countdown, Setup)
    - WiFi connecting/connected/failed screens with actual layout
    Section 6.3: Rewrote main Az/El control screen:
    - Large Az/El values with movement arrows (→←↑↓)
    - Sel line showing SETUP/LEFT/RIGHT/UP/DOWN/ELF
    - ELF indicator on right side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
2026-07-18 Add OLED orientation warning in section 7.4
    Note that pin headers must be on top — mounting upside down causes
    upside-down text display.
2026-07-18 Add heat-shrink recommendation for I2C splitter cables in section 7.7
    Recommend sliding heat-shrink tubing over solder joints on OLED
    header pins to prevent shorts. Note to leave extra wire length
    when making splitters so heat-shrink fits.
2026-07-18 Add I2C bus explanation in section 7.7 for less technical readers
    Explain that I2C uses two shared wires (SDA/SCL), each device has
    a unique address, so connecting OLED and ADS1115 'in parallel' is
    perfectly fine and they won't interfere with each other.
2026-07-18 Add practical wiring tips for DIN-8 connector in section 7.8
    - Wire DIN cable before installing motor shield in enclosure
    (easier access to terminal screws, especially in tight boxes)
    - Keep DIN plug disconnected from Yaesu controller during wiring
    - Verify all connections with multimeter before plugging in
2026-07-18 Update potentiometer calibration section 7.10 with critical cable length warning
    - Made rotating azimuth to limit the first step (logical order)
    - Added prerequisite: Yaesu-to-rotator cable must already be installed
    - Added CRITICAL WARNING: recalibrate trim pots after any cable length
    change — shortening cable increases voltage and can destroy ADS1115
2026-07-18 Change trim pot calibration target voltage to 3.2V in section 7.10
    Steps 4 and 8 now specify 3.2V instead of 3.3V for azimuth and
    elevation trim pot adjustment.
2026-07-18 Add captive portal WiFi setup section and fix firmware installation docs
    - Removed incorrect step 5 from section 7.11 (no hardcoded WiFi in source)
    - Added new section 7.12: Configuring WiFi via Captive Portal
    Explains the full process:
    - SETUP → Network → Set WiFi Creds starts open AP 'AZELCTRL'
    - User connects phone/laptop to AZELCTRL AP
    - Browser opens setup page at 192.168.4.1
    - User enters home WiFi SSID/password, saves, device reboots
    - Renumbered subsequent sections (Operating the Device → 8, etc.)
2026-07-18 Add macOS Rotor limitation note in section 8.4
    Note that Rotor works via USB serial but TCP/IP interface lacks
    elevation control, so not viable for satellite tracking with
    azimuth-elevation rotators.
2026-07-18 Update section 3.1 diagrams: clarify single DIN-8 cable carries all signals
    - Removed misleading separate 'Motor relays' and 'Position pots' labels
    - Added '(single 8-wire cable, DIN-8 plug)' annotation to both diagrams
    - Added pinout table showing all 8 DIN pins and their AZELCtrl connections
    - Added clarifying text: no separate cables for motor or position sensing
2026-07-19 Update AZELCtrl Product Guide section 3.1 diagrams
    - Redrew system architecture diagrams for both USB and WiFi options
    - Moved Satellite Tracking Software block above AZELCtrl for more horizontal space
    - Showed Yaesu DIN-8 cable entering AZELCtrl and splitting to Motor Shield and ADS1115
    - Added Rotator (antenna) block mechanically connected to Yaesu controller
    - Added WiFi AP block to WiFi/TCP diagram
2026-07-19 Fix section 6.2 Startup Screens to match actual firmware behavior
    - Added Splash Screen (3s with version info)
    - Added Missing Settings notice (3s, then direct to SETUP)
    - Added Boot Menu (Rotator Ctrl with 3s auto-select, Setup)
    - Fixed WiFi Connecting screen layout and 15s timeout
    - Fixed WiFi Connected screen: 5s countdown in corner, any button to skip
    - Fixed WiFi Failed screen: 2s display, then proceeds automatically
    - Now consistent with section 8.1 Power-Up Sequence
2026-07-19 Completely rewrite section 6.4 SETUP Menu to match actual firmware
    Issues fixed:
    - Network submenu: was incorrectly described as WiFi config menu; now correctly
    shows it opens WiFi Mode submenu (Station, Access Point, Disable)
    - Added missing WiFi Mode Submenu with all three options
    - Added missing Station Settings screen (Set via HTTP, Connect, SSID/IP display)
    - Added missing AP Mode menu (Rotator Control, AP Status, Retry Home WiFi, Calibrate Pots)
    - Added Rotator Variant Selection Screen with model ranges and wrap boundaries
    - Added Voltage Calibration Menu items (Azimuth, Elevation, Skip)
    - Added Baud Rate Selection submenu
    - Added Protocol Selection submenu with labels (Yaesu, Hamlib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
2026-07-19 Fix section 6.3 Main Az/El Control Screen to match actual firmware
    - Removed fake title bar 'Azimuth/Elevation' — screen has no title bar
    - Fixed 'Move: RIGHT' to 'Moving: RIGHT' (shown only when active)
    - Fixed footer format: '1.Cycle 2!Go' not '1.Nav 1|Sel 2.Back'
    - Added movement arrows on Az/El lines (→/← for azimuth, ↑/↓ for elevation)
    - Added TCP connection indicator (dot in top-right corner)
    - Added SAFETY PAUSE screen description
    - Added variable footer text (SETUP shows 1+2!|RST, ELF shows On/Off)
    - Fixed ELF indicator position (right-aligned on Sel: line)
    - Clarified RX/TX overlay behavior with 5s button suppression
    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
2026-07-19 Fix rotator variant naming and ranges in doc and code
    Documentation fixes (section 6.4 Rotator Variant Selection Screen):
    - Added explanation of model naming: N/S = center direction, 360/450 = total span
    - Fixed Typical Use: N models are for Southern Hemisphere, S models for Northern Hemisphere (was swapped)
    - Fixed N450 range: -225 to +225 (was -180 to 270)
    - Fixed S450 range: -45 to +405 (was 0 to 450)
    - Also fixed section 4.6 Rotator Model Variants table (Typical Use was swapped)
    Code fix (setupRotatorModel):
    - Updated modelLabels to show correct ranges:
    N450: (-225 to 225), S450: (-45 to 405)
    [ycint.ino]
2026-07-19 Add dotted separator line above footer in all menu screen diagrams
    The device shows a dotted line above the footer text on every menu screen.
    Added this to all menu diagrams in the documentation to match the actual display.
2026-07-19 Update AP Mode menu and add configurable AP password
    AP Mode menu changes:
    - Removed 'Retry Home WiFi' option
    - Removed 'Calibrate Pots' option (accessible from other menus)
    - Added 'Regen AP Password' option
    AP Password feature:
    - Default password remains 'yaesu'
    - User can generate a new random 5-digit password
    - Password stored in EEPROM (bytes 91-96)
    - Password used by WiFi.softAP() and shown in AP Status screen
    - Regen process: shows 'Generating...', user presses Btn1 for timing entropy,
    new password displayed, user acknowledges with Btn1
    Code changes:
    - AP_PASS constant replaced by apPassword char array
    - Added loadApPassword()/saveApPassword() EEPROM functions
    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
    [ycint.ino]
2026-07-19 Fix AP Mode menu: enable Back button and remove Rotator Control
    - Set AP Mode menu parent to wifiModeMenu (was nullptr), so Btn2 Back now works
    - Removed 'Rotator Control' option from AP Mode menu
    - Updated documentation to reflect these changes
    [ycint.ino]
2026-07-19 Fix WiFi Mode menu Back button to go to Network menu
    Changed wifiModeMenu parent from bootMenu to networkMenu so
    Btn2 Back correctly returns to Network submenu.
    [ycint.ino]
2026-07-19 Fix AP Status screen and AP mode initialization
    - AP Status now reads actual SSID from WiFi.softAPSSID() and IP from
    WiFi.softAPIP() instead of using hardcoded values
    - Added delay and retry in startApMode() to fix softAP failing silently
    (which caused fallback to ESP-XXXXXX SSID)
    [ycint.ino]
2026-07-19 Fix AP mode not requiring password and update documentation
    - startApMode() now stops captive portal first (which was leaving an open AP running)
    - Added WiFi.disconnect() before starting AP mode
    - AP Status screen now reads actual SSID/IP from WiFi subsystem
    - Added fallback for softAPIP() returning 0.0.0.0
    - Updated documentation to clarify AP Status shows actual SSID and password
    [ycint.ino]
2026-07-19 Fix AP Status IP not displaying - drawNotice line limit issue
    The drawNotice loop condition y<54 was cutting off the 5th line.
    Removed blank line between title and content so all 4 info lines fit.
    Updated documentation to match.
    [ycint.ino]
2026-07-19 Fix AP mode showing as unsecured network
    stopCaptivePortal() was calling WiFi.mode(WIFI_OFF) which was
    interfering with the WiFi state machine and causing the AP to
    be recreated without a password. Removed that line - stopCaptivePortal()
    should only stop the DNS and HTTP servers, not change WiFi mode.
    [ycint.ino]
2026-07-19 Fix AP mode not requiring password - WPA2 minimum 8 chars required
    Root cause: ESP8266 WPA2 requires minimum 8-character password.
    'yaesu' (5 chars) and 5-digit numbers were silently rejected,
    causing ESP to fall back to open AP.
    Fixes:
    - Default password changed from 'yaesu' to 'yaesu123'
    - Password regen now generates 8-char alphanumeric passwords
    - Moved softAPConfig() before softAP() for proper init order
    - Added extra delays between WiFi state changes
    - Updated documentation with new default password and 8-char requirement
    [ycint.ino]
2026-07-19 Make AP SSID unique per device using MAC address
    AP SSID is now AZELCTRL_XXXX where XXXX is the last 4 hex digits
    of the device MAC address. This allows distinguishing multiple
    devices in the same area.
    - Added initApSsid() function that generates SSID from MAC address
    - Called initApSsid() during setup after loading WiFi settings
    - Updated documentation to reflect new SSID format
    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
2026-07-19 Add captive portal effect to AP Mode for automatic browser opening
    AP Mode now starts a DNS server that redirects all DNS queries to
    the device IP, triggering the phone's captive portal detection and
    automatically opening the browser to the web interface.
    - startApMode() now starts dnsServer for captive portal effect
    - loop() processes DNS requests when in AP Mode
    - stopApMode() now stops the DNS server
    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
2026-07-19 Fix web control buttons and improve layout
    Button fixes:
    - Added return false to event handlers to prevent default browser behavior
    - Added onmouseleave to send STOP when mouse leaves button (for desktop)
    - Added error handling to fetch calls
    - Fixed setInterval closure syntax error
    Layout fixes:
    - Increased grid columns from 70px to 90px to fit LEFT/RIGHT/STOP text
    - Reduced button padding and font size for better fit
    - Increased controls max-width to 320px
    [ycint.ino]
2026-07-19 Align Az/El decimal points on web interface
    Added monospace font and right-aligned fixed-width display for Az/El
    values so the decimal point stays in the same position regardless of
    value (like the OLED display). Values are padded to 6 characters.
    [ycint.ino]
2026-07-19 Increase font sizes on web interface for better screen utilization
    - Title: 28px
    - Info panel text: 24px
    - Buttons: 18px with larger hit areas (100x80px grid cells)
    - Increased max-widths and padding for better spacing
2026-07-19 Update documentation for recent AP Mode and web interface changes
    - AP SSID now AZELCTRL_XXXX (MAC-based) throughout docs
    - AP password is yaesu123 (8 chars for WPA2), regen generates 8-char alphanumeric
    - Network menu item renamed from Wifi to WiFi Mode
    - Captive portal SSID references updated
    - Web interface section expanded with AP Mode access details
    - AP Status screen shows actual SSID from device
2026-07-20 Add satellite tracking web interface
    - REST API endpoints: GET /getpos, POST /setpos, GET/POST /elf
    - Standalone tracking UI (satellite-tracker/index.html) with:
    - Satellite tracking with satellite.js integration
    - Pass prediction table with Date, AOS, AOS Az, LOS Az, Max El (@Az), LOS, Duration
    - Polar plot with elevation/azimuth grid, satellite and rotator positions
    - Tracking tab: satellite selector, target/rotator displays, polar plot
    - Satellites tab: add/manage satellites via NORAD ID or TLE paste
    - Pass Predictions tab: upcoming passes table
    - Control tab: Button control (hold-to-move), Manual Position entry
    - Settings tab: device IP, station location, update interval,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
2026-07-20 Replace hardcoded Quick Add with dynamic satellite management
    - Remove hardcoded QUICK_SATS list
    - Add 'Browse Amateur Radio Satellites' feature loading from CelesTrak GROUP=amateur
    - User can select satellites from the browse list to add to their collection
    - Satellite list persisted in localStorage
    - 'Refresh All TLEs' button to update orbital elements for all stored satellites
    - fetchTleOrCsv() automatically falls back to CSV format for NORAD >= 100000
    - Satellites tab now shows: Your Satellites list, Browse section, Add manually section
    - Added satellites marked with checkmark in browse list
    - Satellite count displayed in header
2026-07-20 Move Browse/Add to modal; add Sort by Name button
    - Satellites tab now shows only 'Your Satellites' list (cleaner)
    - Added 'Manage Satellites' button that opens a modal dialog
    - Modal contains Browse Amateur Radio Satellites and Add Satellite sections
    - Added 'Sort by Name' button to alphabetically sort the satellite list
    - Modal closes on X button, click outside, or after successfully adding a satellite
    - Modal CSS added with overlay and scrollable content
2026-07-20 Style modal buttons; improve modal sizing
    - Sort by Name button: green background (#238636)
    - Manage Satellites button: blue background (#1f6feb)
    - Modal now auto-sizes vertically with browser window (max-height: calc(100vh - 40px))
    - Modal centered vertically with flexbox
    - Browse satellite list in modal can grow to show more satellites on larger screens
2026-07-20 Style Refresh button consistently with others
    - Refresh All TLEs: amber/gold background (#d29922)
    - Sort by Name: green (#238636)
    - Manage Satellites: blue (#1f6feb)
    - All three buttons now white text on colored backgrounds
2026-07-20 Style CelesTrak buttons with distinct colors
    - Load List from CelesTrak: purple (#8957e5)
    - Fetch from CelesTrak: green (#3fb950)
    - All buttons now have clear, distinct colored backgrounds
2026-07-20 Move Add Satellite to its own tab
    - Added new 'Add Satellite' tab between Satellites and Pass Predictions
    - Removed Add Satellite section from the modal (now just Browse Satellites)
    - Renamed modal button to 'Browse Satellites' for clarity
    - Modal now only shows the CelesTrak browse list, giving it more space
2026-07-20 Filter CelesTrak list to show only unavailable satellites
    - CelesTrak Add tab now hides satellites user already has
    - Shows count of available satellites
    - Displays message if all satellites are already added
2026-07-20 Fix satellite filter: normalize NORAD IDs to numbers
    - Stored norad is a string but browse handler compares with parseInt()
    - Now converts stored norad values to numbers for proper comparison
2026-07-20 Add Next Pass button to Satellites tab
    - Shows table with next AOS time, minutes until AOS, max elevation for each satellite
    - Results sorted by minutes until AOS (soonest first)
    - Searches 48 hours ahead with 1-minute resolution
    - Includes 'Select' button to quickly switch to that satellite
    - 'Back to List' button returns to normal satellite list view
    - Uses same pass detection logic as Pass Predictions tab
2026-07-20 Fix Next Pass radians/degrees conversion
    - computeTopo returns elevation in radians but minEl is in degrees
    - Added conversion: elDeg = el * 180 / Math.PI
    - Also converts azimuth to degrees for maxElAz display
2026-07-23 Prevent relay clicking: only send position when it changes
    - Added threshold check: only send setPosition if Az or El changed by > 0.5°
    - Tracks lastSentAz/lastSentEl to detect meaningful position changes
    - Resets when tracking stops
    - Eliminates unnecessary relay clicks when position is stable
2026-07-23 Clean up debug logging, keep threshold check
    - Removed verbose console.log calls from setPosition and computeAndSend
    - Kept the 0.5° threshold to prevent relay clicking
    - Firmware /setpos already uses executeProtocolAzMove/ElMove for intelligent movement
2026-07-23 Reduce protocol movement threshold to 0.3° for smoother tracking
    - Changed executeProtocolAzMove threshold from 1.0° to 0.3°
    - Changed executeProtocolElMove threshold from 1.0° to 0.3°
    - Removed browser-side threshold (rely on firmware logic)
    - Browser now sends position every interval; firmware decides if movement needed
    - 0.3° threshold prevents relay clicking while maintaining smooth tracking
    [ycint.ino]
2026-07-23 Revert threshold changes; keep original 1.0° firmware threshold
    - Restored executeProtocolAzMove/ElMove threshold to 1.0°
    - Browser uses 0.5° threshold to avoid unnecessary setPosition calls
    - Firmware 1.0° threshold prevents relay clicking from small position drifts
    [ycint.ino]
2026-07-23 Match browser threshold to firmware: 1.0°
    - Browser now uses 1.0° threshold before calling setPosition()
    - Matches the firmware's executeProtocolAzMove/ElMove threshold
    - Prevents relay clicking from small satellite position drifts
2026-07-23 Reduce auto-stop tolerance to 0.5° for continuous tracking
    - Azimuth auto-stop: 3.0° → 0.5°
    - Elevation auto-stop: 3.0° → 0.5°
    - Original 3° tolerance was designed for single-point targeting
    - For continuous satellite tracking, large tolerance caused premature stops
    - Pattern: rotator moves → stops 3° early → waits → brief movement → stops
    - 0.5° matches the movement threshold for smooth continuous tracking
    [ycint.ino]
2026-07-23 Prevent relay clicking: don't start movement within auto-stop tolerance
    - Added PROTOCOL_STOP_TOLERANCE constant (3.0°) matching auto-stop zone
    - executeProtocolAzMove: if target within 3° and stopped, skip movement
    - executeProtocolElMove: same logic for elevation
    - Prevents relay clicking when new targets arrive within the zone where
    auto-stop would immediately kill movement anyway
    - Movement only starts when target is far enough that auto-stop won't
    immediately trigger
    [ycint.ino]
2026-07-23 Fix relay clicking for geostationary satellites
    - Moved tolerance check to start of executeProtocolAzMove/ElMove
    - Now checks BEFORE setting protocolTargetAzSet/protocolTargetElSet
    - For stopped motors within 3° tolerance: updates target but returns early
    without enabling relays
    - stopAzimuth/stopElevation now clear protocolTarget flags so tolerance
    check works after Stop button is pressed
    - Geostationary satellites: browser sends same position every interval,
    firmware now correctly ignores them (no relay clicking)
    [ycint.ino]
2026-07-23 Fix duplicate variable declarations in executeProtocolAzMove
    - Removed duplicate direction calculation block (curForDiff, tgtForDiff, diff)
    - Now uses the single calculation at the start of the function
    [ycint.ino]
2026-07-23 Improve satellite selection highlighting
    - Satellites list: selected row now has bright blue background (rgba(56,139,253,0.25))
    with 4px left border and bold text
    - Next Pass table: matching selected row highlighting
    - Select button: green background (#238636), changes to grey 'Selected' when clicked
    - Clicking a satellite in Next Pass table highlights the row and updates button state
    - Consistent selection feedback between list view and Next Pass table
2026-07-23 Keep satellite list visible when showing Next Pass table
    - Satellite list stays visible with Remove buttons accessible
    - Next Pass table now appears below the list instead of replacing it
    - Button toggles between 'Next Pass' and 'Hide Passes'
    - Removed confusing 'Back to List' button
    - Users can now see both views and manage satellites from either
2026-07-23 Redesign Satellites tab: auto-refreshing pass table
    - Satellites tab now shows 'Upcoming Passes' table by default
    - Table auto-refreshes every 5 seconds (no manual refresh needed)
    - Removed 'Next Pass' button - table is always visible
    - New 'Manage' tab for satellite list with Remove buttons
    - Moved Refresh All TLEs and Sort by Name to Satellites tab
    - Pass table shows: Satellite, AOS Time, Until, Max El, Select button
    - Selected satellite highlighted with blue background and border
2026-07-23 Consolidate tabs: move CelesTrak Add and Paste Add into Manage
    - Removed separate 'CelesTrak Add' and 'Paste Add' tabs
    - Manage tab now has three sections:
    1. Manage Satellites (list with Remove buttons)
    2. Browse Amateur Radio Satellites (CelesTrak list)
    3. Add Satellite (paste TLE or fetch by NORAD)
    - Tab order: Tracking | Satellites | Manage | Pass Predictions | Control | Settings
2026-07-23 Add sub-tabs to Manage: Remove | CelesTrak Add | Paste Add
    - Manage tab now has sub-tabs for cleaner organization
    - Remove: shows satellite list with Remove buttons
    - CelesTrak Add: browse and add from CelesTrak
    - Paste Add: paste TLE or fetch by NORAD ID
    - Separated main tab and sub-tab switching logic
2026-07-23 Fix: calling fetchTleForNORAD directly instead of clicking hidden button
    - Browse satellite Add button now calls fetchTleForNORAD() directly
    - Previously tried to click fetchTleBtn which is hidden in Paste Add sub-tab
    - Clicking hidden buttons doesn't reliably trigger handlers
    - Added console logging for debugging
2026-07-23 Add AOS/LOS timer on Tracking page
    - Shows 'AOS in: MM:SS' when satellite below horizon (<=60 min)
    - Shows 'AOS in: HH:MM:SS' when AOS > 60 minutes
    - Shows 'LOS in: MM:SS' when satellite above horizon
    - Shows 'AOS: Never' or 'LOS: Never' for geostationary satellites
    - Updates every second, uses configured minimum elevation
2026-07-23 Fix LOS timer to show seconds, move Range to separate line
    - LOS timer now shows seconds (was only showing minutes)
    - LOS format: 'LOS in: MM:SS' or 'LOS in: HH:MM:SS' if > 60 min
    - Changed movement-indicator from inline-flex to flex so Range
    appears on its own line below the AOS/LOS timer
2026-07-23 Fix AOS/LOS timer to show real-time seconds countdown
    - Cache AOS/LOS absolute times, recompute every 60 seconds
    - Display counts down in real-time using cached absolute timestamp
    - Seconds now change every second instead of always showing :00
2026-07-23 Center AOS/LOS and Range labels, add divider line
    - Added subtle divider line between Az/El and AOS/LOS/Range
    - Centered AOS/LOS timer and Range text with justify-content: center
    - Visual hierarchy: Az/El values above divider, computed info below
2026-07-23 Fix polar plot: use inPast flag instead of broken time comparison
    - currentSegment[0].time was undefined (stores {x,y}, not time)
    - All segments were incorrectly going to futureSegments
    - Now uses inPast boolean flag to track past vs future segments
    - Applies to both online and offline rendering paths
2026-07-23 Limit polar plot trajectory to current/next pass only
    - First scans 12 hours at 30s intervals to find next AOS/LOS
    - Then computes detailed trajectory only for that single pass
    - If satellite currently above horizon, starts from now
    - If no AOS found, shows no trajectory
    - Prevents multiple passes from cluttering the plot
2026-07-23 Satellites tab: show LOS countdown when overhead, HH:MM:SS format
    - When satellite currently overhead (El >= minEl), show time until LOS
    - Format as MM:SS (< 60 min) or HH:MM:SS (> 60 min)
    - Uses monospace font for aligned time display
    - Interpolates LOS time for more accurate countdown
2026-07-24 Clamp elevation to 0 minimum when sending to rotator
    - When satellite is below horizon, send El=0 instead of negative value
    - Display still shows actual computed elevation (can be negative)
    - Rotator position tracking uses clamped value
2026-07-24 Command rotator to AOS position when satellite is below horizon
    - Added findNextAos() function to scan for next AOS time
    - startTracking() now checks if satellite is below horizon
    - If below horizon: computes position at AOS time and commands there
    - If above horizon: commands current position immediately
    - Antenna now points toward where satellite will be when it rises
2026-07-24 Add AOS/LOS azimuth display below timer
    - Shows 'AOS Az: DDD°' when satellite is below horizon
    - Shows 'LOS Az: DDD°' when satellite is above horizon
    - Azimuth formatted as 3 digits with degree symbol
2026-07-24 Align colons in SATELLITE box labels
    - Added .aoslos-label class for consistent 60px right-aligned labels
    - Applied to AOS/LOS timer, AOS/LOS Az, and Range displays
    - Colons now line up vertically regardless of label length
2026-07-24 Satellite tracker: geostationary infinity display, row colors, polar plot fix, auto-stop
    - Detect geostationary satellites from orbital elements (mean motion, inclination, eccentricity)
    - Show ∞ symbol for LOS of geostationary/never-sets satellites in Satellites tab and Tracking tab
    - Fix real-time timer overwrite of ∞ by adding data-neversets attribute
    - Selected row: orange background; overhead satellites: green text (both can coexist)
    - Clear selection on page reload to avoid stale state
    - Fix polar plot trajectory jumping to next orbit: check current elevation first
    - Auto-stop tracking when satellite drops below minElevation (LOS)
2026-07-25 SatNOGS integration: add implementation plan
    Document the full plan for integrating SatNOGS DB API data:
    - Satellite status (alive/re-entered/active transmitters)
    - Multi-row transmitter display with frequencies and modes
    - Active satellites filter toggle
    - Tracking tab frequency/mode display
    - Manage tab refresh controls with configurable 7-day interval
    - 6-phase implementation roadmap
2026-07-25 feat: SatNOGS DB integration for satellite status and frequencies
    - Add SatNOGS API integration for satellite status and transmitter data
    - New columns in Satellites tab: Status dot, DL Freq, UL Freq, Mode
    - Multi-row display for satellites with multiple transmitters
    - 'Show only active satellites' filter toggle (persists in localStorage)
    - Frequency/mode display in Tracking tab with expandable list
    - Manage > SatNOGS Data sub-tab: refresh button, interval setting, status
    - Auto-refresh stale data on page load
    - Fetch-on-demand when adding satellites
    - localStorage caching with configurable refresh interval (default 7 days)
    - Version bumped to v1.3.0
    Also adds:
    - server.py: Local dev server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
2026-07-25 fix: SatNOGS proxy stability - limit responses to 4KB, use persistent client
    - Add ESP8266HTTPClient include
    - Fix GPIO aliases for ESP8266 core v3.x (D2->4, D3->0, etc.)
    - Implement /satnogs-proxy endpoint with persistent WiFiClientSecure
    - Limit responses to 4KB to prevent heap exhaustion/crashes
    - Reject larger responses with 503 error instead of crashing
    - Use stream->readString() for reliable SSL body reading
    [ycint.ino]
2026-07-25 feat: SatNOGS manual refresh workflow and proxy settings
    - Replace auto-fetch with manual refresh (Selected/New/Stale buttons)
    - Track fetch history with hasSatNOGSDataEver() and last refresh date
    - Add SatNOGS Data tab with stats, stale threshold, satellite selector
    - Add proxy settings UI (ESP proxy, Custom proxy, Direct modes)
    - Increase fetch timeout to 180s for slow ESP proxy responses
    - Show estimated refresh time warnings for ESP proxy mode
    - Python dev server proxy fallback
2026-07-25 fix: Update ESP proxy warning message to reflect current 4KB limit behavior
2026-07-25 feat: Split SatNOGS refresh into Status and Frequencies buttons
    - Replace single 'Refresh Selected' with 'Refresh Status' and 'Refresh Frequencies'
    - Status refresh only calls /satellites API (small response, works via ESP proxy)
    - Frequencies refresh only calls /transmitters API (large response, may need custom proxy)
    - New/Stale buttons refresh status only
2026-07-25 feat: Split SatNOGS refresh into separate Status/Freq buttons with color coding
    - Replace single buttons with 6 separate buttons:
    - Refresh Status (blue) / Refresh Freqs (green)
    - New Sats Status / New Sats Freqs
    - Stale Status / Stale Freqs
    - Blue buttons = Status refresh (small response, works via ESP proxy)
    - Green buttons = Frequency refresh (large response, may need custom proxy)
    - Layout: 2 main buttons on top row, 4 smaller buttons on second row
2026-07-25 improve: SatNOGS Data tab layout with clearer labels and sections
    - Group buttons into two labeled sections:
    - 'Selected satellite(s)' - refresh the chosen satellite(s)
    - 'All satellites' - bulk operations on all satellites
    - Renamed confusing buttons:
    - 'New Sats Status' → 'Status: Never Fetched'
    - 'New Sats Freqs' → 'Freqs: Never Fetched'
    - 'Stale Status' → 'Status: Stale Only'
    - 'Stale Freqs' → 'Freqs: Stale Only'
    - Added section labels for clarity
2026-07-25 feat: Add activity log for SatNOGS refresh operations
    - Added activity log area showing real-time progress
    - Each refresh operation logs:
    - Start message with estimated time (if using ESP proxy)
    - Progress for each satellite (N/M: Satellite Name...)
    - Success/failure for each satellite with ✓/✗ icons
    - Final summary
    - Log is cleared at start of each refresh operation
    - Log is not persisted (cleared on page reload)
    - Status message still shown above log for quick reference
2026-07-25 SatNOGS: separate status/frequency tracking and fix proxy
    - Add 'Add ALL' button to CelesTrak browse page
    - Track status and frequencies independently (no status/no freqs)
    - Fix 'Status: Never Fetched' to use getNewStatusSatellites()
    - Fix 'Freqs: Never Fetched' to use getNewFreqSatellites()
    - Fix hasSatNOGSStatus() to handle undefined satellite field
    - Don't mark satellites as fetched when no transmitters found
    - Show stats on two lines to avoid overflow
    - Add debug logging to SatNOGS proxy server
2026-07-25 Satellites tab: Freq/Modes toggle, alternating colors, red divider
    - Add 'Freq/Modes' toggle switch to show/hide DL/UL/Mode columns
    - Alternating blue/green backgrounds per satellite group (all freq rows share color)
    - Red divider line between overhead and upcoming passes
    - Fix: load localStorage settings before rendering tables
2026-07-25 Fix AOS/LOS consistency and polar plot trajectory
    - Satellites tab: cache pass data for 60 seconds, don't recompute on every tab switch
    - All tabs now use 0° (horizon) for AOS/LOS display, not min elevation setting
    - Tracking tab: recompute LOS/AOS more frequently near events (every second within 30s)
    - Tracking tab: don't let next orbit's pass overwrite current cached LOS
    - Tracking tab: check actual elevation to clear LOS immediately when below horizon
    - Tracking tab: handle negative diff in AOS/LOS timer (show ---:--:--)
    - Polar plot: extend trajectory from horizon to horizon (0°)
    - Polar plot: orange dashed line for path below min elevation
    - Polar plot: search backward for AOS when sa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
2026-07-25 Fix AOS/LOS timer and Satellites tab caching
    - Polar plot: search backward for AOS when satelli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
2026-07-26 feat: Add Alt Sync buttons for pre-cached SatNOGS data
    - Alt Sync Status/Frequencies buttons in SatNOGS Data panel
    - Fetches CSV files from GitHub Pages (wklaaks.github.io/azelctrl-sat-data)
    - Parses sat-status.csv and sat-freqs.csv into localStorage
    - Converts MHz to Hz, preserves all transmitter fields
    - Shows generation timestamp from metadata.json
    - Log entries in activity log
    - GitHub Pages already sends CORS headers, no proxy needed
2026-07-26 fix: Alt Sync sets hasActiveTransmitters for active filter
    Alt Sync Frequencies now sets hasActiveTransmitters based on
    transmitter alive flags, matching the behavior of direct proxy sync.
    This fixes the 'Show only active satellites' filter which was
    filtering out all satellites after Alt Sync.
2026-07-26 feat: Auto-detect wrap boundary crossing and prompt for ELF mode
    When user clicks 'Start Tracking', check if the satellite pass
    crosses the rotator's wrap boundary (180° for N360 or 0°/360° for S360).
    If ELF mode is not already enabled and a crossing is detected:
    - Show confirm dialog with pass times and boundary info
    - If user accepts: enable ELF mode on device, then start tracking
    - If user declines: don't start tracking
    Detection samples pass track at 15-second intervals and checks
    for azimuth crossings through either boundary. Only flags genuine
    crossings (< 170° jump) to avoid false positives from wrap-around.
2026-07-26 feat: Add rotator model endpoint and use it for ELF mode detection
    Firmware:
    - Add GET /api/rotator endpoint that returns rotator model and physical stop angle
    - Returns JSON: {model: 'N360'|'S360'|'N450'|'S450', physicalStop: angle}
    UI:
    - Fetch rotator model from device on startup via /api/rotator
    - Use the actual physical stop angle for wrap boundary detection
    - N360: 180° boundary (North-facing, cannot cross South line)
    - S360: 0° boundary (South-facing, cannot cross North line)
    - N450: 135° boundary (North-facing, cannot cross SE line)
    - S450: 315° boundary (South-facing, cannot cross NW line)
    - Skip detection if rotator model is unknown (graceful fallback)
    - Fix boundary label disp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
    [ycint.ino]
2026-07-26 feat: Add forbidden zone for N450/S450 models (two boundaries)
    N360/S360 have a single wrap boundary (180°/0°), but N450/S450
    have a 90° forbidden zone between two boundaries:
    - N450: 135° to 225° (SE-SW through South)
    - S450: 315° to 45° (NW-NE through North)
    The 450 models can track more passes without ELF mode since they
    have a wider range (450° vs 360°). Detection now tracks whether
    the pass trajectory enters the forbidden zone rather than crossing
    a single line.
    Firmware: /api/rotator returns forbiddenZone: [start, end]
    UI: isInForbiddenZone() handles both single-point and arc zones
2026-07-26 fix: Use hard stop angles instead of forbidden zone for ELF detection
    N360/S360 have one hard stop (360° range):
    - N360: 180° (South)
    - S360: 0° (North)
    N450/S450 have two hard stops (450° range):
    - N450: 135° (SE) and 225° (SW)
    - S450: 315° (NW) and 45° (NE)
    The 450 models can track through the 180° South heading — they
    only need ELF mode if the pass crosses beyond either hard stop.
    This means many more passes can be tracked without ELF mode.
    Firmware: /api/rotator returns stops: [angle, ...]
    UI: Check if pass trajectory crosses any of the stop angles
    [ycint.ino]
2026-07-26 fix: Direction-dependent hard stops for ELF detection
    The 450 models have TWO hard stops, but only ONE is active depending
    on rotation direction:
    - N450 rotating CW (increasing AZ) -> stops at 225° (SW)
    - N450 rotating CCW (decreasing AZ) -> stops at 135° (SE)
    - S450 rotating CW -> stops at 45° (NE)
    - S450 rotating CCW -> stops at 315° (NW)
    The detection now samples the pass trajectory, determines rotation
    direction between consecutive samples, and checks only the relevant
    stop for that direction. This matches the firmware's mechanicalAzOffset
    clamping at ±225° with shortest-path selection.
    [ycint.ino]
2026-07-26 refactor: Move ycint.ino into ycint/ directory for Arduino CLI structure
2026-07-26 feat: Add Sat-Hide and Freq-Hide toggles for filtering passes and frequencies
    Sat-Hide toggle:
    - When ON, shows Hide/Unhide button next to each satellite
    - Hidden satellites are filtered from the pass table
    - Toggles persist in localStorage
    Freq-Hide toggle:
    - When ON and Freq/Modes is ON, shows hide buttons on each frequency row
    - Hidden frequencies are filtered from both the pass table AND tracking display
    - Allows users to filter out unwanted transponders on satellites
    - Hidden state persists in localStorage
    Both toggles are ON by default (showing hide buttons) to encourage
    users to clean up their satellite list and frequency view.
2026-07-26 fix: Make Satellites tab filter controls sticky during scroll
    The Satellites tab now has a fixed header with scrollable content:
    - Tab container uses flex column with overflow:hidden
    - Card uses flex column so the table area takes remaining space
    - Filter row is position:sticky with card background so it stays visible
    - Only the satellite pass table scrolls, controls stay pinned at top
2026-07-26 fix: Invert Sat-Hide and Freq-Hide button visibility
    - Buttons now show when toggle is OFF (configure mode)
    - Filtering applies when toggle is ON (active mode)
    - Toggles default to OFF so buttons are visible immediately
    - Fixed freq-hide button handler to use freqKey matching
    - Fixed visibleTransmitters to always filter by hiddenFreqs
    - Added satHideOn/freqHideOn to cache invalidation keys
2026-07-26 fix: Freq-Hide button now works — store freqKey directly as data attribute
    The button click handler was failing because data-* attributes are always
    strings, but freqKey values contained numbers. Instead of trying to
    reconstruct the key from multiple data attributes, store the complete
    key directly and toggle it in the Set.
2026-07-26 fix: Freq-Hide filtering now works — pass correct NORAD ID to visibleTransmitters
    visibleTransmitters was using satNOGS.satellite_norad (number from API)
    while the button stored keys with p.sat.norad (string from localStorage).
    The keys never matched, so no frequencies were ever filtered. Now all
    callers pass the NORAD ID explicitly as a parameter.
2026-07-26 fix: Freq-Hide icons now intuitive — ☑ visible, ☐ hidden
2026-07-26 fix: Increase freq-hide button size for better visibility
2026-07-26 fix: Freq-Hide button colors — orange for visible (☑), red for hidden (☐)
2026-07-26 fix: Reduce freq-hide button padding for tighter box
2026-07-26 refactor: Replace Sat-Hide buttons with checkboxes matching Freq-Hide style
    - Sat-Hide now uses ☑ (green) / ☐ (red) checkboxes like Freq-Hide
    - Moved to dedicated 'SH' column next to 'FH'
    - Both column headers hidden when respective toggle is ON
    - Removed old 'Hide' text buttons
2026-07-26 fix: Update pass-divider colspan to match new column count (9 → 11)
2026-07-26 fix: FH checkboxes use ✗ instead of ☐ for hidden state
    Both SH and FH now use consistent styling:
    - ☑ (green/orange) = visible
    - ✗ (green/orange) = hidden
    No more red backgrounds — hidden state shown by ✗ symbol only.
2026-07-26 fix: Collapse empty FH/SH columns to 0 width when toggles are ON
    When Freq-Hide or Sat-Hide is enabled, the corresponding column headers
    and row cells now use width:0;padding:0 instead of reserving 28px.
    This prevents unnecessary whitespace from pushing the Select button
    off-screen on narrow windows.
2026-07-26 refactor: Improve typography and color consistency across UI
    - Card titles: brighter (var(--text)), bolder (600), slightly larger (0.9rem)
    - Table headers: brighter (var(--text)), bolder (600), larger (0.8rem)
    - Satellites table headers: same treatment for consistency
    - Pos labels: fix broken --fg variable, use var(--accent)
    - Filter labels: brighter (var(--text)) for readability
    - UNTIL column: remove inline font-weight/monospace to match other cells
2026-07-26 fix: Global placeholder styling to make hint text clearly distinguishable
    Added global CSS rule for all input/textarea placeholders:
    - Dark grey color (#484f58) — not bright like user input
    - 50% opacity — visibly fainter
    - Italic font — visual distinction from entered values
    This fixes the recurring issue where users mistake placeholder hint
    text (e.g. 'Custom Proxy URL', 'Device IP', 'Paste TLE lines...')
    for actual saved values.
2026-07-26 Refine UI: fix ELF detection, persist selection, modernize color scheme
    - Fix ELF mode false positive: use shorter-arc check for 180° crossing
    - Persist selected satellite across page reloads
    - Refresh TLE per-satellite button in Manage tab
    - Rename 'Remove' tab to 'Manage'
    - Modernize color scheme: blue gradient backgrounds, vibrant labels
    - Polar plot: blue grid, labels, background, fix S/W/E label overlap
    - Tracking page: larger satellite dropdown, uppercase label
    - Control page: gradient direction/stop buttons, remove intermediate status text
    - Satellites page: Active/Upcoming section headers, blue row alternation
    - Settings: show last save time for configuration
    - Toggle switches: full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
2026-07-28 Fix satellite dropdown: alphabetical sort, arrow key navigation, and missing brace
    [listen_debug.py, ycint.ino]
2026-07-28 Add debug logging feature to settings page
    - Debug card with JavaScript Logging toggle (persisted to localStorage)
    - Console log capture with 500-line rolling buffer
    - 'Copy Console Logs' button for troubleshooting
    - debugLog() helper function gated by toggle
    - Styled Convert, Refresh, and Copy Logs buttons (indigo)
2026-07-28 UI improvements: divider colors, alternating rows, sort by number, layout fixes
    - Match Tracking/Frequencies dividers to Rotator blue (#1e4d8c)
    - Add alternating row colors to Manage satellite list
    - Add Sort by Number button in Manage tab
    - Move Refresh All TLEs button to right, sat count above buttons
    - Add flex-wrap to tabs for narrow windows
    - Remove min-width constraint on body children
    - Fix footer version number color to match footer text
2026-07-28 Add predictive leading tracking algorithm and fix Dead Zone UI initialization
    - Implement predictive leading: antenna aims leadTimeSec (default 10s) ahead
    - Track minDistAchieved to wait until satellite passes target before re-commanding
    - Dead Zone hysteresis: only re-command when distance exceeds deadZoneDeg (default 2.0°)
    - Fix Dead Zone dropdown: use toFixed(1) for exact string matching with HTML options
    - Fix beginTracking(): use currentEl < 0 instead of currentEl < minEl for mid-pass tracking
    - Add Lead Time and Dead Zone settings to Settings tab with localStorage persistence
2026-07-28 Serve satellite tracker from ESP via gzip-compressed PROGMEM
    - Auto-detect ESP origin: when served from device, use window.location.origin
    instead of requiring manual IP address entry
    - Compress index.html (203 KB) to 45 KB gzip, embed as C byte array in firmware
    - ESP serves with Content-Encoding: gzip header (browsers decompress automatically)
    - Fix fetchRotatorModel() early return bug when getApiBase() was empty string
    - Fix sendDirection() guard that blocked Control tab buttons
    - Add BUILD.md documenting build/flash process
    - Add ESP-SERVING-PLAN.md and ORBITAL-MAP-PLAN.md documentation
    [ycint.ino]
2026-07-28 Add general file upload and /files/ serving from SPIFFS
    - Generalize /upload endpoint: accepts any file, saves to SPIFFS
    - Add /files/ route: serves files from SPIFFS with correct Content-Type
    - Auto-detect gzip: files ending in .gz get Content-Encoding: gzip
    - Support PNG, JPG, SVG, and other asset types
    - Update Settings UI: separate HTML upload and general file upload
    - Files accessible at /files/filename after upload
    [ycint.ino]
2026-07-28 Comment out Serial.print calls during protocol operation
    Fix: Remove Serial.print from dpSend() and protocolSend() — these
    echoed protocol responses to serial, breaking GS-232A/B clients.
    Comment out Serial.print calls that fire during rotator mode:
    - Safety warnings (AZ/EL limits)
    - Menu navigation, ELF toggle, restart, setup entry
    Keep Serial.print in setup/boot/calibration paths — these only
    fire during configuration, not during protocol operation.
    [ycint.ino]
2026-07-28 Fix: continue tracking to 0° elevation, not minElevation
    minElevation is an AOS threshold — once tracking starts, the
    satellite should be followed all the way to the horizon (0°),
    not stopped when it drops below minElevation.
2026-07-28 Switch from time-based to angle-based predictive leading
    Lead the antenna by a fixed angular distance (degrees) along the
    satellite's apparent path instead of a fixed time (seconds).
    This adapts automatically to satellite angular speed — keeps
    consistent lead whether the satellite is moving fast (high
    elevation) or slow (low elevation).
    Default: 3.0° lead angle
2026-07-28 Fix: use 0.1s samples for angle-based leading to prevent elevation overshoot
2026-07-28 Add SPIFFS file management: list/delete files UI + firmware endpoints; fix button text colors to white
    [ycint.ino]
2026-07-29 Replace all Settings 'Save' buttons with auto-save on change; implement kinematic rendezvous tracking algorithm with rotator speed measurement
2026-07-29 Rename 'Save Configuration' button to 'Export Configuration'
2026-07-29 Fix ELF warning timing and Positioning/Waiting status
    - Use findNextAos directly for ELF boundary check instead of getCurrentOrNextPass
    (which could return null when LOS search fails)
    - Added findLosFromAos helper for reliable pass detection
    - Pre-AOS status now shows Positioning while rotator moves, not immediately Waiting
    - Reset cachedIsOverhead and cachedNeverSets on all cache invalidation points
    - AOS/LOS display updates immediately when switching satellites
2026-07-30 Add offline Canvas Map tab with coastlines, ground tracks, and pan/zoom
    - Fix HTML merge: move orbital-map.js inline script inside </body> (was after </html>)
    - Add Map tab with #orbitalMapContainer canvas, Day/Night and Grid checkboxes
    - Inline orbital-map.js (OrbitalMapRenderer class, 833 lines) into index.html
    - Initialize showGrid=true in constructor, fix trackSatSelect null check
    - Coastline data served from SPIFFS (world_coastline.js.gz), not firmware
    - Map tab: coastlines display, satellite ground tracks plot, pan/zoom functional
    - Terminator shading deferred (checkbox present, unchecked by default)
    [ycint.ino]
2026-07-30 Map: future-only ground track with adjustable duration dropdown (default 180 min)
    - Remove past track computation and rendering entirely
    - Add Duration dropdown (30min to 6hr, default 3hr/180min) to Map tab header
    - generateGroundTrack now only computes future points
    - Ground track rendered as solid red line (was dashed for future, solid for past)
    - updateOrbitalMap reads duration from dropdown, recomputes on change
    - Update orbital-map.js source and inlined version in index.html
2026-07-30 Map: 5-color orbit tracks, thinner lines, orbit-number-based coloring
    - Add ORBIT_COLORS palette (red, blue, amber, purple, green)
    - Split ground track into orbit segments using satrec.no/mo mean anomaly
    - Each orbit segment colored by (orbitNum % 5) using palette
    - Reduce line width from 4 to 2
    - Remove past track entirely
    - Update both orbital-map.js and inlined index.html
2026-07-30 Fix: orbit track not displaying — correct mean motion units (rad/min) and epoch fallback
    - satrec.no is in rad/min, not rad/s — use elapsedMin = elapsedSec / 60
    - Fallback epochMs to now.getTime() if jdsatepoch is undefined
    - Use local variables (no, mo) with fallbacks to prevent NaN propagation
    - Fix ORBIT_COLORS typo (#a78ba -> #a78bfa)
2026-07-30 Fix: large triangular fills at map edges when panning — use evenodd fill rule
    - _drawRing was closing subpaths at world-edge wraps, causing ctx.fill()
    to create large triangular polygons spanning the map
    - Switch to evenodd fill rule and don't close subpaths at wraps —
    just moveTo() to break the path without closing
    - Also set fillStyle/strokeStyle/lineWidth explicitly in _drawRing
    to avoid state leakage from other draw calls
2026-07-30 Fix: large triangular fills at map edges when panning
    - _drawRing split into subpaths at world-edge wraps, each filled
    individually with closePath() — prevents large triangular fill
    artifacts spanning the map when rings cross the antimeridian
    - Removed evenodd approach (created holes in polygons)
    - Explicitly set fillStyle/strokeStyle/lineWidth in _drawRing
2026-07-30 Fix: replace closePath() with canvas-edge close for map fill
    Replaces the naive closePath() approach in _drawRing() with canvas-edge-
    aware closing paths. This fixes triangle artifacts in three scenarios:
    1. Panning artifacts — when a landmass (Alaska, etc.) crosses the left or
    right map edge, the 0.8w split creates subpaths at each edge. Instead
    of closePath() drawing a diagonal line from the subpath's last point to
    its first (cutting across the map), the path now closes to the nearest
    canvas edge (x=0 or x=w) and runs along it.
    2. Antarctica — the full-width ring spanning [0, w] is detected as
    isFullWidth (span > 0.8w) and closed via the bottom edge.
    3. Arctic islands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
2026-07-31 Fix: separate fill/stroke paths and add wrapsGlobe for polar rings
    Three fixes to the canvas-edge close in _drawRing():
    1. Separate fill and stroke paths — The edge-close lines (to x=0 or x=w)
    are now only part of the fill path. The stroke follows only the
    coastline, eliminating the visible horizontal/vertical border-
    colored lines appearing at the canvas edge.
    2. Add wrapsGlobe check — Rings with longitude range > 300° (like
    Antarctica spanning 359.8°) always use polar top/bottom close mode,
    regardless of centerLon. This prevents closePath() from cutting
    through the polar region when the map is panned.
    3. Fix else-if priority — isFullWidth is now checked BEFORE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
2026-07-31 Fix: use point-in-ring test instead of winding formula
    Replaces the heuristic winding formula (isCW === goingDown) with an
    actual point-in-ring winding number test. For each edge-touching
    subpath, a test point between the coastline and the canvas edge is
    checked against the ring's unwrapped projected points. If the test
    point is inside the ring, edge-close fills the land and is used.
    If outside, edge-close would fill the ocean — closePath is used
    instead.
    Ring unwrapping removes the antimeridian discontinuity so the
    winding number test is valid across the map edge.
    This correctly handles all cases verified by simulation:
    - North America Subpath 8 (1470 pts, LEFT, DOWN): inside=True → e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
2026-07-31 Fix map fill artifacts via longitude unwrapping
    The triangle/wedge artifacts came from the decomposition, not the closing
    rule. All 12 previous attempts split each ring at the map seam and then
    guessed how to close the fragments -- but split fragments are open
    polylines with endpoints on opposite canvas edges, so fill() must invent a
    closing edge, and no rule is correct for all of them. Hence the endless
    trade: edge-close preserved landmass but filled ocean with land colour,
    while closePath() avoided that but cut diagonals through continents.
    Fix: never split. Walk each ring in continuous unwrapped longitude
    (accumulate the shortest step between points) so x never jumps the seam,
    yielding o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
2026-07-31 Add satellite footprint (visibility circle) to orbital map
    - Compute footprint circle as acos(R/(R+h)) with 360-point ring
    - Draw as translucent green fill with dashed outline via _drawRing
    - Add Footprint toggle checkbox (on by default) to map controls
    - Clamp acos/asin inputs to [-1,1] to prevent NaN from floating-point edge cases
    - Guard against NaN/null/micro-altitudes with !altKm check
    - Clear stale footprint when satellite propagation returns null
    - Move satellite selector and TLE age display from Tracking tab to header
    - Refresh Pass Predictions when satellite is changed from header dropdown
2026-07-31 Add Moon/Sun toggles, fix altitude formula, reorder tabs, improve map controls
    - Add Moon (🌙) and Sun (☀️) position markers on the orbital map
    - Add computeMoonPosition() using simplified lunar ephemeris
    - Return sunDecDeg from computeTerminator for sun sub-point
    - Persist Moon/Sun toggle states to localStorage
    - Fix altitude formula: correct geometric height above ellipsoid
    - Guard _drawGrid with showGrid flag, add setShowGrid method
    - Reorder tabs: Map, Tracking, Satellites, Manage, Passes, Control, Settings
    - Rename 'Pass Predictions' tab to 'Passes'
    - Center map toggles, add margin between Grid and Moon
    - Update footer text and bump version to v1.5.0
2026-07-31 Add Sun/Moon tracking with AOS/LOS, polar plot paths, and Moon footprint
    - Implement Sun and Moon as selectable tracking targets (indices -2/-3)
    - Add computeAstroTopo() for astronomical az/el computation from sub-point
    - Add getAstroAosLos() to compute rise/set times for celestial bodies
    - Display AOS/LOS timers for Sun/Moon with correct overhead detection
    - Add polar plot trajectory paths for Sun/Moon using astro topo at each time step
    - Compute Moon footprint (altitude 384400 km) on the orbital map
    - Handle Sun/Moon in all UI sections: dropdown, tracking display, map, passes
    - Bump version to v1.5.1
2026-07-31 Move IP field to Settings, remove Refresh button, style file inputs, fix velocity bug
    - Move Device IP address field from header to Settings > ESP Management
    - Rename 'ESP File Management' to 'ESP Management'
    - Remove redundant Refresh button from Passes tab
    - Style file input buttons with themed colors
    - Fix orbital velocity formula: was 60x too high (period in hours vs seconds)
2026-08-01 Update firmware PROGMEM fallback header (index_gz.h) with current index.html.gz
2026-08-01 Bump firmware version v1.0.0 → v1.5.1 to match web UI
2026-08-01 Fix EEPROM overlap bug: move protocol settings from bytes 67-71 to 100-104 (was corrupting calibration data)
    [ycint.ino]
2026-08-01 Fix calibration skip label not updating; fix WiFi Connect menu Back button stuck (missing parent)
    [ycint.ino]
2026-08-01 Fix auto-timer on SETUP menu after calibration skip — updateSetupTimers() was missing before init()
    [ycint.ino]
2026-08-01 Fix Btn1 release misinterpreted as short-press navigation after selecting rotator variant
    [ycint.ino]
2026-08-01 Fix Btn1 carryover after rotator variant selection: wait for button release before returning to SETUP menu
    [ycint.ino]
2026-08-01 Fix watchdog timeout crash: add yield() and wdtFeed() in sendHtml() and sendCoastlineData() chunked sends
    [ycint.ino]
2026-08-01 Fix recursive showStationSettings() call causing stack overflow / menu corruption after WiFi setup
    [ycint.ino]
2026-08-01 Reduce web server drain from 3 to 1 client per loop iteration to prevent blocking button processing
    [ycint.ino]
2026-08-01 Fix PROGMEM chunked send: use memcpy_P() to properly read flash data before sending
    [ycint.ino]
2026-08-01 CRITICAL FIX: saveWifiCredentials() was zeroing all 512 EEPROM bytes instead of only bytes 0-66, wiping rotator model, WiFi mode, calibration, and protocol settings on every credential save
    [ycint.ino]
2026-08-01 Fix notFound handler: send 302 redirect instead of full 66KB HTML (was blocking main loop for OS captive portal probes); add client-connected check to PROGMEM send
    [ycint.ino]
2026-08-01 Clean build v1.5.1: remove debug prints, regenerate PROGMEM fallback with latest web UI
2026-08-01 Auto-AP on first boot + Windows build guide + release builder
    - Auto-start AP mode when allSetupComplete() is false (fresh flash)
    so user can connect via WiFi and upload supporting files immediately
    - Add webServerStarted guard to prevent duplicate route handlers
    - Clean up AP mode (DNS/WiFi) when switching to Station or Disabled
    - BUILD-WINDOWS.md: Windows flashing guide with ESPHome Web (primary),
    Arduino IDE (alternative), correct SSID/password docs
    - build-release.sh: script to compile firmware + package release zip
    [ycint.ino]
2026-08-02 Add map zoom level buttons (100%, 75%, 50%, 25%) centered on QTH
2026-08-02 Fix vertical zoom: scale latitude projection with zoom factor
    Both project() and _drawRing() now use visibleLatRange = 180/zoom
    for latitude-to-canvas mapping. Also fixed Antarctica polar closure:
    winding check uses visibleLonRange instead of 180, and polarY is
    clamped to canvas bounds when zoomed in.
2026-08-02 Fix latitude centering and vertical pan: center on centerLat in project()/_drawRing(), update unproject() for zoom, clamp centerLat to ±85°
2026-08-03 Clamp vertical pan so the map never extends past +-90 latitude
    centerLat could be dragged/wheeled past Bear the pole: when the -90 line
    rose above the canvas bottom, the polar landmass closure kept filling the
    extrapolated past-pole band (Antarctica appeared to continue below 90S),
    and symmetrically past +90 at the top.
    Add _clampLat(): constrains centerLat to +-(90 - 90/zoom) (0 at 100%, 45
    at 50%, 67.5 at 25%), so the visible latitude window stays within +-90.
    Applied in centerOn() (covers zoom buttons, Reset View, sat-follow) and in
    the mouse-drag, wheel, touch-pan, and pinch-zoom-out handlers. At 100% the
    map is now pole-to-pole and cannot pan vertically. Verified on 192.168.88.154
    (bot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
2026-08-03 Map footer: center ZOOM control, replace % buttons with 1-4
    The 100%/75%/50%/25% labels were confusing. Move the zoom buttons to the
    center of the map footer (grid 1fr/auto/1fr keeps the middle truly
    centered), add a 'ZOOM:' label in front, and relabel the four buttons 1-4
    (1=100%, 2=75%, 3=50%, 4=25%). ids/data-zoom/handlers unchanged; hover
    tooltips keep the % on mouseover.
2026-08-03 Fix Sun/Moon map markers; colour the zoom buttons
    Sun/Moon toggles drew nothing: updateOrbitalMap never set the renderer's
    sun/moon positions, computeTerminator computed sunDecDeg but never returned
    it (so the sun sub-point latitude was undefined), and computeMoonPosition
    was missing entirely from index.html (called in 10 places incl. Moon
    tracking, defined nowhere). Add computeMoonPosition (Astronomical Almanac
    low-precision lunar ephemeris, 4 largest perturbations, same JD/GMST
    convention as computeTerminator); return sunDecDeg; populate
    setSunPos/setMoonPos in updateOrbitalMap; restore persisted mapShowSun/
    mapShowMoon toggles on load.
    ZOOM buttons 1-4 get a dark-blue background (#1e3a5f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
2026-08-03 Add Follow Sat toggle to auto-centre the map on the satellite
    Adds a '◎ Follow Sat' button next to Reset View / Center Sat. When active
    (highlighted amber), updateOrbitalMap() runs centerOn(satPos) on every
    update, so the map tracks the satellite without re-clicking Center Sat.
    Clicking on turns it on and centres immediately; off is a plain card.
    mapFollowSat is a session toggle (not persisted).
2026-08-03 Follow Sat: toggle label, idle colour, and zoom anchored on satellite
    - Button now reads 'Stop Following Sat' (amber) while following, 'Follow
    Sat' (dark blue #1e3a5f) when idle.
    - While following, the ZOOM buttons anchor on the satellite's current
    position instead of snapping back to the QTH: mapZoomCenter() returns the
    sat sub-point when mapFollowSat is on, else stationLocation. The zoom
    handlers (single forEach listener; removed the redundant per-button inline
    onclick that duplicated the handler) use it.
2026-08-03 Give Zimbabwe a distinct map colour from South Africa
    Zimbabwe (716) and South Africa (710) both hash to ~green (hue 123 vs 117,
    ~6 deg apart) making them nearly identical on the map. Add a
    COUNTRY_COLOR_OVERRIDES map consulted first by _countryColor() and pin
    Zimbabwe to hsl(208,55%,30%) — a blue clearly distinct from SA. Verified
    rendered rgb: ZW rgb(34,79,119) vs ZA rgb(37,107,38).
2026-08-03 Manual: document current Map tab controls (Zoom presets, Follow Sat, vertical clamp)
    Expand §8.3 Map Controls to cover the centred ZOOM: 1-4 preset buttons,
    Reset View / Center Sat, the Follow Sat toggle (auto-centre every 30 s,
    zoom anchored on the satellite while following), colour-coded POS/ALT/VEL/
    DIST footer, and the +-90 vertical-pan clamp.
2026-08-03 Manual 7.11: expand Firmware Installation into Windows + macOS sections
    Replace the generic 8-step list with a full per-OS guide: release-package
    file table (firmware .bin + 3 support files), ESPHome Web flashing for both
    platforms (Web Serial, no Safari), USB driver matrix (CH340/CP210x), the
    critical 4MB/FS:3MB board layout, and the macOS arduino-cli compile/upload
    commands (nodemcuv2:eesz=4M3M, /dev/cu.usbserial-*). Drawn from
    BUILD-WINDOWS.md and the project's real build workflow.
2026-10-22 v1.5.4: decimal-degree display, USB debug log, same-interface replies, OLED tags
    Decimal Degrees (v1.5.4):
    - Az/El shown as whole degrees by default on OLED and web; optional one-decimal
    display via new "Decimal Degrees" toggle (Settings -> Tracking Preferences)
    - Setting stored in EEPROM byte 105 (loadDisplaySettings/saveDisplaySettings),
    survives power cycles; device is source of truth, web UI syncs on load
    - POST /api/settings/display endpoint; /api/settings GET exposes display block
    - Internal tracking precision unchanged
    Debug USB protocol log (RAM-only ring buffer, zero flash wear):
    - 96-entry buffer capturing serial/TCP RX+TX tagged SER/TCP/DROP/CON, plus
    [OVERFLOW]/[STALL] mar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
    [ycint.ino]
2026-10-22 Remove superseded release zips (v1.5.2, v1.5.3); keep current v1.5.4
2026-10-22 Add persistent release/ folder as single download location
    build-release.sh now stages the four release files (firmware bin,
    index.html.gz, favicon.ico, world_coastline.js.gz) into release/ and
    keeps them there instead of deleting the staging dir. Users can grab
    all flash+upload files from that one folder; it is refreshed on every
    build so it always matches the current firmware. Manual 7.11 points
    users to it.
2026-10-22 Fix debug-log page mojibake; firmware v1.5.5
    /debug-usb viewer showed 'AZELCtrl â€” Protocol Debug Log' because the
    page was served without a charset header, so browsers decoded the UTF-8
    em dash as Windows-1252. Fix both layers:
    - sendProgmemHTML() now sends 'text/html; charset=utf-8'
    - the debug page and the .log download header are now pure ASCII
    (hyphens instead of em dashes, '...' instead of ellipsis) so they can
    never mojibake regardless of headers
    Also bumps FIRMWARE_VERSION 1.5.3 -> 1.5.5 (the v1.5.4 release binary
    still reported 1.5.3; fixed units are now identifiable in the field).
    Release folder + azelctrl-v1.5.5.zip refreshed; superseded v1.5.4 zip removed.
    [ycint.ino]
2026-10-23 Firmware v1.5.8: wall-clock timestamps in protocol debug log (NTP auto-sync + browser Sync-time button, EEPROM-persisted UTC offset); make web-server route registration one-time (fixes handler-node l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
    [ycint.ino]
2026-10-23 Firmware v1.5.9: log NTP time-source transitions only - checkTimeSync re-baselined the reference (and logged 'NTP synced') every 30 s because t != timeRefEpoch is always true once SNTP holds the cloc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
2026-10-23 Firmware v1.5.10: add /diag endpoint exposing the position pipeline (ADC detected, raw voltages, calibration, final az/el) - field-troubleshooting aid for I2C faults where the web shows 0 while the O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
2026-10-23 Add ROTOR OFFLINE/ONLINE detection (v1.5.11)
    Detects whether the Yaesu controller is connected and powered by
    monitoring its +12 V supply rail (DIN-8 pin 7 -> motor-shield VM)
    through a 1.3 MOhm / 200 kOhm divider on the ADS1115 A2 input.
    Sized for the Yaesu's poorly regulated supply: ~1.6 V at 12 V
    nominal, ~2.7 V even at 20 V spikes (inside the ADS1115's
    absolute-max rating).
    - checkRotorPower(): 500 ms sampling, hysteresis thresholds
    (ONLINE >= 1.0 V / OFFLINE < 0.6 V at A2), 5-sample debounce;
    transitions logged to the protocol debug ring
    - Configurable flag, default ENABLED (EEPROM byte 111); toggle in
    web Settings so users without the divider fitted can disable it
    - Surfaces: /s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
2026-10-23 Clarify rotor detection wiring text in web UI settings
